weiweiweiopen/Solar-Oracle-Walkman-1.0/docs/gallery.md

# Solar Oracle Walkman — prototype and renders

## Physical prototype

Physical prototype in the studio

Photograph supplied by Shih Wei Chieh on November 10, 2026. A USB cable is connected. The photograph alone does not establish autonomous operation, calibration or which electrical revision is fitted.

## Two-capacitor charging concept — October 30, 2026

Charging concept front
Charging concept rear, two supercapacitors

From the Murata glass/RFID presentation assets. The source manufacturing revision is the November 3 charge-adg706 PCB paired with the November 5 R19_CHARGE_SUPERCAP enclosure. These illustrations predate that enclosure and are not assembly drawings.

## Earlier three-capacitor concept — September 30, 2026

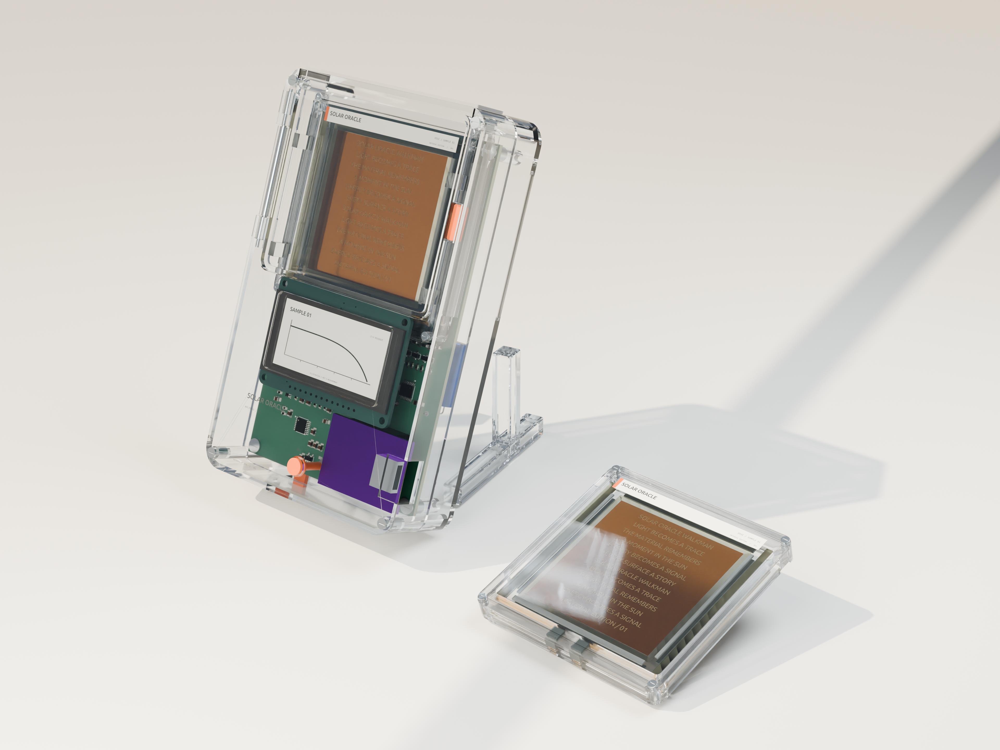
[picture p4: docs/images/render-front-3cap.png]
Earlier front render

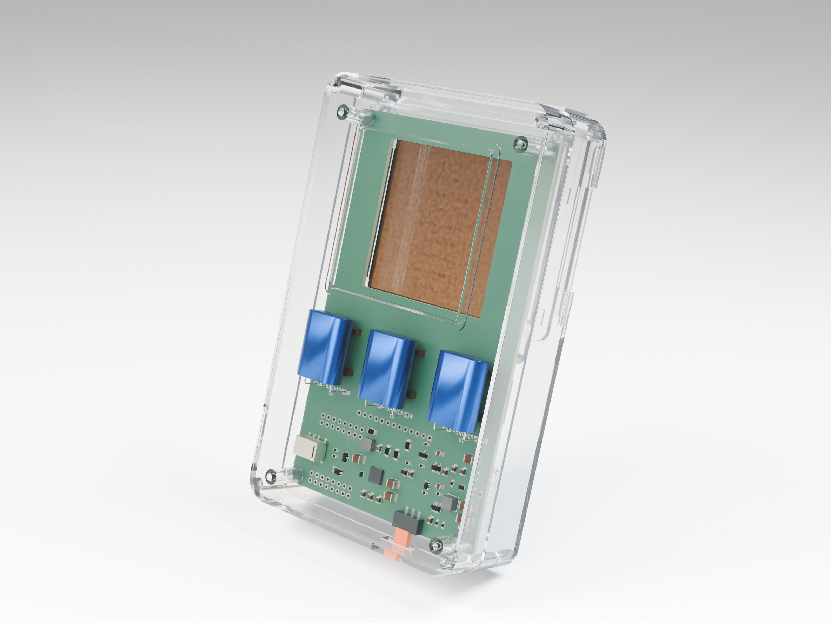
[picture p5: docs/images/render-rear-3cap.png]
Earlier rear render with three blue supercapacitors


From the Murata presentation assets. This is the earlier three-capacitor design, not the current two-capacitor charge-adg706 revision. Do not infer component placement or energy capacity for a current build from this image.

Original image filenames and SHA-256 checksums: [provenance](images/provenance.json).
