weiweiweiopen/Solar-Oracle-Walkman-1.0/enclosure/R19_RAW/STEP/R19_RAW_PRINTED_ASSEMBLY.step

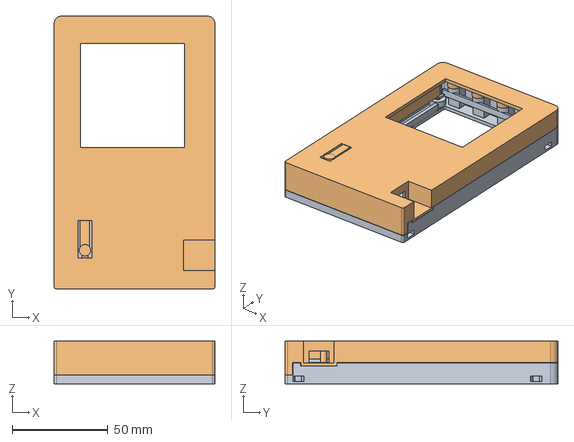
[picture p6: CAD file, 2026-11-10]
enclosure/R19_RAW/STEP/R19_RAW_PRINTED_ASSEMBLY.step
84.0 x 142.4 x 22.2 mm
