weiweiweiopen/Solar-Oracle-Walkman-1.0/enclosure/R19_CHARGE_SUPERCAP/STEP/R19_CHARGE_SUPERCAP_PRINTED_ASSEMBLY.step

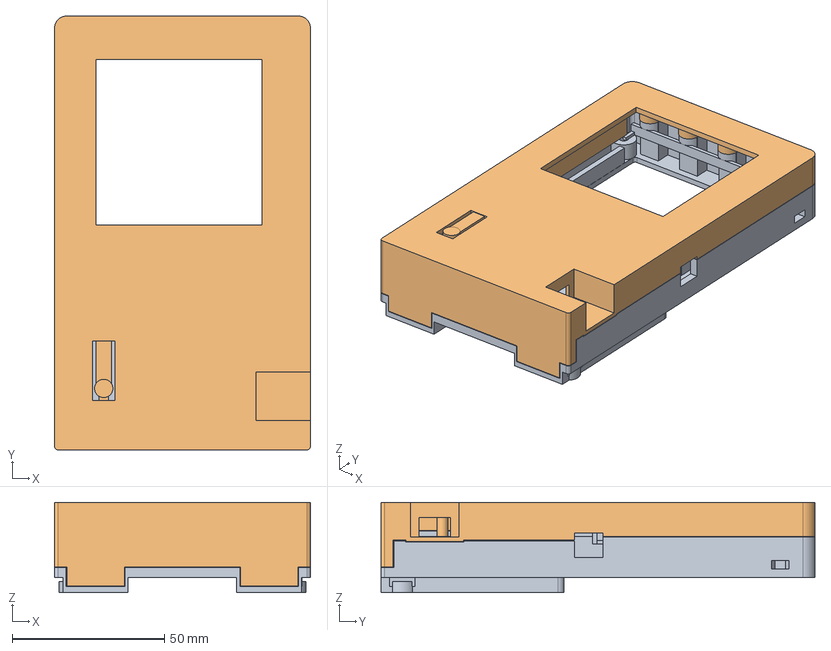
[picture p7: CAD file, 2026-11-10]
enclosure/R19_CHARGE_SUPERCAP/STEP/R19_CHARGE_SUPERCAP_PRINTED_ASSEMBLY.step
84.0 x 142.4 x 29.6 mm
