weiweiweiopen/Solar-Oracle-Walkman-1.0/enclosure/R19_CHARGE_SUPERCAP/R19_CHARGE_SUPERCAP.FCStd

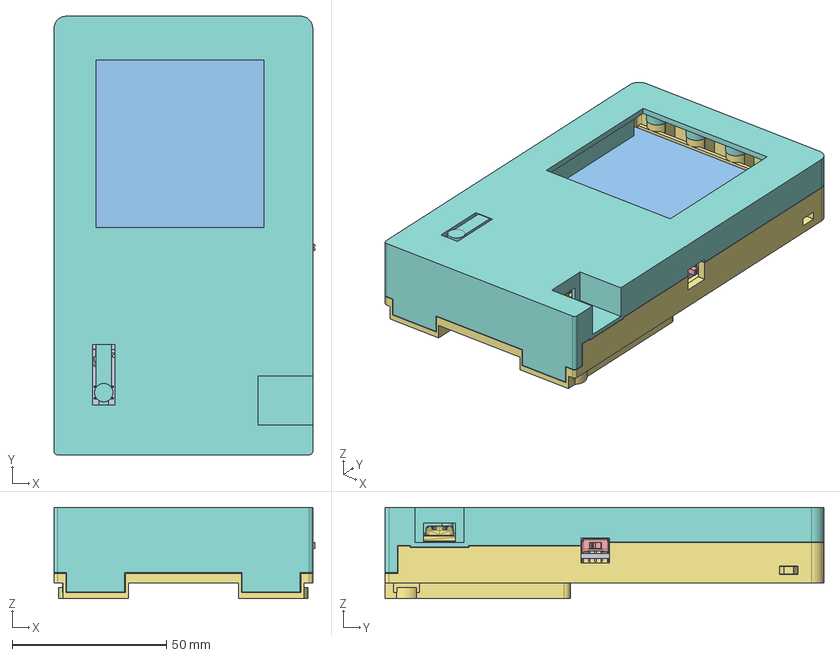
[picture p8: CAD file, 2026-11-10]
enclosure/R19_CHARGE_SUPERCAP/R19_CHARGE_SUPERCAP.FCStd
84.7 x 142.4 x 29.6 mm
Carrier_board
PCB_R9
PCB_R3
PCB_C4
PCB_R18
PCB_R4
PCB_R5
PCB_C5
DSSC_pad_1
DSSC_pad_2
PCB_R23
PCB_C317
PCB_U1
PCB_R19
PCB_R13
PCB_R12
PCB_R22
PCB_R21
PCB_U214
PCB_R24
PCB_R8
PCB_R15
PCB_R16
PCB_SW1
PCB_C2
PCB_C3
PCB_R10
PCB_R17
PCB_JP201
PCB_R1
PCB_R11
PCB_R14
Epaper_module
PCB_U2
PCB_R7
PCB_R2
PCB_R6
PCB_C1
ESP32_module
PCB_R20
PCB_R286
PCB_C336
PCB_Q217
PCB_U211
PCB_R290
Envelope_U207
PCB_C304
PCB_R284
PCB_C312
PCB_C307
PCB_C313
PCB_C308
PCB_C315
Supercap_67_45
PCB_R319
Envelope_L201
PCB_Q218
PCB_C305
PCB_R320
PCB_R323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
