weiweiweiopen/Solar-Oracle-Walkman-1.0/enclosure/R19_RAW/R19_RAW.FCStd

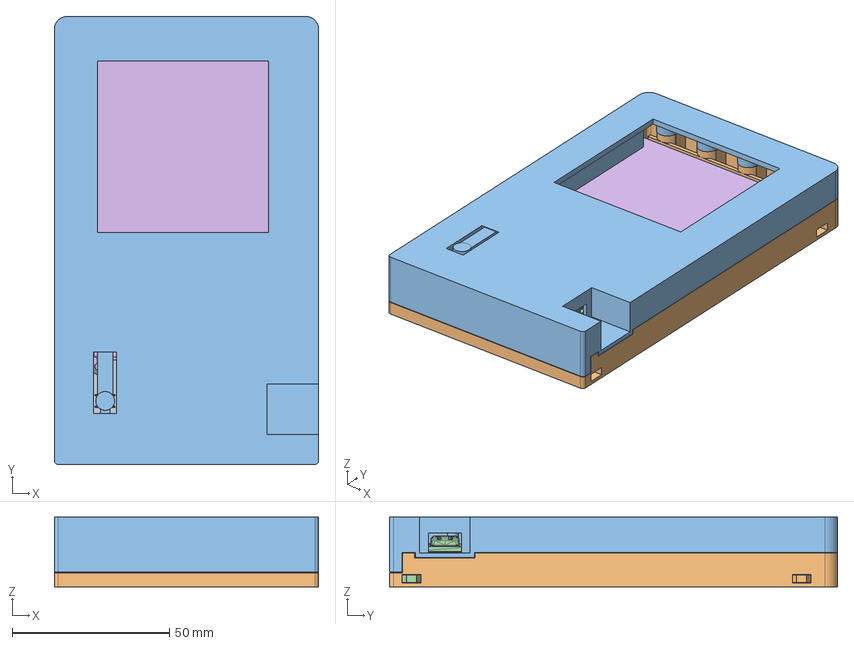
[picture p10: CAD file, 2026-11-10]
enclosure/R19_RAW/R19_RAW.FCStd
84.0 x 142.4 x 22.2 mm
Carrier_board
PCB_R9
PCB_R3
PCB_C4
PCB_R18
PCB_R4
PCB_R5
PCB_C5
DSSC_pad_1
DSSC_pad_2
PCB_R23
PCB_U1
PCB_R19
PCB_R13
PCB_R12
PCB_R22
PCB_R21
PCB_R24
PCB_R8
PCB_R15
PCB_R16
PCB_SW1
PCB_C2
PCB_C3
PCB_R10
PCB_R17
PCB_R1
PCB_R11
PCB_R14
Epaper_module
PCB_U2
PCB_R7
PCB_R2
PCB_R6
PCB_C1
ESP32_raw_module
PCB_R20
DSSC_upper_glass_66
DSSC_lower_glass
Zebra_0
Zebra_1
PCB_nut_H2
PCB_screw_H2
PCB_nut_H4
PCB_screw_H4
PCB_nut_H1
PCB_screw_H1
PCB_nut_H3
PCB_screw_H3
Magnet_lower_0
Magnet_lower_1
Magnet_lower_2
Magnet_lower_3
Magnet_lower_4
Magnet_lower_5
Magnet_lower_6
Magnet_lower_7
Magnet_upper_0
Magnet_upper_1
Magnet_upper_2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
