weiweiweiopen/Solar-Oracle-Walkman-1.0/hardware/charge-adg706/KiCad/models/Relay_DPDT_Omron_G6K-2F-Y.step

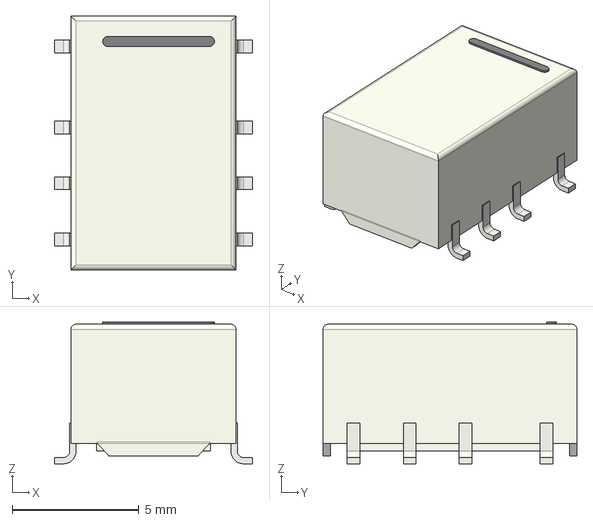
[picture p11: CAD file, 2026-09-20]
hardware/charge-adg706/KiCad/models/Relay_DPDT_Omron_G6K-2F-Y.step
7.80 x 10.0 x 5.58 mm
