weiweiweiopen/Solar-Oracle-Walkman-1.0/enclosure/R19_CHARGE_SUPERCAP/STEP/Upper_cover.step

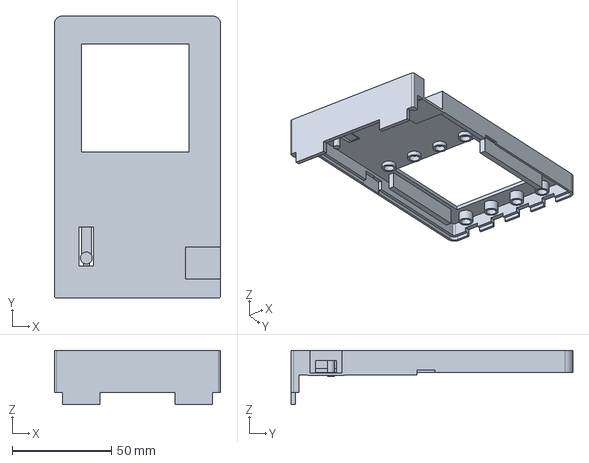
[picture p12: CAD file, 2026-11-10]
enclosure/R19_CHARGE_SUPERCAP/STEP/Upper_cover.step
84.0 x 142.4 x 27.4 mm
