weiweiweiopen/Solar-Oracle-Walkman-1.0/enclosure/R19_RAW/STEP/Upper_cover.step

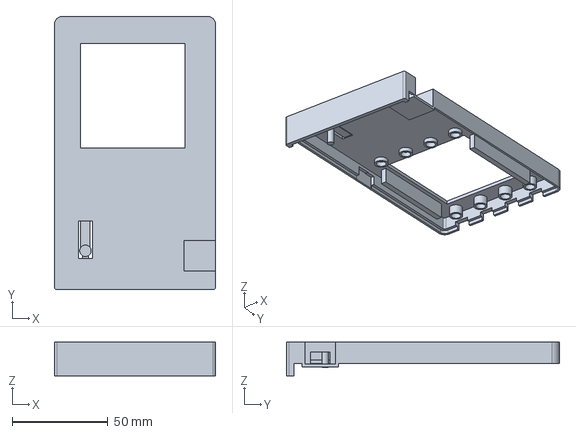
[picture p13: CAD file, 2026-11-10]
enclosure/R19_RAW/STEP/Upper_cover.step
84.0 x 142.4 x 17.5 mm
