weiweiweiopen/Solar-Oracle-Walkman-1.0/enclosure/R19_RAW/STEP/Lower_shell.step

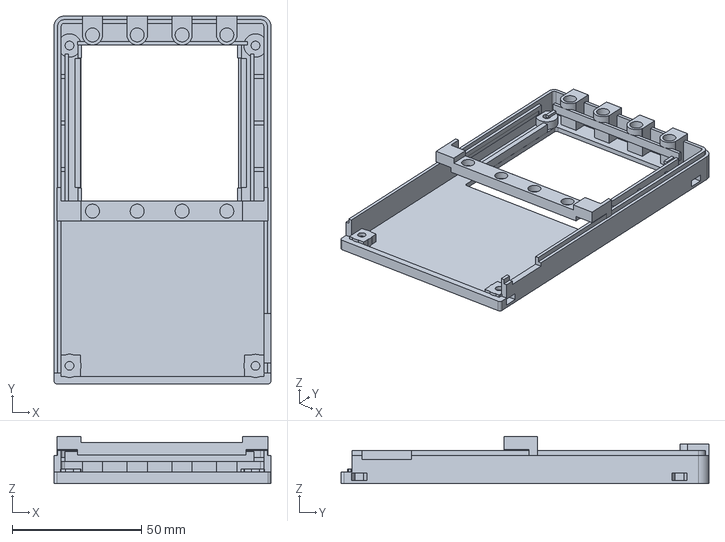
[picture p14: CAD file, 2026-11-10]
enclosure/R19_RAW/STEP/Lower_shell.step
84.0 x 142.4 x 18.2 mm
