weiweiweiopen/Solar-Oracle-Walkman-1.0/docs/schematic.pdf

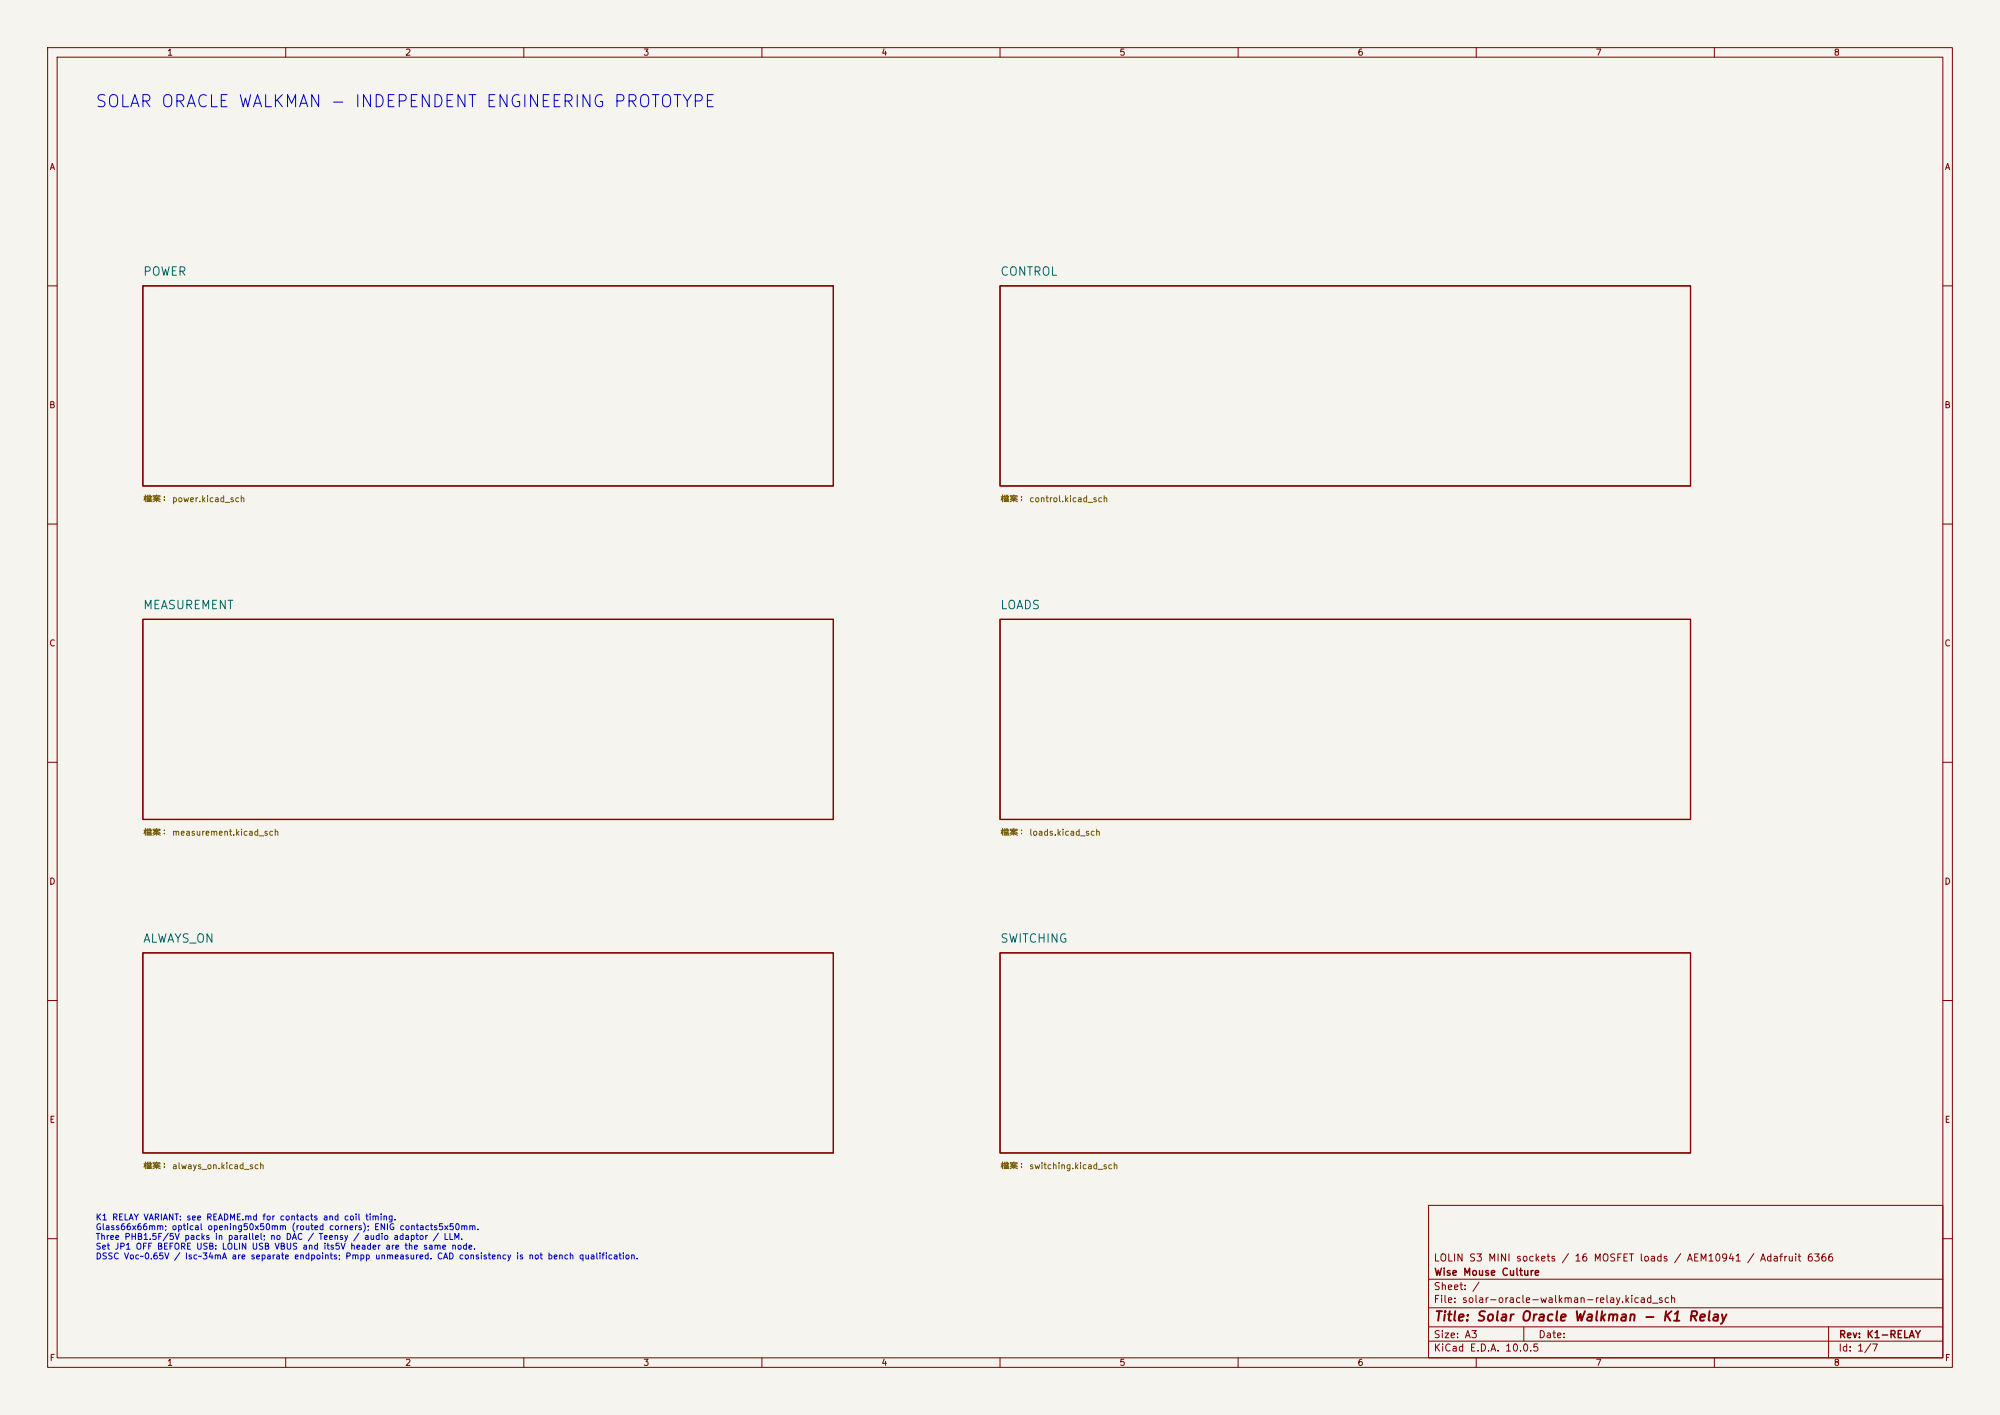
[picture p22: page 1]

檔案： measurement.kicad_sch SOLAR ORACLE WALKMAN - INDEPENDENT ENGINEERING PROTOTYPE

K1 RELAY VARIANT: see README.md for contacts and coil timing.
Glass66x66mm; optical opening50x50mm (routed corners); ENIG contacts5x50mm. Three PHB1.5F/5V packs in parallel; no DAC / Teensy / audio adaptor / LLM. Set JP1 OFF BEFORE USB: LOLIN USB VBUS and its5V header are the same node. DSSC Voc~0.65V / Isc~34mA are separate endpoints; Pmpp unmeasured. CAD consistency is not bench qualification.

LOLIN S3 MINI sockets / 16 MOSFET loads / AEM10941 / Adafruit 6366
Wise Mouse Culture
Sheet: /
File: solar-oracle-walkman-relay.kicad_sch
Title: Solar Oracle Walkman - K1 Relay

Size: A3 | Rev: K1-RELAY | F Date:
KiCad E.D.A. 10.0.5 | Id: 1/7

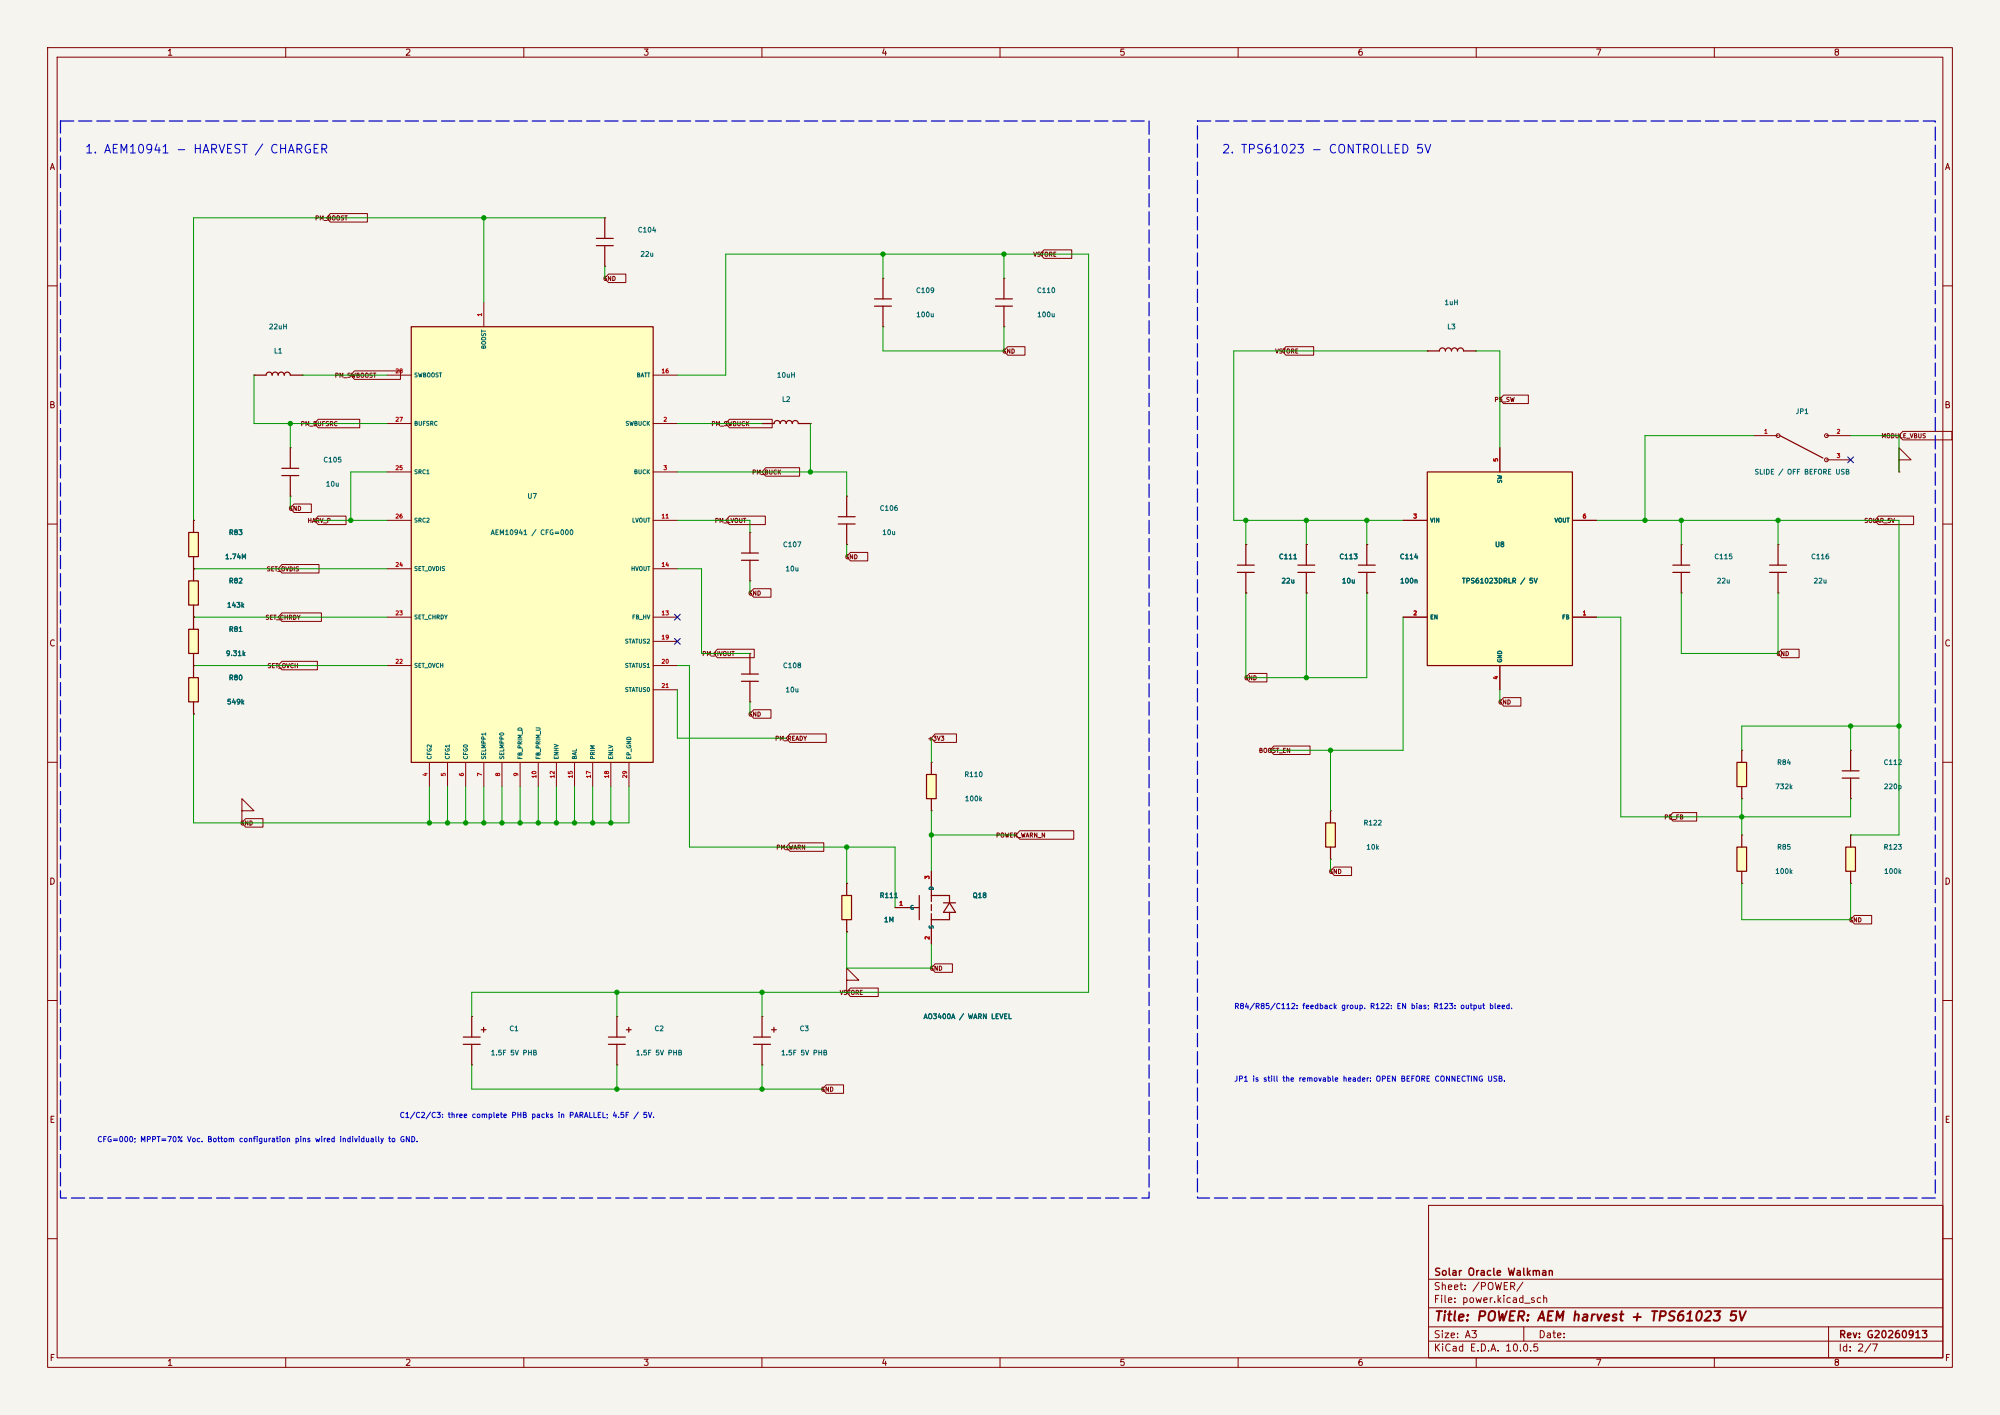
[picture p23: page 2]

SLIDE / OFF BEFORE USB BOOST 1

R84/R85/C112: feedback group. R122: EN bias; R123: output bleed. JP1 is still the removable header: OPEN BEFORE CONNECTING USB. CFG=000; MPPT=70% Voc. Bottom configuration pins wired individually to GND. C1/C2/C3: three complete PHB packs in PARALLEL; 4.5F / 5V.

Solar Oracle Walkman
Sheet: /POWER/
File: power.kicad_sch
Title: POWER: AEM harvest + TPS61023 5V

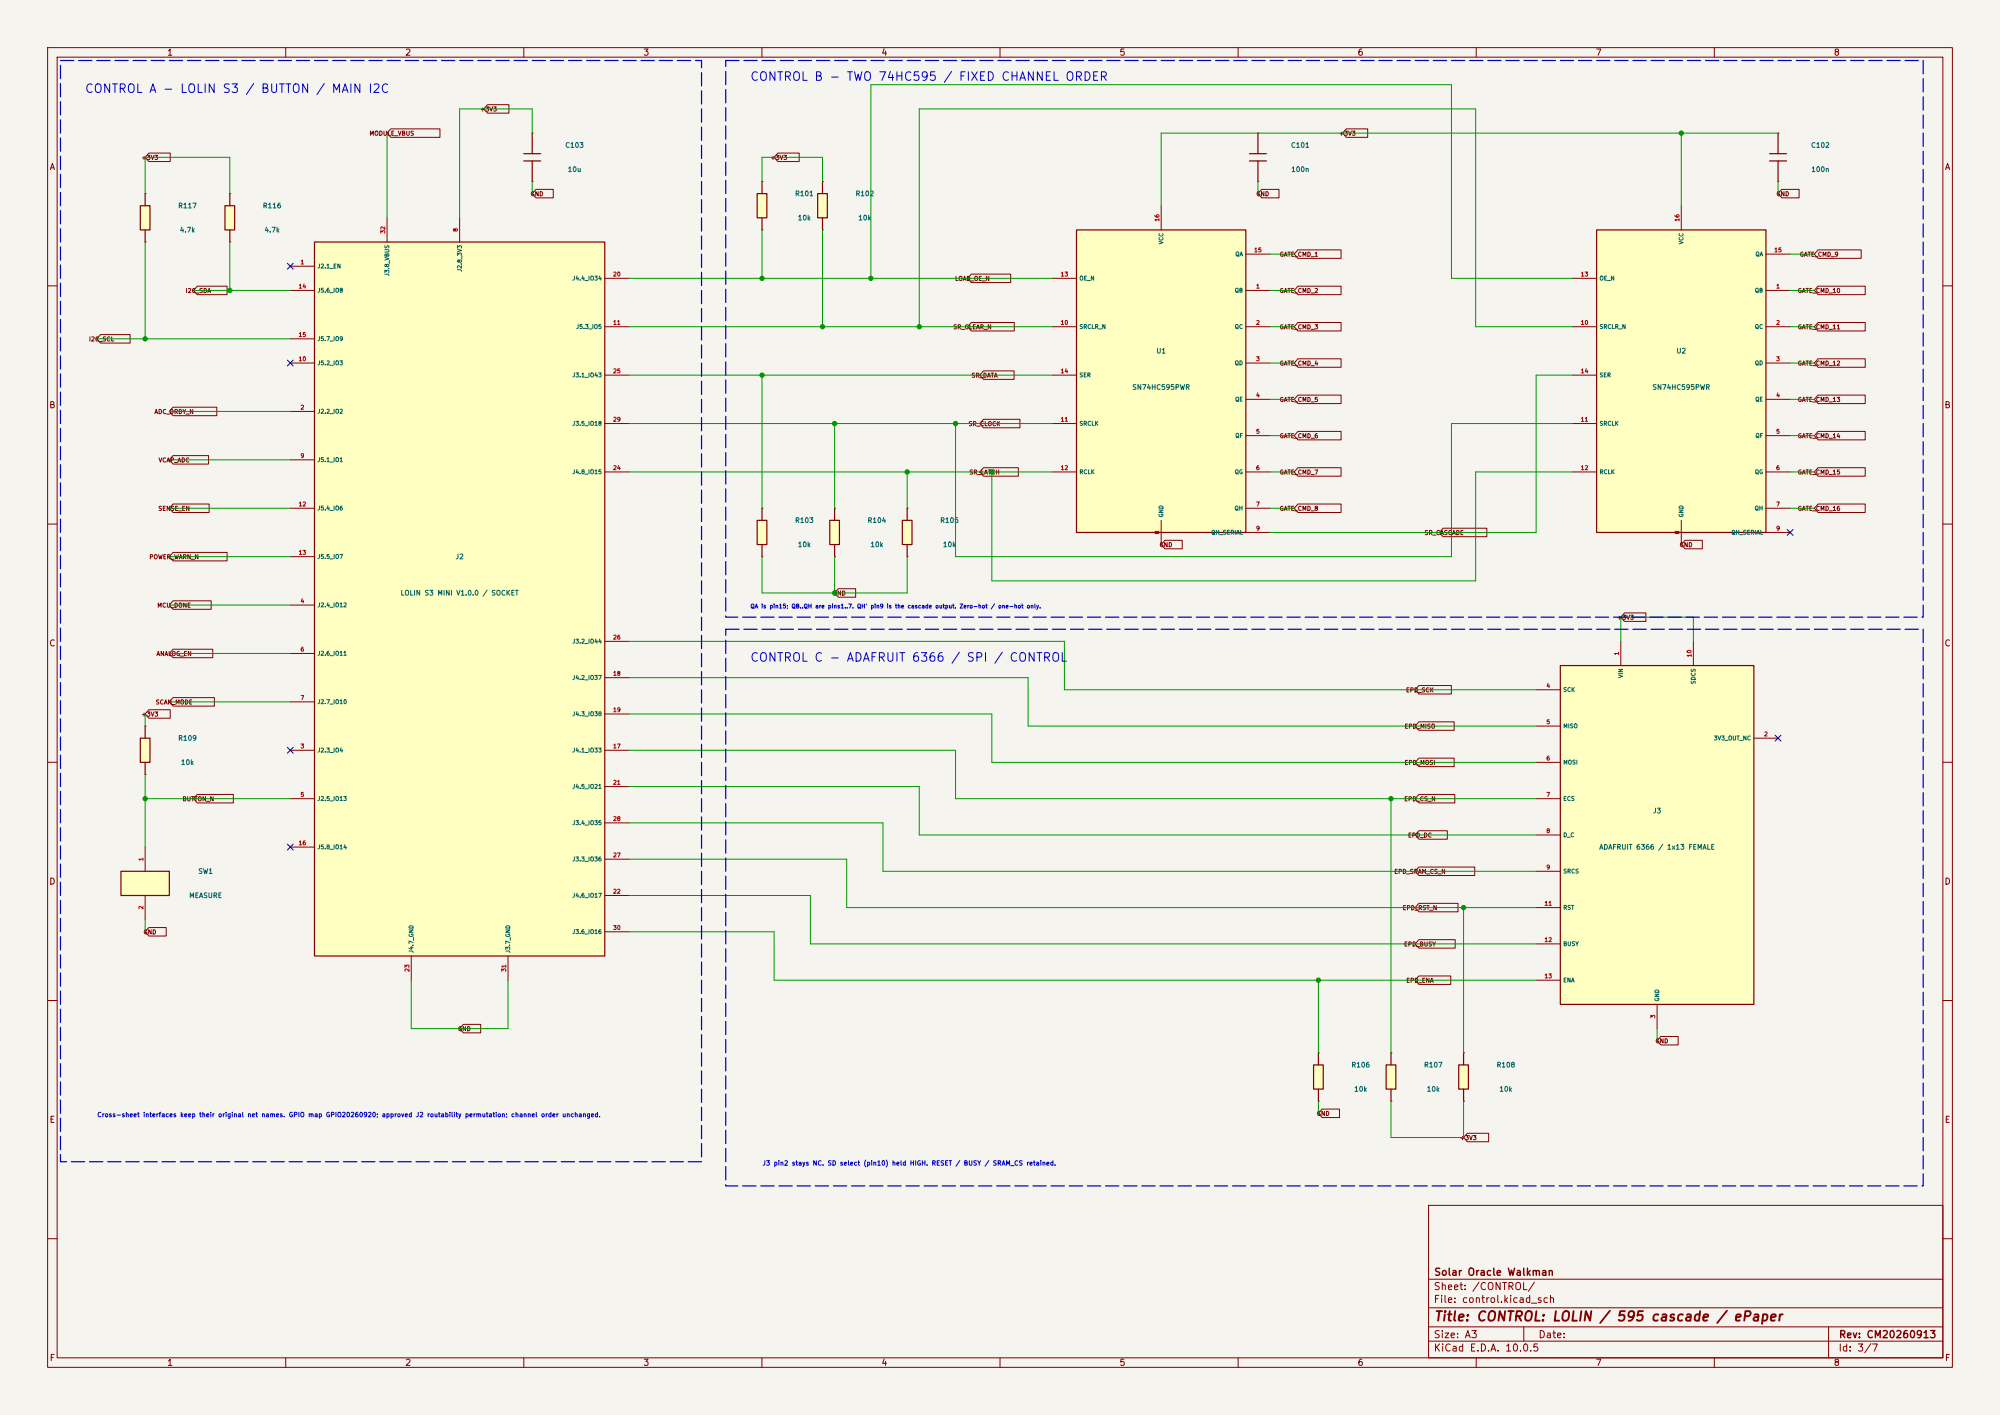
[picture p24: page 3]

CONTROL A - LOLIN S3 / BUTTON / MAIN I2C

CONTROL C - ADAFRUIT 6366 / SPI / CONTROL

J3 pin2 stays NC. SD select (pin10) held HIGH. RESET / BUSY / SRAM_CS retained. Cross-sheet interfaces keep their original net names. GPIO map GPIO20260920; approved J2 routability permutation; channel order unchanged.

Solar Oracle Walkman
Sheet: /CONTROL/
File: control.kicad_sch
Title: CONTROL: LOLIN / 595 cascade / ePaper

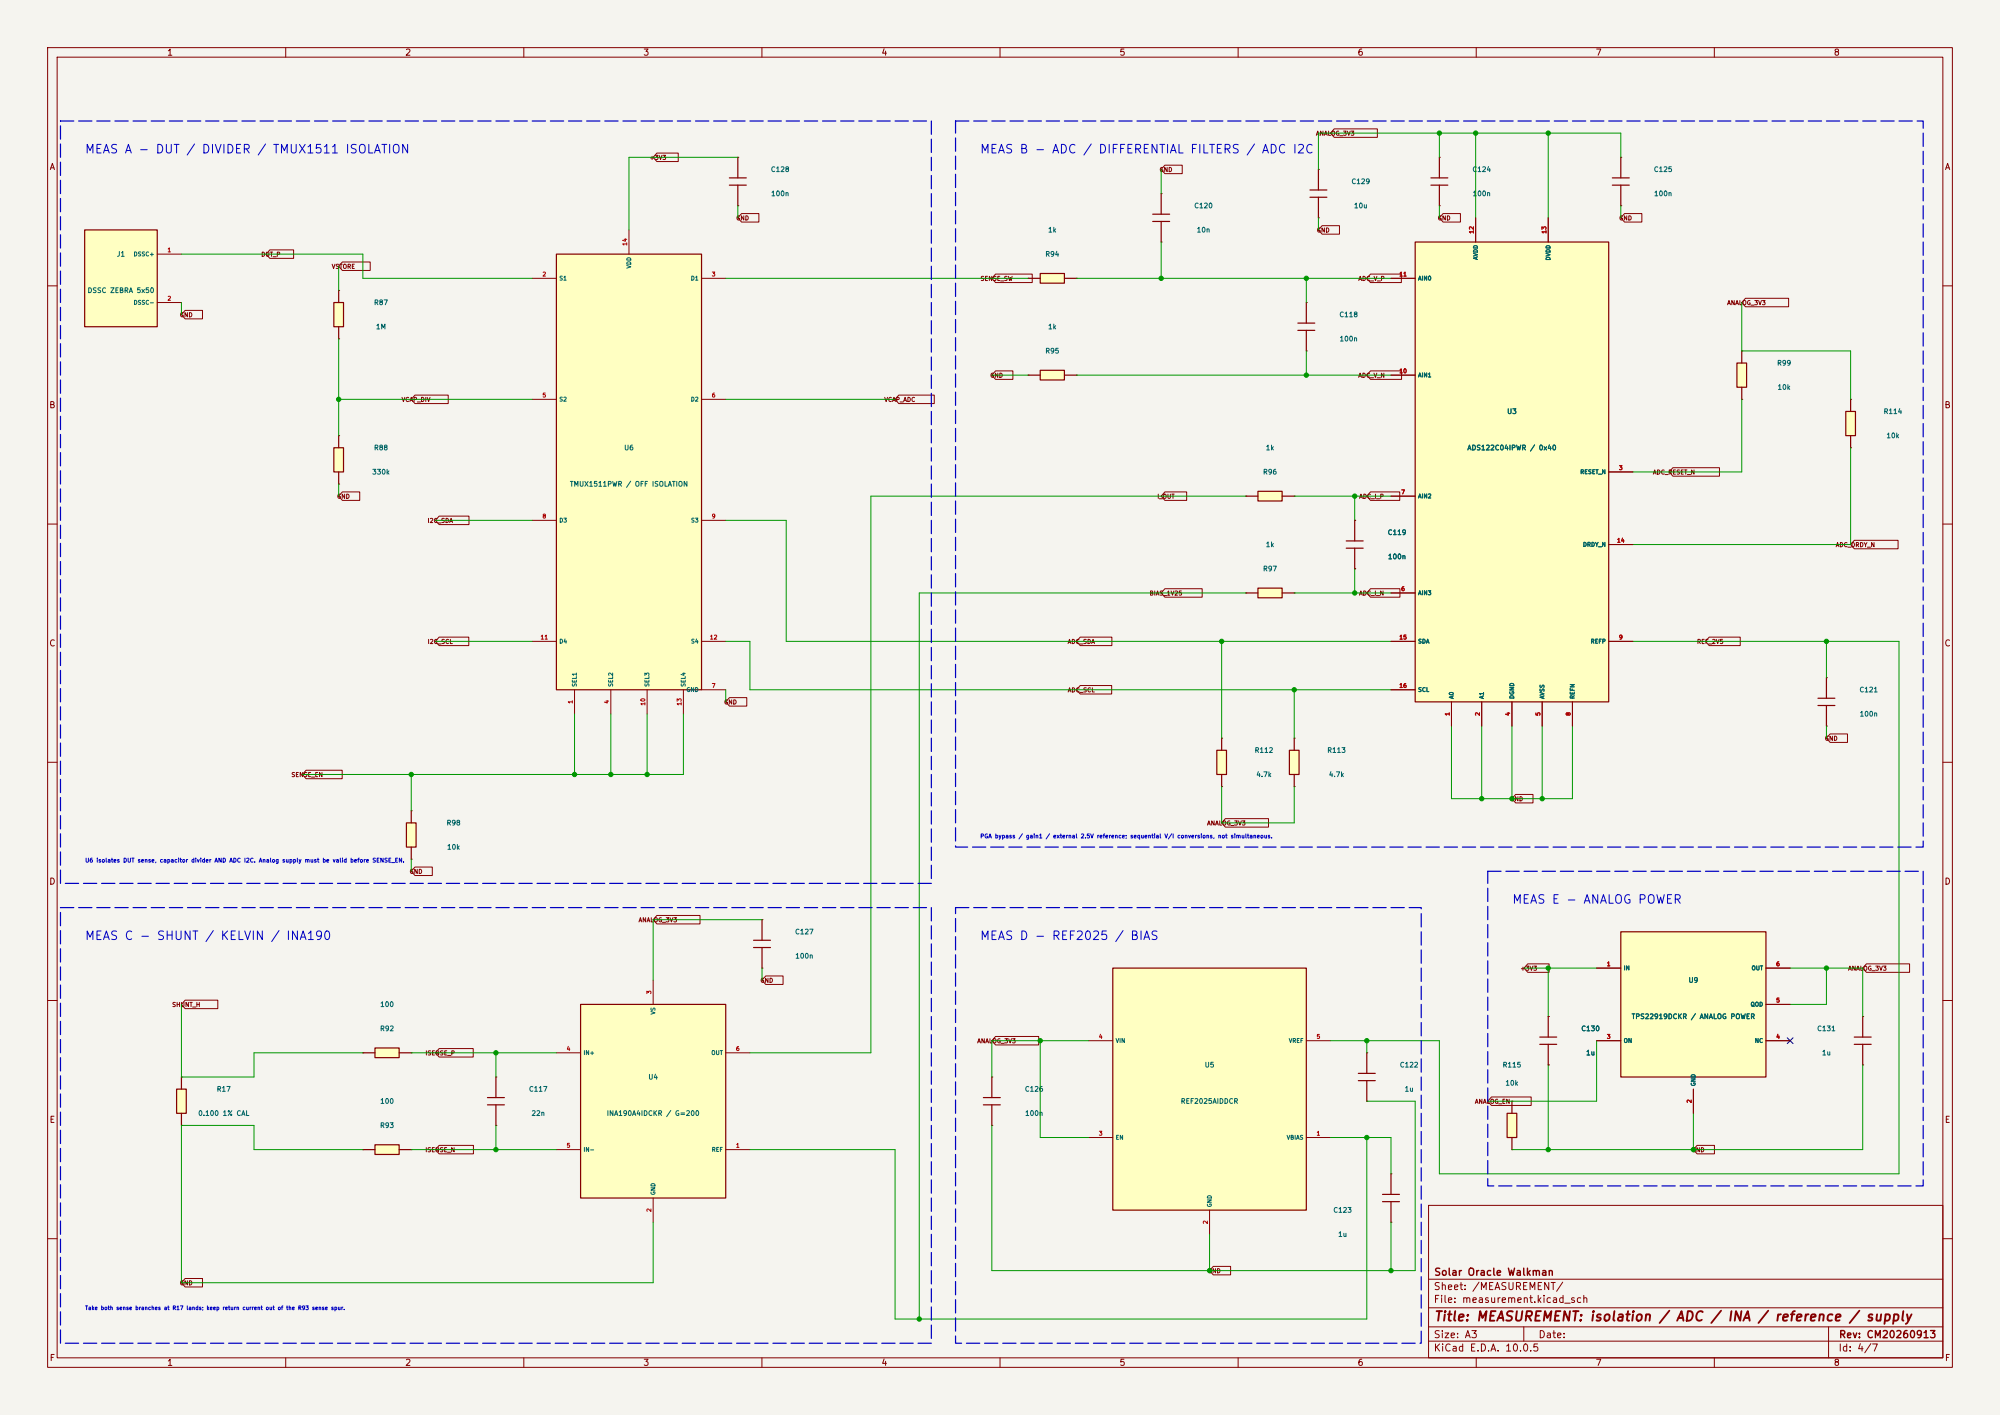
[picture p25: page 4]

GND MEAS A - DUT / DIVIDER / TMUX1511 ISOLATION

MEAS B - ADC / DIFFERENTIAL FILTERS / ADC I2C

PGA bypass / gain1 / external 2.5V reference; sequential V/I conversions, not simultaneous. MEAS C - SHUNT / KELVIN / INA190

Solar Oracle Walkman
Sheet: /MEASUREMENT/
File: measurement.kicad_sch
Title: MEASUREMENT: isolation / ADC / INA / reference / supply

Take both sense branches at R17 lands; keep return current out of the R93 sense spur.

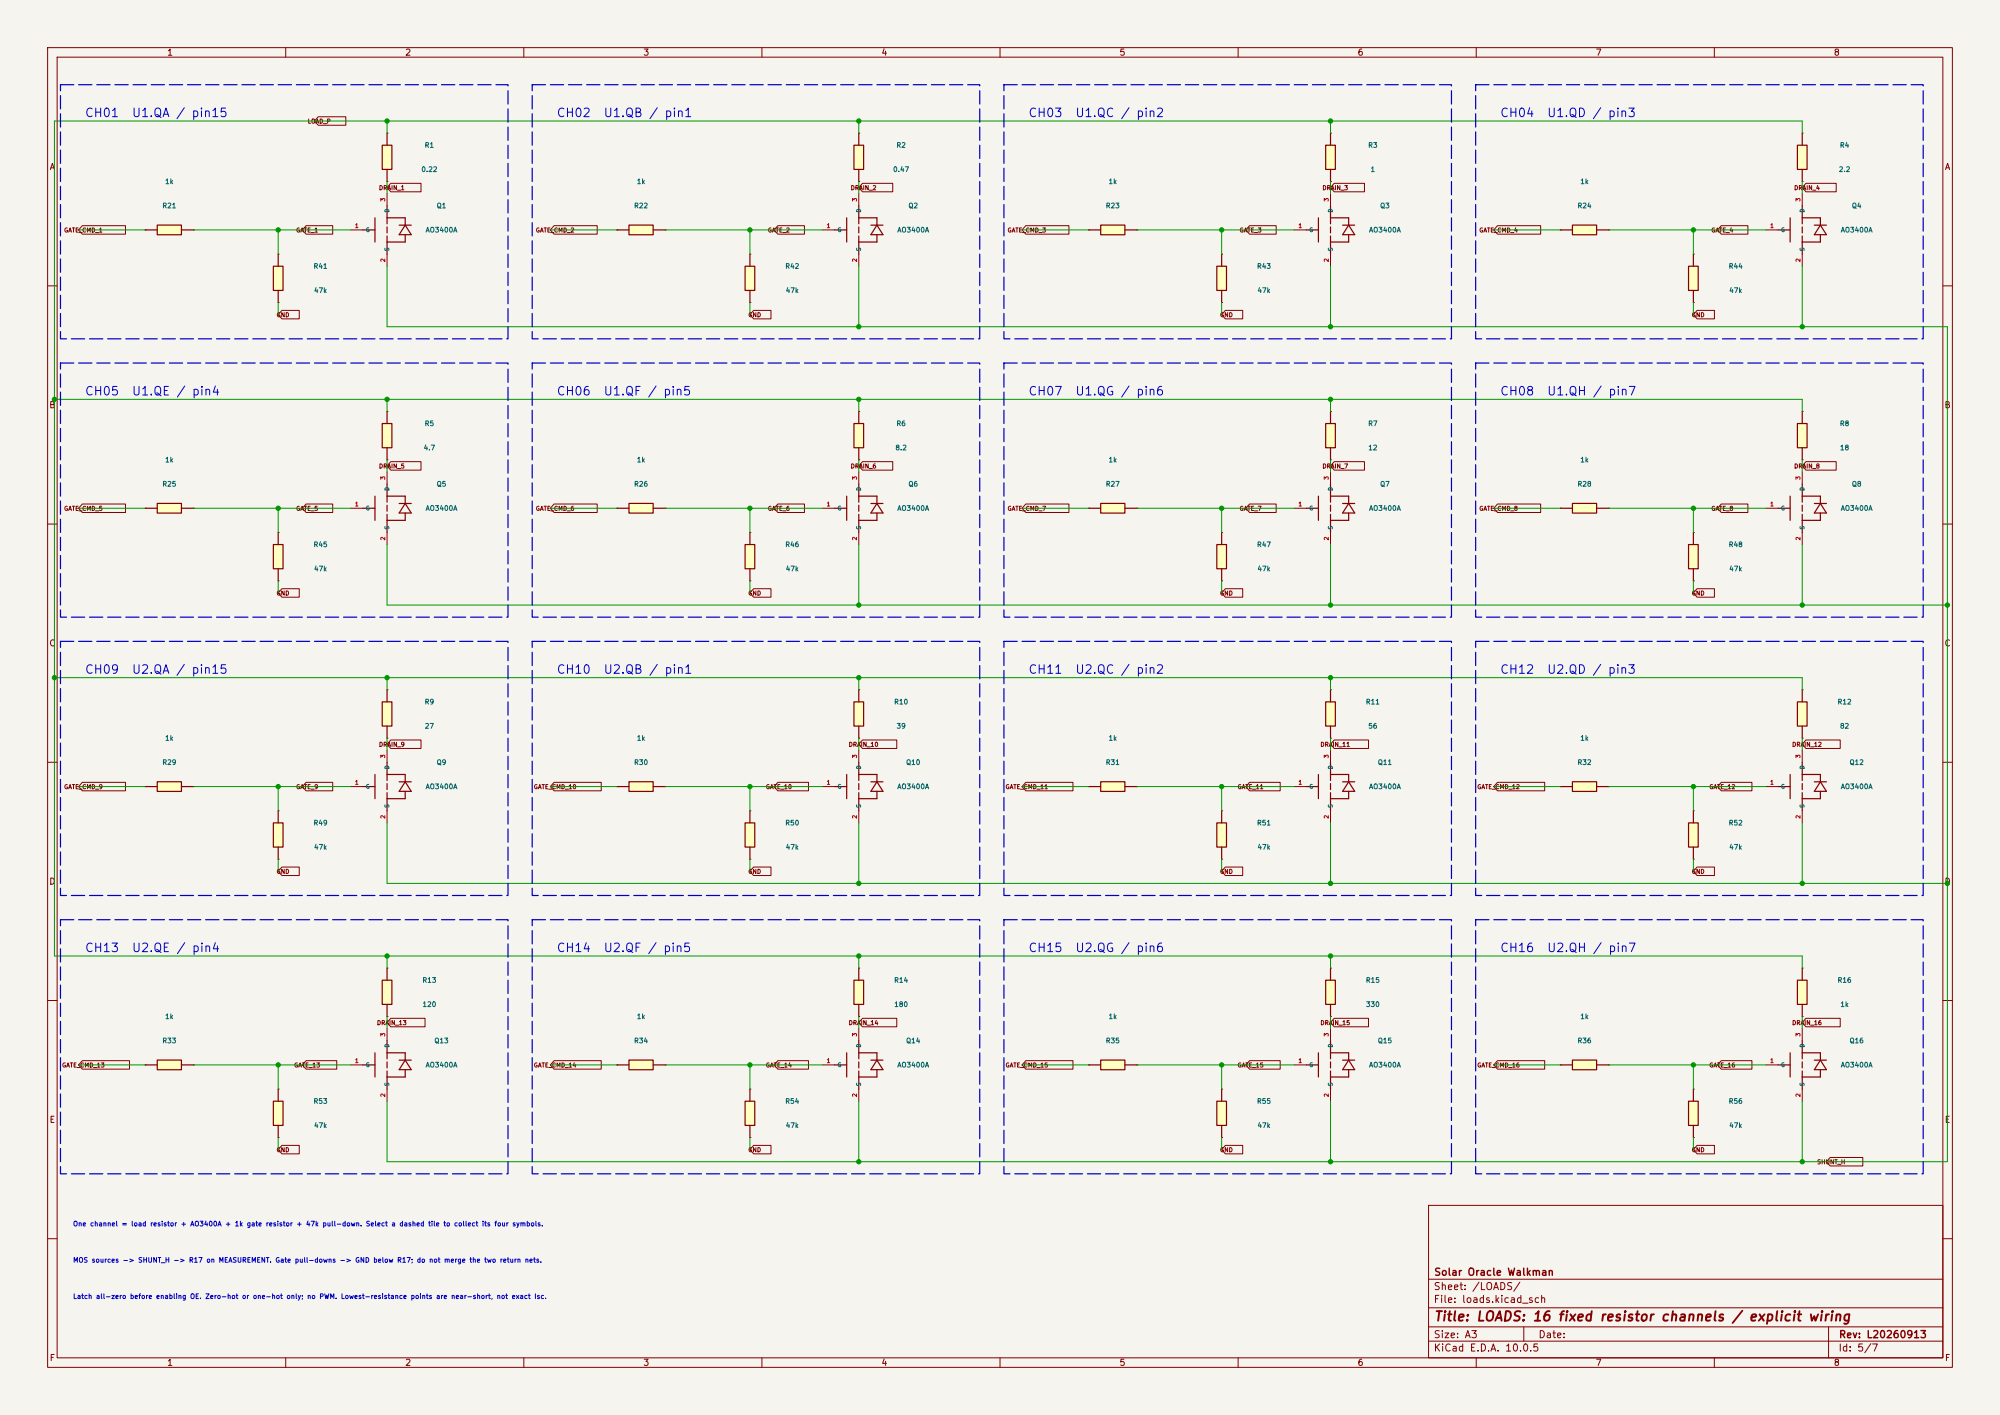
[picture p26: page 5]

One channel = load resistor + AO3400A + 1k gate resistor + 47k pull-down. Select a dashed tile to collect its four symbols. CH09 U2.QA / pin15

MOS sources -> SHUNT_H -> R17 on MEASUREMENT. Gate pull-downs -> GND below R17; do not merge the two return nets.

Solar Oracle Walkman
Sheet: /LOADS/
File: loads.kicad_sch
Title: LOADS: 16 fixed resistor channels / explicit wiring

Latch all-zero before enabling OE. Zero-hot or one-hot only; no PWM. Lowest-resistance points are near-short, not exact Isc.

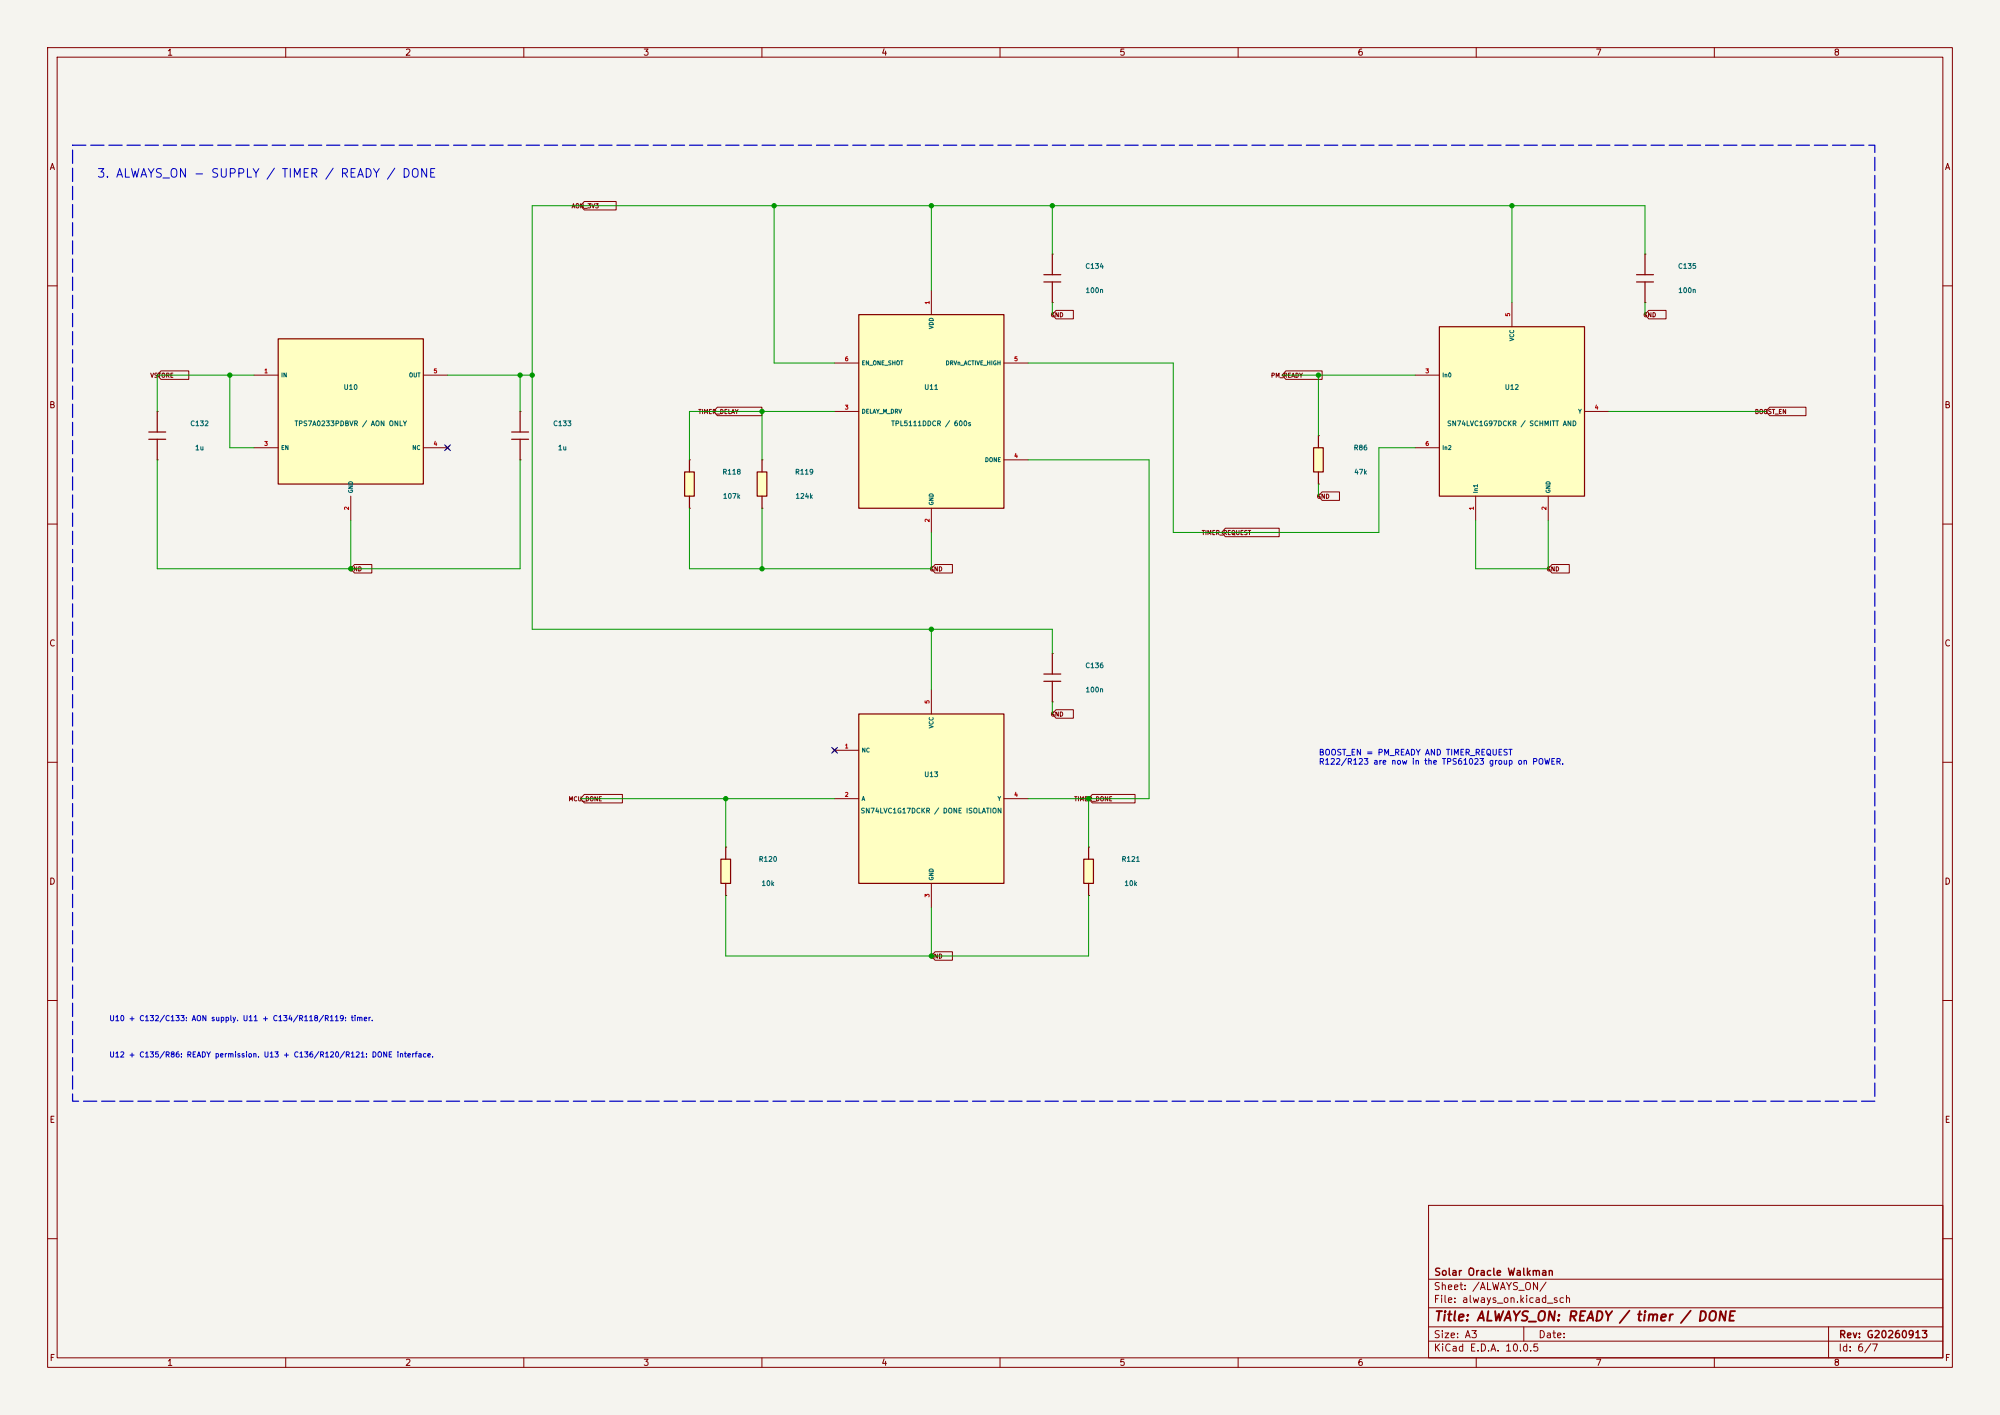
[picture p27: page 6]

3. ALWAYS_ON - SUPPLY / TIMER / READY / DONE

GND BOOST_EN = PM_READY AND TIMER_REQUEST R122/R123 are now in the TPS61023 group on POWER. U10 + C132/C133: AON supply. U11 + C134/R118/R119: timer. U12 + C135/R86: READY permission. U13 + C136/R120/R121: DONE interface.

Solar Oracle Walkman
Sheet: /ALWAYS_ON/
File: always_on.kicad_sch
Title: ALWAYS_ON: READY / timer / DONE

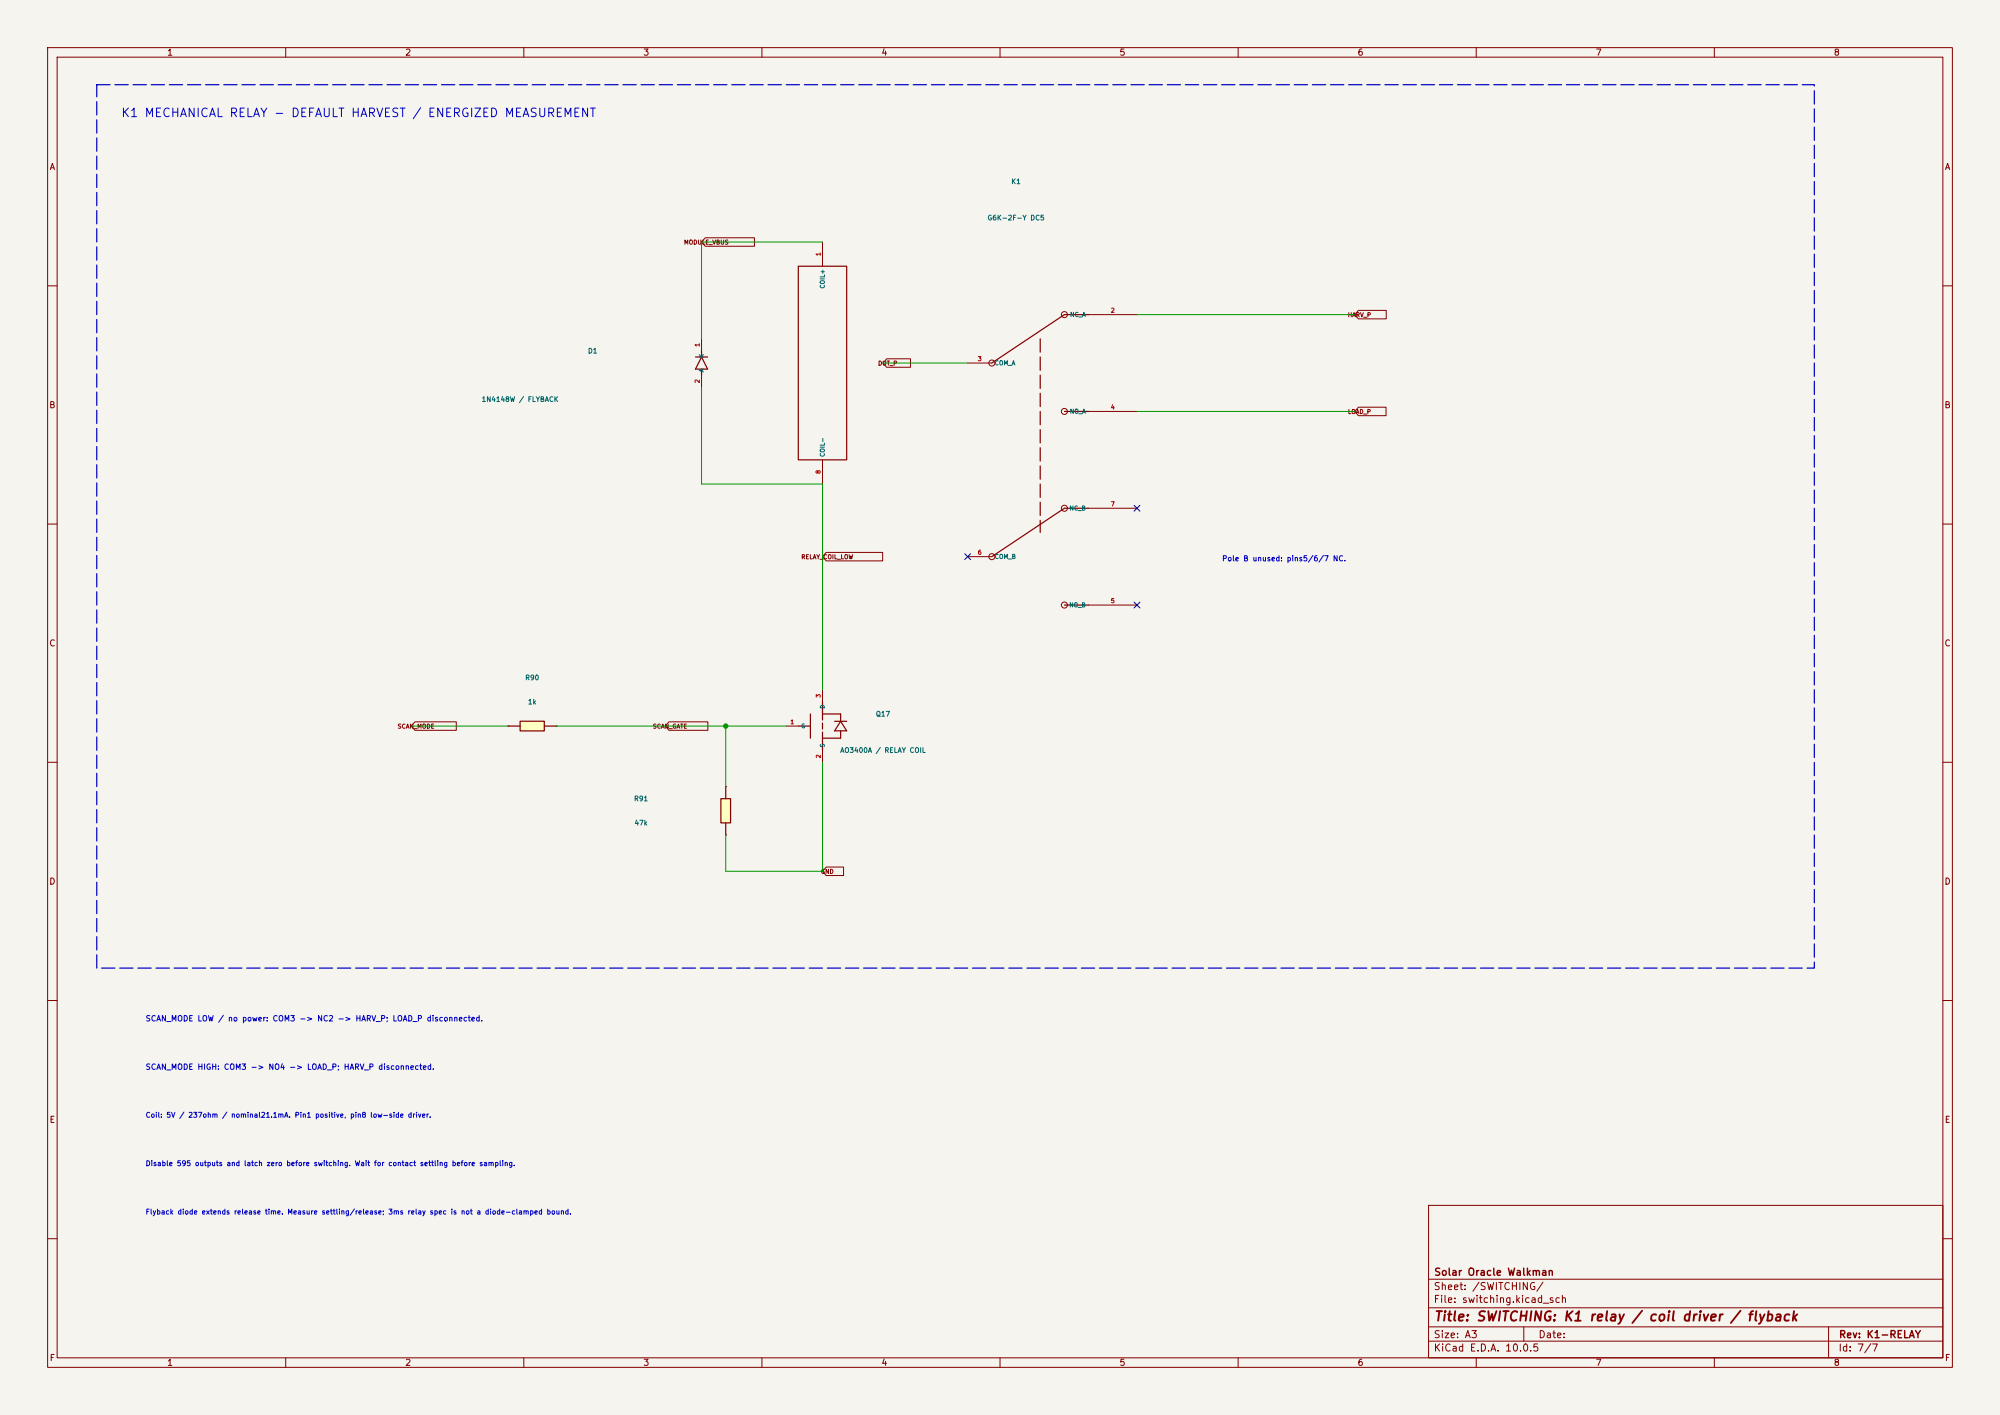
[picture p28: page 7]

K1 MECHANICAL RELAY - DEFAULT HARVEST / ENERGIZED MEASUREMENT

Disable 595 outputs and latch zero before switching. Wait for contact settling before sampling. SCAN_MODE LOW / no power: COM3 -> NC2 -> HARV_P; LOAD_P disconnected. Coil: 5V / 237ohm / nominal21.1mA. Pin1 positive, pin8 low-side driver. Flyback diode extends release time. Measure settling/release; 3ms relay spec is not a diode-clamped bound.

Solar Oracle Walkman
Sheet: /SWITCHING/
File: switching.kicad_sch
Title: SWITCHING: K1 relay / coil driver / flyback
