weiweiweiopen/Solar-Oracle-Walkman-1.0/hardware/charge-adg706/KiCad/Marc_USB.kicad_pcb

## KiCad design hardware/charge-adg706/KiCad/Marc_USB.kicad_pcb (2026-11-10)

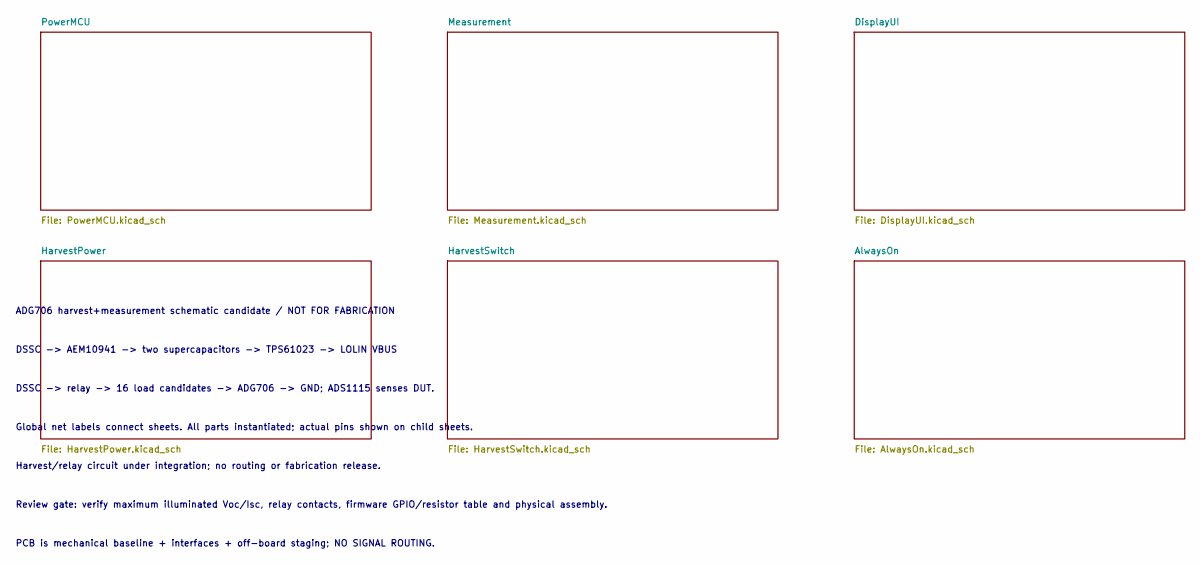
[picture p29: schematic Marc_USB.kicad_sch, Marc USB - Integrated draft]

Notes on the sheet:
PCB is mechanical baseline + interfaces + off-board staging; NO SIGNAL ROUTING.
Global net labels connect sheets. All parts instantiated; actual pins shown on child sheets.
ADG706 harvest+measurement schematic candidate / NOT FOR FABRICATION
Review gate: verify maximum illuminated Voc/Isc, relay contacts, firmware GPIO/resistor table and physical assembly.
DSSC -> AEM10941 -> two supercapacitors -> TPS61023 -> LOLIN VBUS
DSSC -> relay -> 16 load candidates -> ADG706 -> GND; ADS1115 senses DUT.
Harvest/relay circuit under integration; no routing or fabrication release.

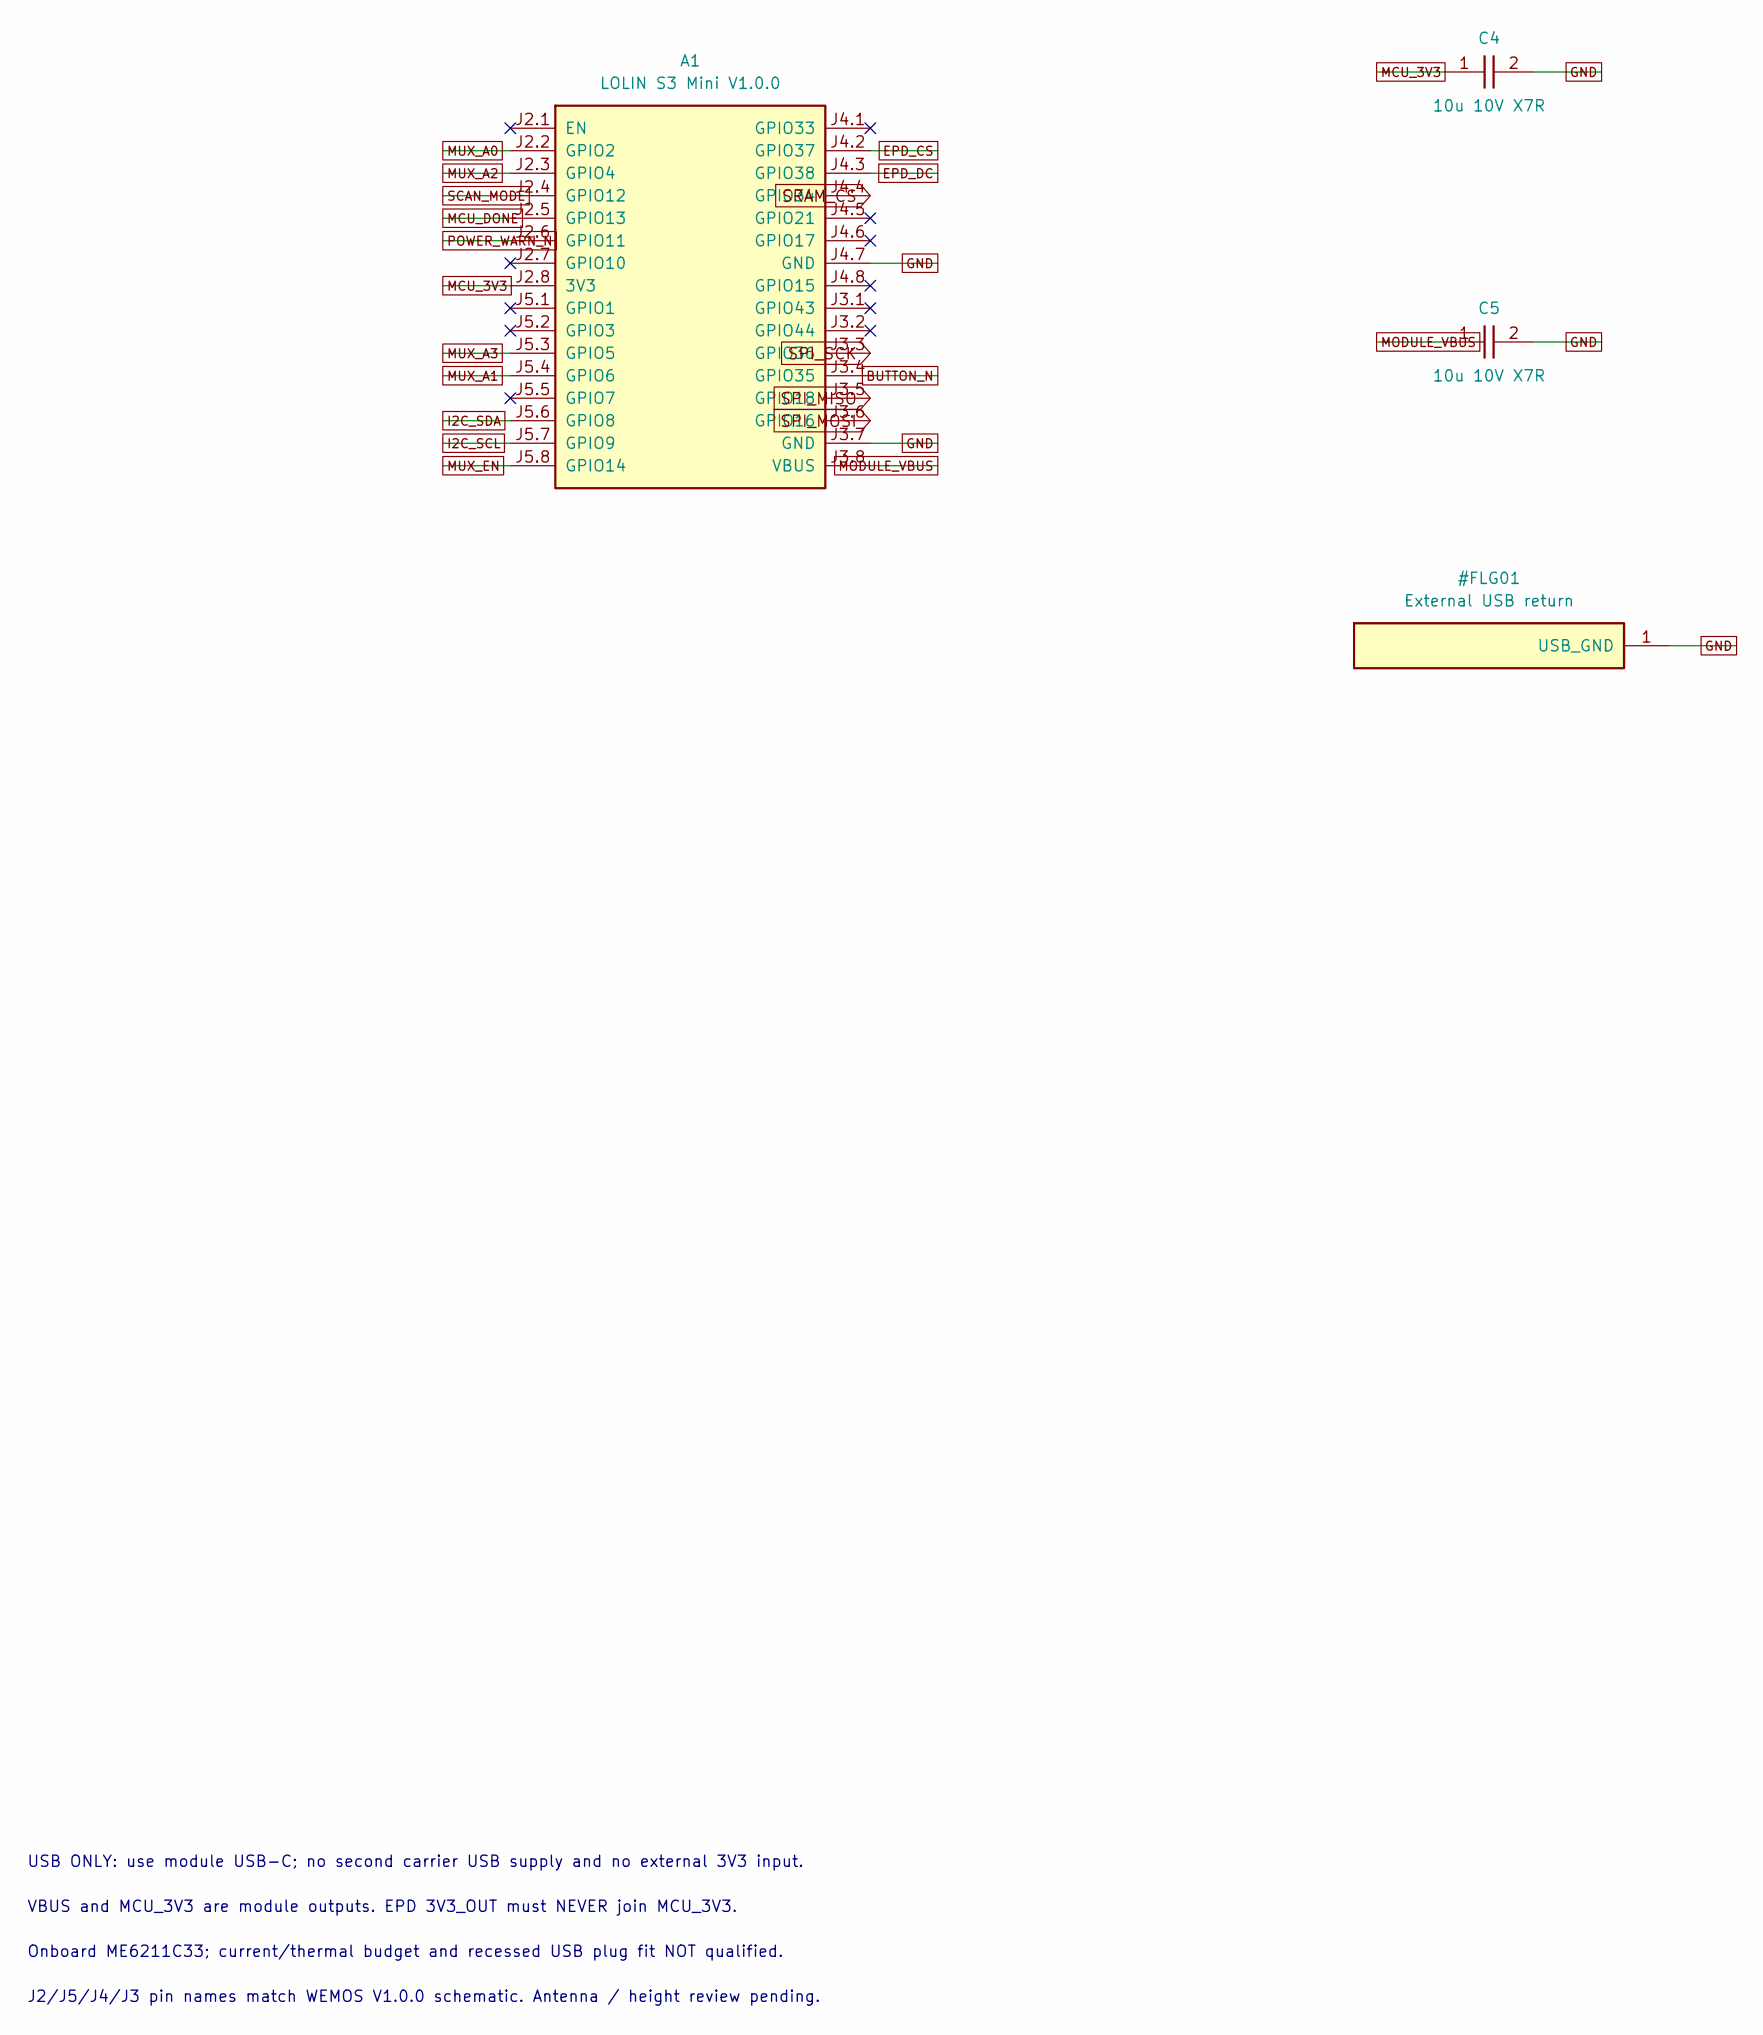
[picture p30: schematic PowerMCU.kicad_sch, Marc USB - PowerMCU - DRAFT NOT FOR FAB]

Parts:
A1: LOLIN S3 Mini V1.0.0; LOLIN_S3_MINI_V1; MPN LOLIN S3 MINI V1.0.0
C4, C5: 10u 10V X7R; C_0805_2012Metric

Connections:
BUTTON_N: A1.J3.4 (GPIO35); also elsewhere on the board
EPD_CS: A1.J4.2 (GPIO37); also elsewhere on the board
EPD_DC: A1.J4.3 (GPIO38); also elsewhere on the board
GND: A1.J3.7 (GND), A1.J4.7 (GND), C4.2, C5.2; also elsewhere on the board
I2C_SCL: A1.J5.7 (GPIO9); also elsewhere on the board
I2C_SDA: A1.J5.6 (GPIO8); also elsewhere on the board
MCU_3V3: A1.J2.8 (3V3), C4.1; also elsewhere on the board
MCU_DONE: A1.J2.5 (GPIO13); also elsewhere on the board
MODULE_VBUS: A1.J3.8 (VBUS), C5.1; also elsewhere on the board
MUX_A0: A1.J2.2 (GPIO2); also elsewhere on the board
MUX_A1: A1.J5.4 (GPIO6); also elsewhere on the board
MUX_A2: A1.J2.3 (GPIO4); also elsewhere on the board
MUX_A3: A1.J5.3 (GPIO5); also elsewhere on the board
MUX_EN: A1.J5.8 (GPIO14); also elsewhere on the board
POWER_WARN_N: A1.J2.6 (GPIO11); also elsewhere on the board
SCAN_MODE: A1.J2.4 (GPIO12); also elsewhere on the board
SPI_MISO: A1.J3.5 (GPIO18); also elsewhere on the board
SPI_MOSI: A1.J3.6 (GPIO16); also elsewhere on the board
SPI_SCK: A1.J3.3 (GPIO36); also elsewhere on the board
SRAM_CS: A1.J4.4 (GPIO34); also elsewhere on the board

Notes on the sheet:
USB ONLY: use module USB-C; no second carrier USB supply and no external 3V3 input.
Onboard ME6211C33; current/thermal budget and recessed USB plug fit NOT qualified.
J2/J5/J4/J3 pin names match WEMOS V1.0.0 schematic. Antenna / height review pending.
VBUS and MCU_3V3 are module outputs. EPD 3V3_OUT must NEVER join MCU_3V3.

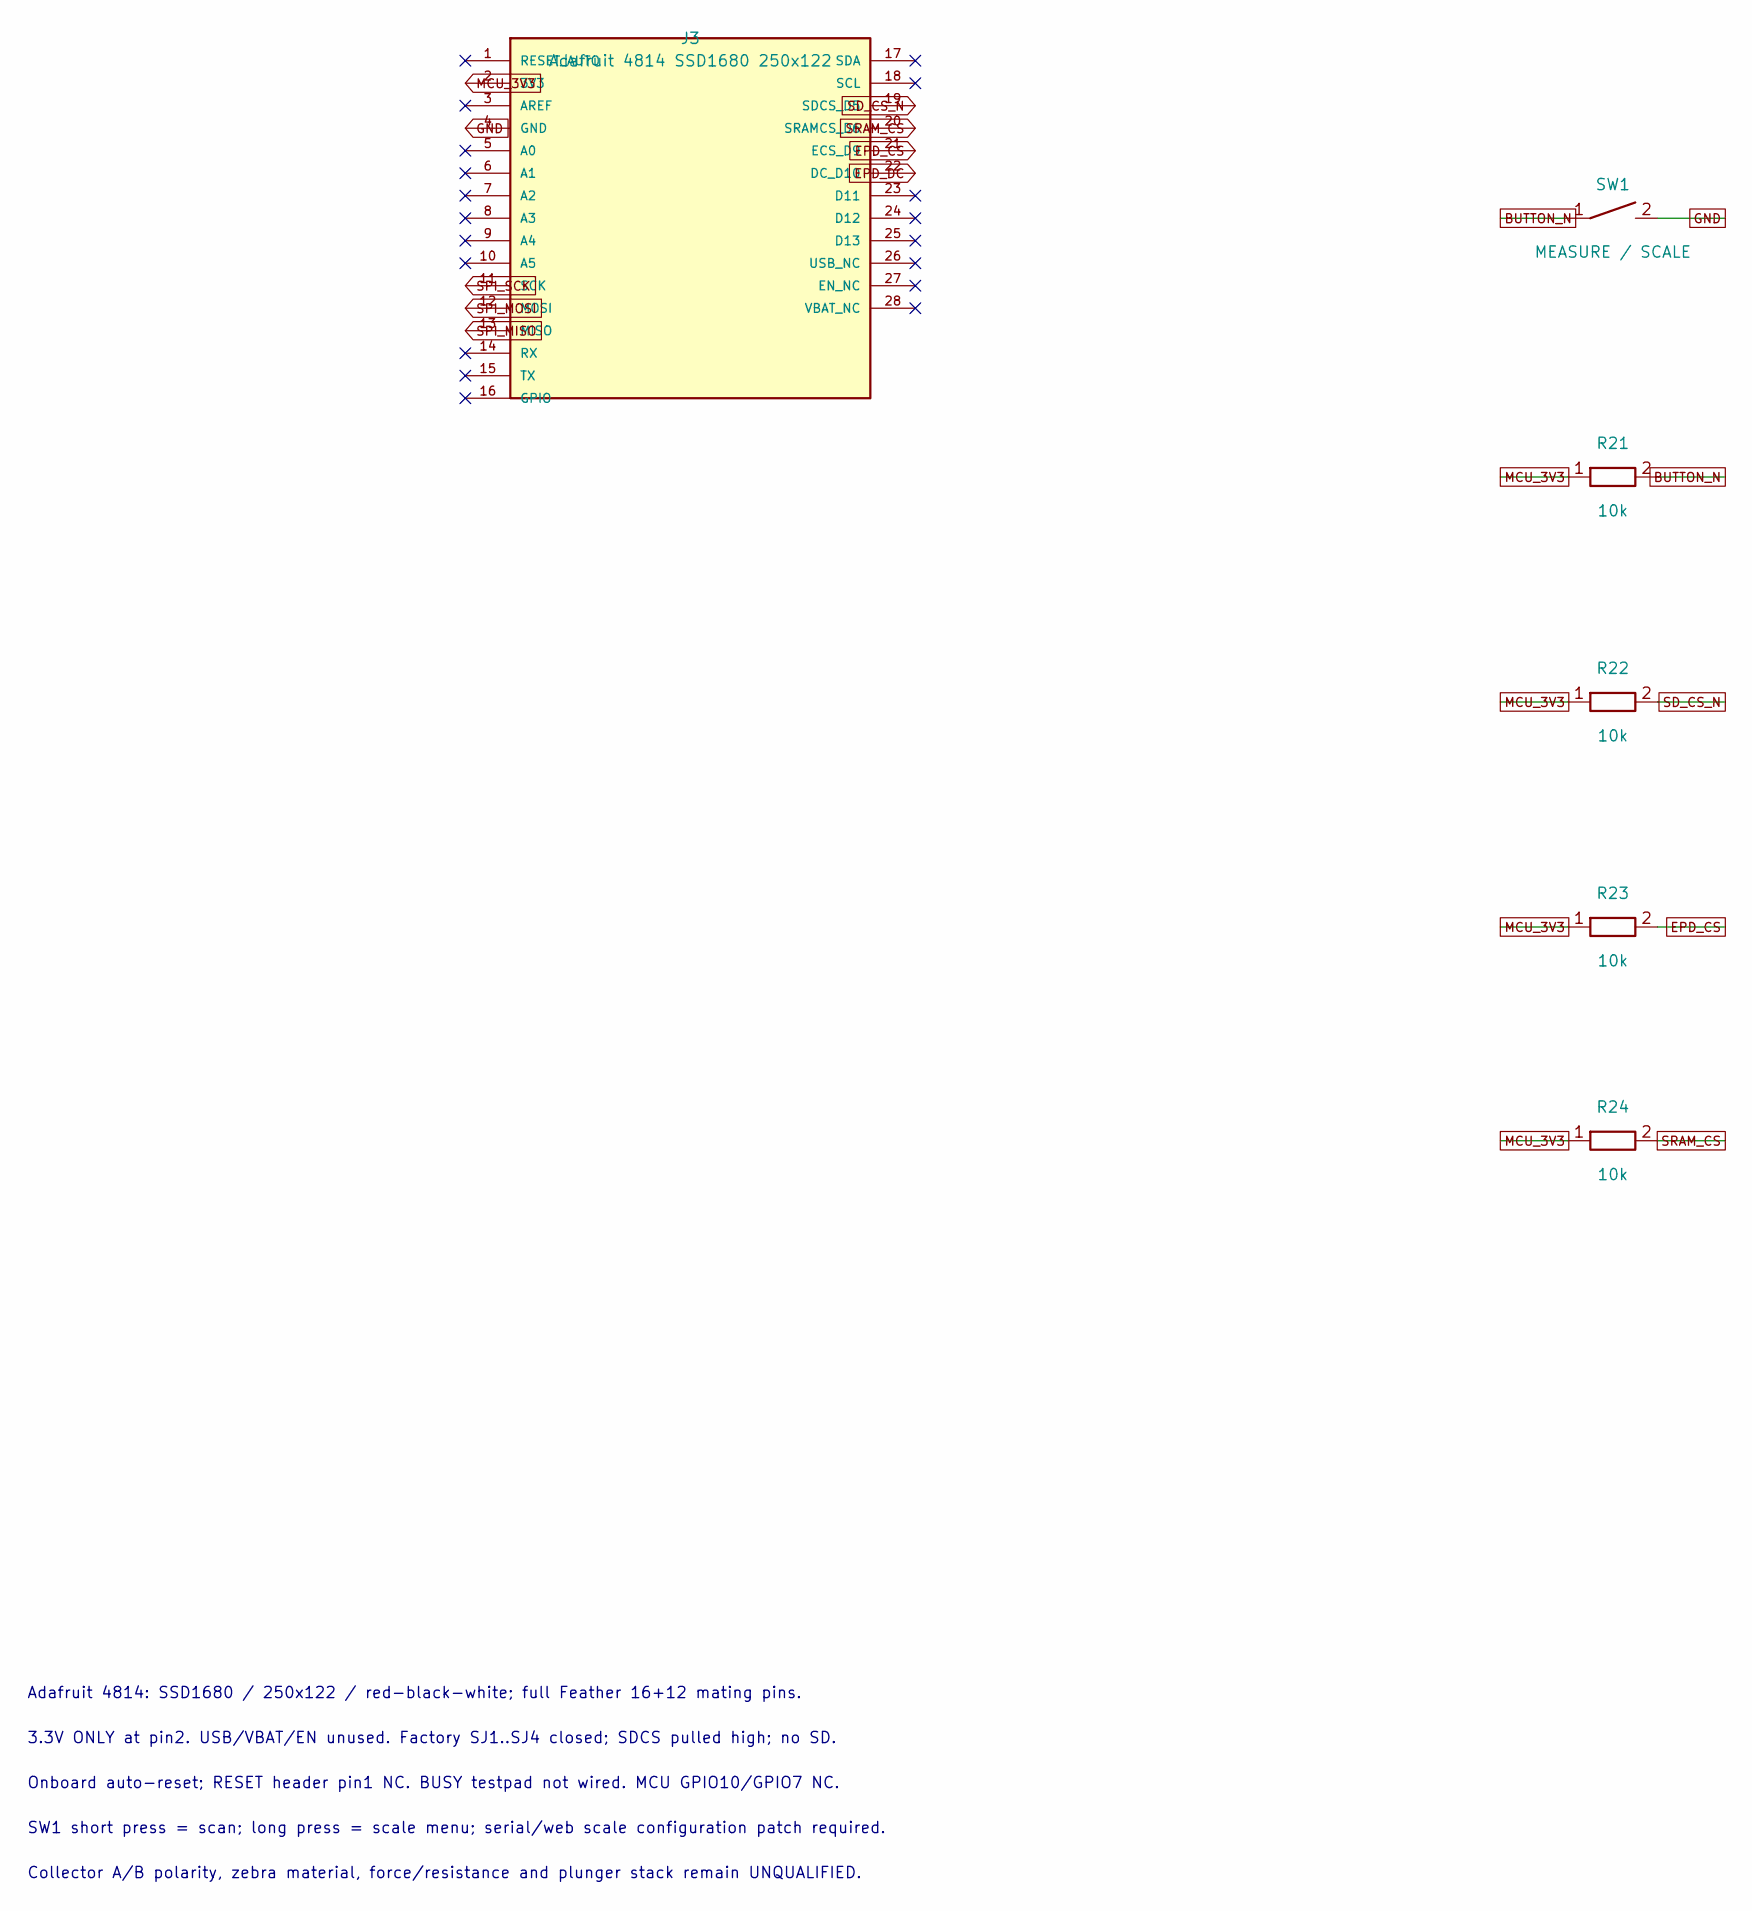
[picture p31: schematic DisplayUI.kicad_sch, Marc USB - DisplayUI - DRAFT NOT FOR FAB]

Parts:
J3: Adafruit 4814 SSD1680 250x122; Adafruit_4814_FeatherWing_Mating; MPN 4814
R21, R22, R23, R24: 10k; R_0603_1608Metric
SW1: MEASURE / SCALE; SW_SPST_TL3342; MPN TL3342候選

Connections:
BUTTON_N: R21.2, SW1.1; also elsewhere on the board
EPD_CS: J3.21 (ECS_D9), R23.2; also elsewhere on the board
EPD_DC: J3.22 (DC_D10); also elsewhere on the board
GND: J3.4 (GND), SW1.2; also elsewhere on the board
MCU_3V3: J3.2 (3V3), R21.1, R22.1, R23.1, R24.1; also elsewhere on the board
SD_CS_N: J3.19 (SDCS_D5), R22.2
SPI_MISO: J3.13 (MISO); also elsewhere on the board
SPI_MOSI: J3.12 (MOSI); also elsewhere on the board
SPI_SCK: J3.11 (SCK); also elsewhere on the board
SRAM_CS: J3.20 (SRAMCS_D6), R24.2; also elsewhere on the board

Notes on the sheet:
Adafruit 4814: SSD1680 / 250x122 / red-black-white; full Feather 16+12 mating pins.
3.3V ONLY at pin2. USB/VBAT/EN unused. Factory SJ1..SJ4 closed; SDCS pulled high; no SD.
Collector A/B polarity, zebra material, force/resistance and plunger stack remain UNQUALIFIED.
Onboard auto-reset; RESET header pin1 NC. BUSY testpad not wired. MCU GPIO10/GPIO7 NC.
SW1 short press = scan; long press = scale menu; serial/web scale configuration patch required.

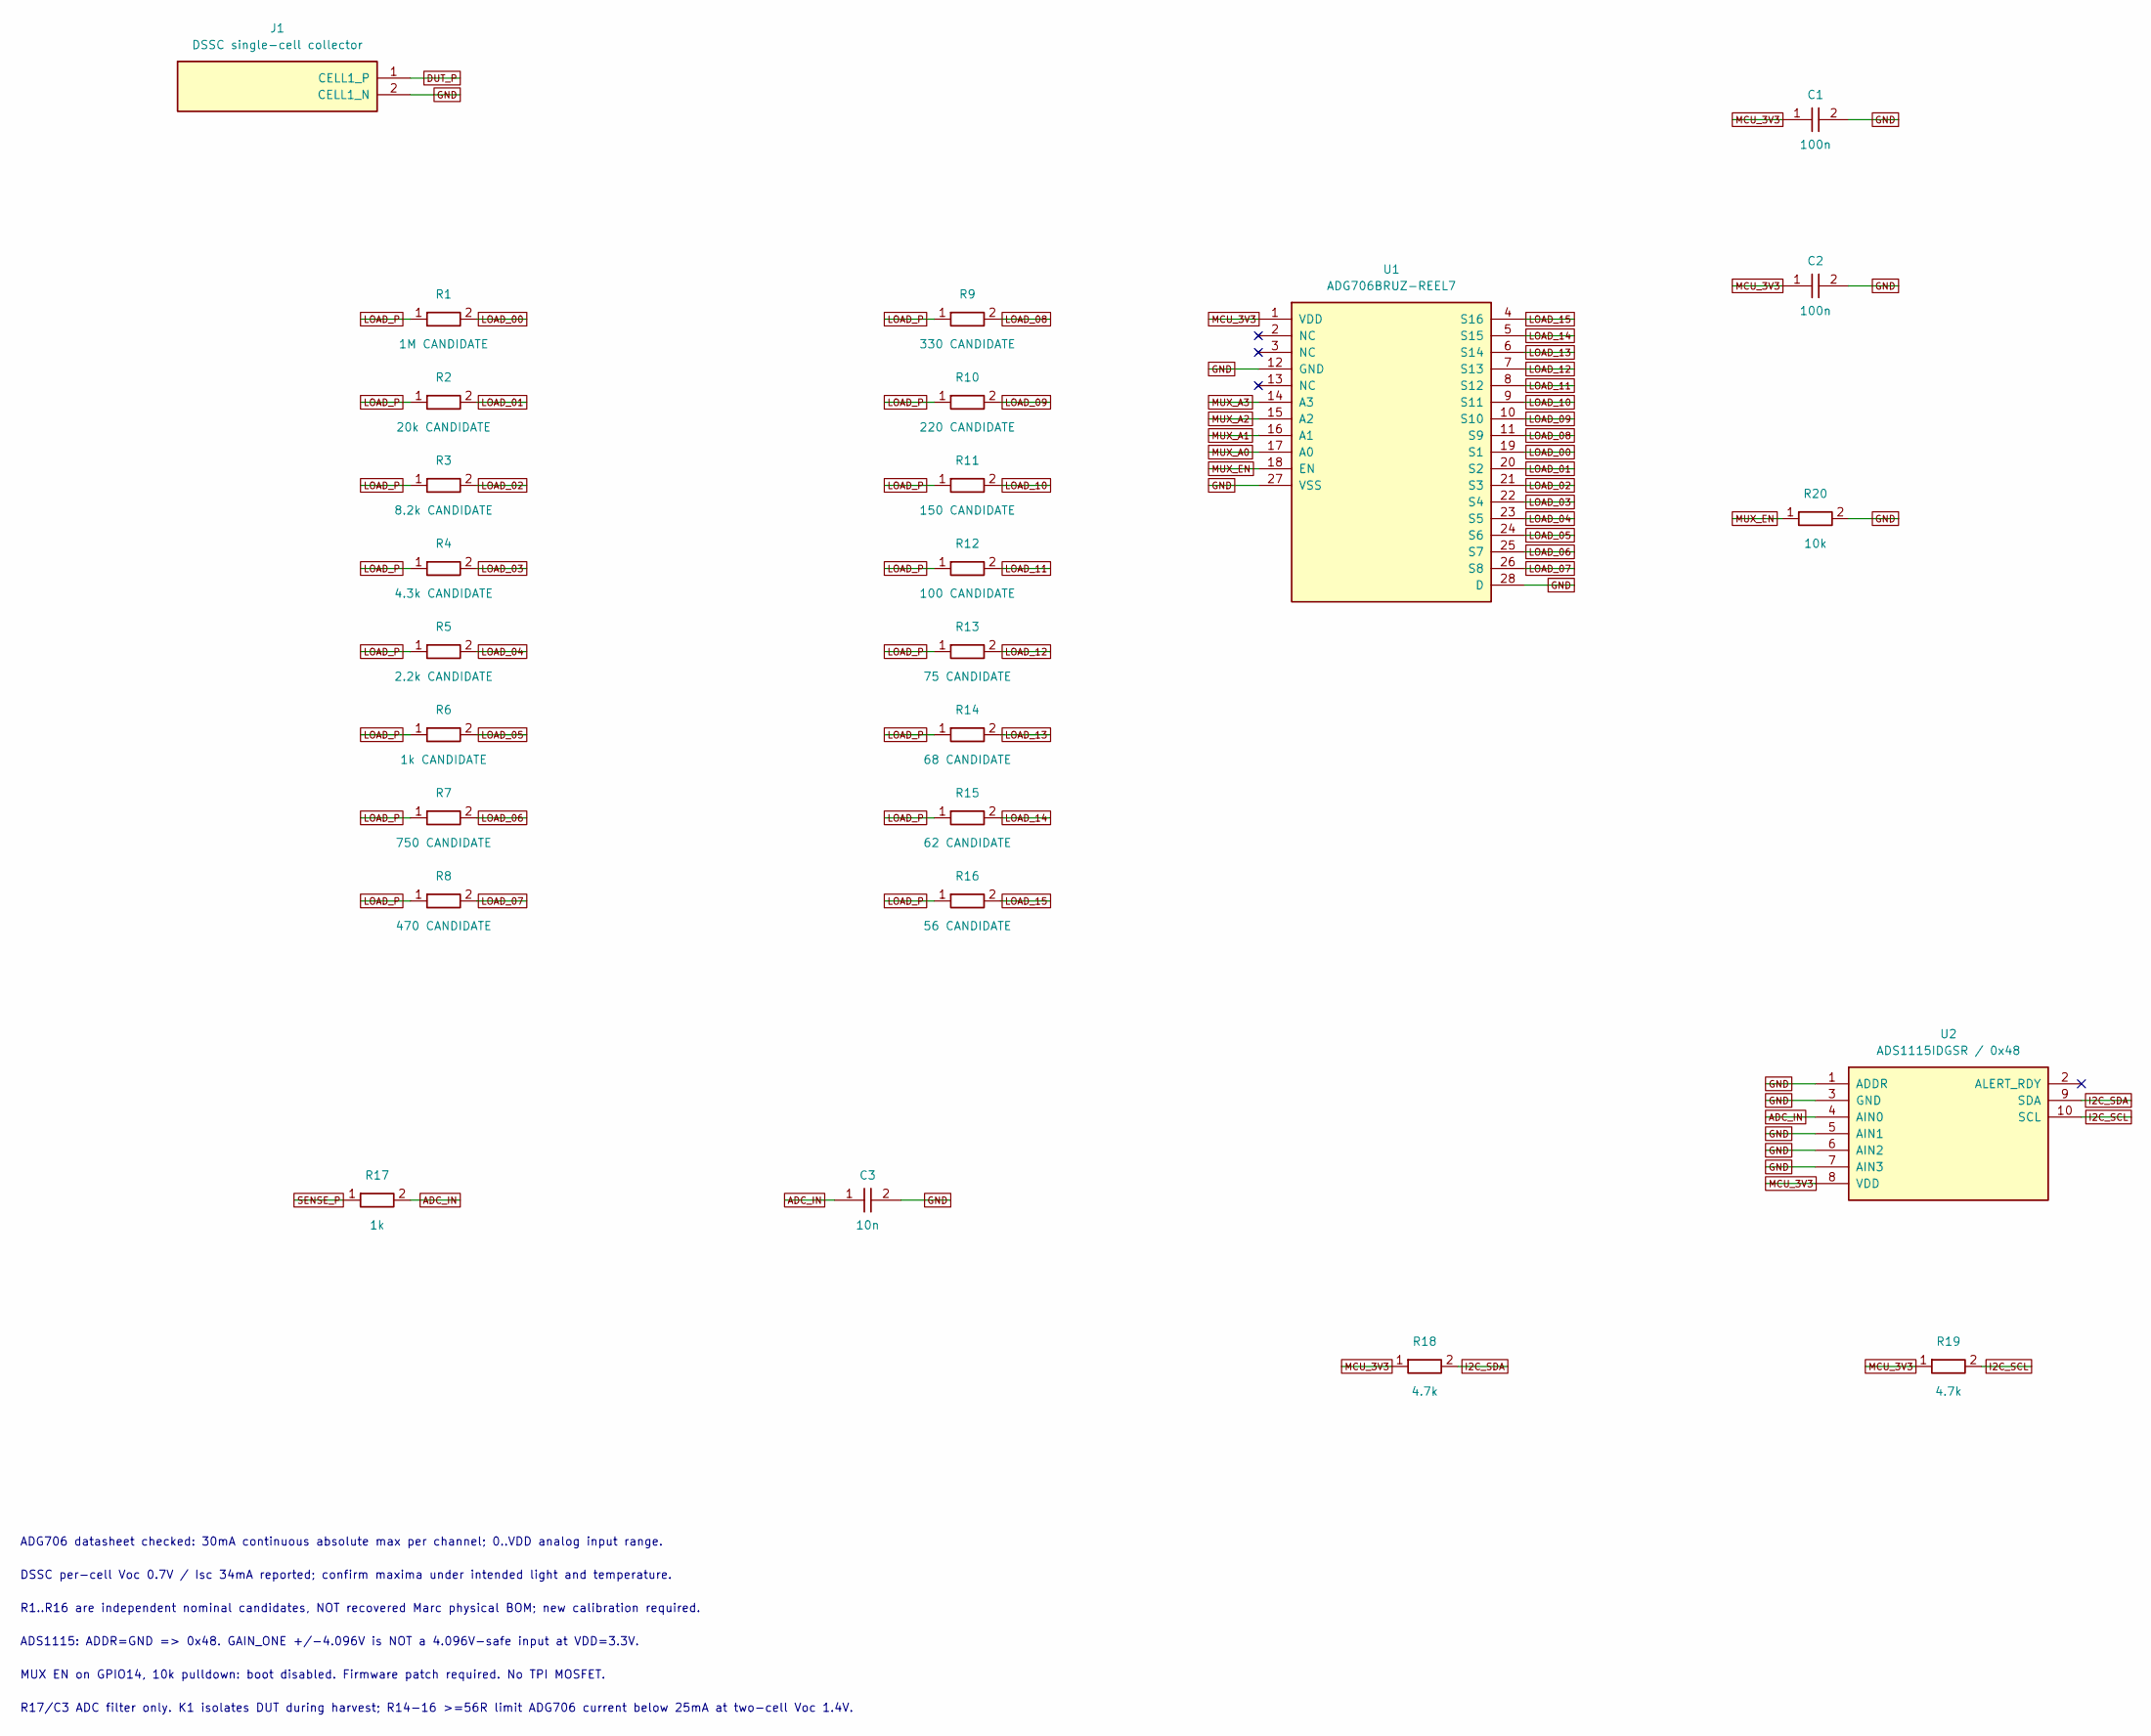
[picture p32: schematic Measurement.kicad_sch, Marc USB - Measurement - DRAFT NOT FOR FAB]

Parts:
C1, C2: 100n; C_0603_1608Metric
C3: 10n; C_0603_1608Metric
J1: DSSC single-cell collector; DSSC_Collector_58mm
R1: 1M CANDIDATE; R_1206_3216Metric; MPN RC1206FR-071ML
R2: 20k CANDIDATE; R_1206_3216Metric; MPN RC1206FR-0720KL
R3: 8.2k CANDIDATE; R_1206_3216Metric; MPN RC1206FR-078K2L
R4: 4.3k CANDIDATE; R_1206_3216Metric; MPN RC1206FR-074K3L
R5: 2.2k CANDIDATE; R_1206_3216Metric; MPN RC1206FR-072K2L
R6: 1k CANDIDATE; R_1206_3216Metric; MPN RC1206FR-071KL
R7: 750 CANDIDATE; R_1206_3216Metric; MPN RC1206FR-07750RL
R8: 470 CANDIDATE; R_1206_3216Metric; MPN RC1206FR-07470RL
R9: 330 CANDIDATE; R_1206_3216Metric; MPN RC1206FR-07330RL
R10: 220 CANDIDATE; R_1206_3216Metric; MPN RC1206FR-07220RL
R11: 150 CANDIDATE; R_1206_3216Metric; MPN RC1206FR-07150RL
R12: 100 CANDIDATE; R_1206_3216Metric; MPN RC1206FR-07100RL
R13: 75 CANDIDATE; R_1206_3216Metric; MPN RC1206FR-0775RL
R14: 68 CANDIDATE; R_1206_3216Metric; MPN RC1206FR-0768RL
R15: 62 CANDIDATE; R_1206_3216Metric; MPN RC1206FR-0762RL
R16: 56 CANDIDATE; R_1206_3216Metric; MPN RC1206FR-0756RL
R17: 1k; R_0603_1608Metric
R18, R19: 4.7k; R_0603_1608Metric
R20: 10k; R_0603_1608Metric
U1: ADG706BRUZ-REEL7; TSSOP-28_4.4x9.7mm_P0.65mm; MPN ADG706BRUZ-REEL7
U2: ADS1115IDGSR / 0x48; TSSOP-10_3x3mm_P0.5mm; MPN ADS1115IDGSR

Connections:
ADC_IN: C3.1, R17.2, U2.4 (AIN0)
DUT_P: J1.1 (CELL1_P); also elsewhere on the board
GND: C1.2, C2.2, C3.2, J1.2 (CELL1_N), R20.2, U1.12 (GND), U1.27 (VSS), U1.28 (D), U2.1 (ADDR), U2.3 (GND), U2.5 (AIN1), U2.6 (AIN2), U2.7 (AIN3); also elsewhere on the board
I2C_SCL: R19.2, U2.10 (SCL); also elsewhere on the board
I2C_SDA: R18.2, U2.9 (SDA); also elsewhere on the board
LOAD_00: R1.2, U1.19 (S1)
LOAD_01: R2.2, U1.20 (S2)
LOAD_02: R3.2, U1.21 (S3)
LOAD_03: R4.2, U1.22 (S4)
LOAD_04: R5.2, U1.23 (S5)
LOAD_05: R6.2, U1.24 (S6)
LOAD_06: R7.2, U1.25 (S7)
LOAD_07: R8.2, U1.26 (S8)
LOAD_08: R9.2, U1.11 (S9)
LOAD_09: R10.2, U1.10 (S10)
LOAD_10: R11.2, U1.9 (S11)
LOAD_11: R12.2, U1.8 (S12)
LOAD_12: R13.2, U1.7 (S13)
LOAD_13: R14.2, U1.6 (S14)
LOAD_14: R15.2, U1.5 (S15)
LOAD_15: R16.2, U1.4 (S16)
LOAD_P: R1.1, R2.1, R3.1, R4.1, R5.1, R6.1, R7.1, R8.1, R9.1, R10.1, R11.1, R12.1, R13.1, R14.1, R15.1, R16.1; also elsewhere on the board
MCU_3V3: C1.1, C2.1, R18.1, R19.1, U1.1 (VDD), U2.8 (VDD); also elsewhere on the board
MUX_A0: U1.17 (A0); also elsewhere on the board
MUX_A1: U1.16 (A1); also elsewhere on the board
MUX_A2: U1.15 (A2); also elsewhere on the board
MUX_A3: U1.14 (A3); also elsewhere on the board
MUX_EN: R20.1, U1.18 (EN); also elsewhere on the board
SENSE_P: R17.1; also elsewhere on the board

Notes on the sheet:
ADG706 datasheet checked: 30mA continuous absolute max per channel; 0..VDD analog input range.
DSSC per-cell Voc 0.7V / Isc 34mA reported; confirm maxima under intended light and temperature.
R17/C3 ADC filter only. K1 isolates DUT during harvest; R14-16 >=56R limit ADG706 current below 25mA at two-cell Voc 1.4V.
ADS1115: ADDR=GND => 0x48. GAIN_ONE +/-4.096V is NOT a 4.096V-safe input at VDD=3.3V.
MUX EN on GPIO14, 10k pulldown: boot disabled. Firmware patch required. No TPI MOSFET.
R1..R16 are independent nominal candidates, NOT recovered Marc physical BOM; new calibration required.
