weiweiweiopen/Solar-Oracle-Walkman-1.0/hardware/charge-adg706/KiCad/Marc_USB.kicad_pcb

## KiCad design hardware/charge-adg706/KiCad/Marc_USB.kicad_pcb (continued)

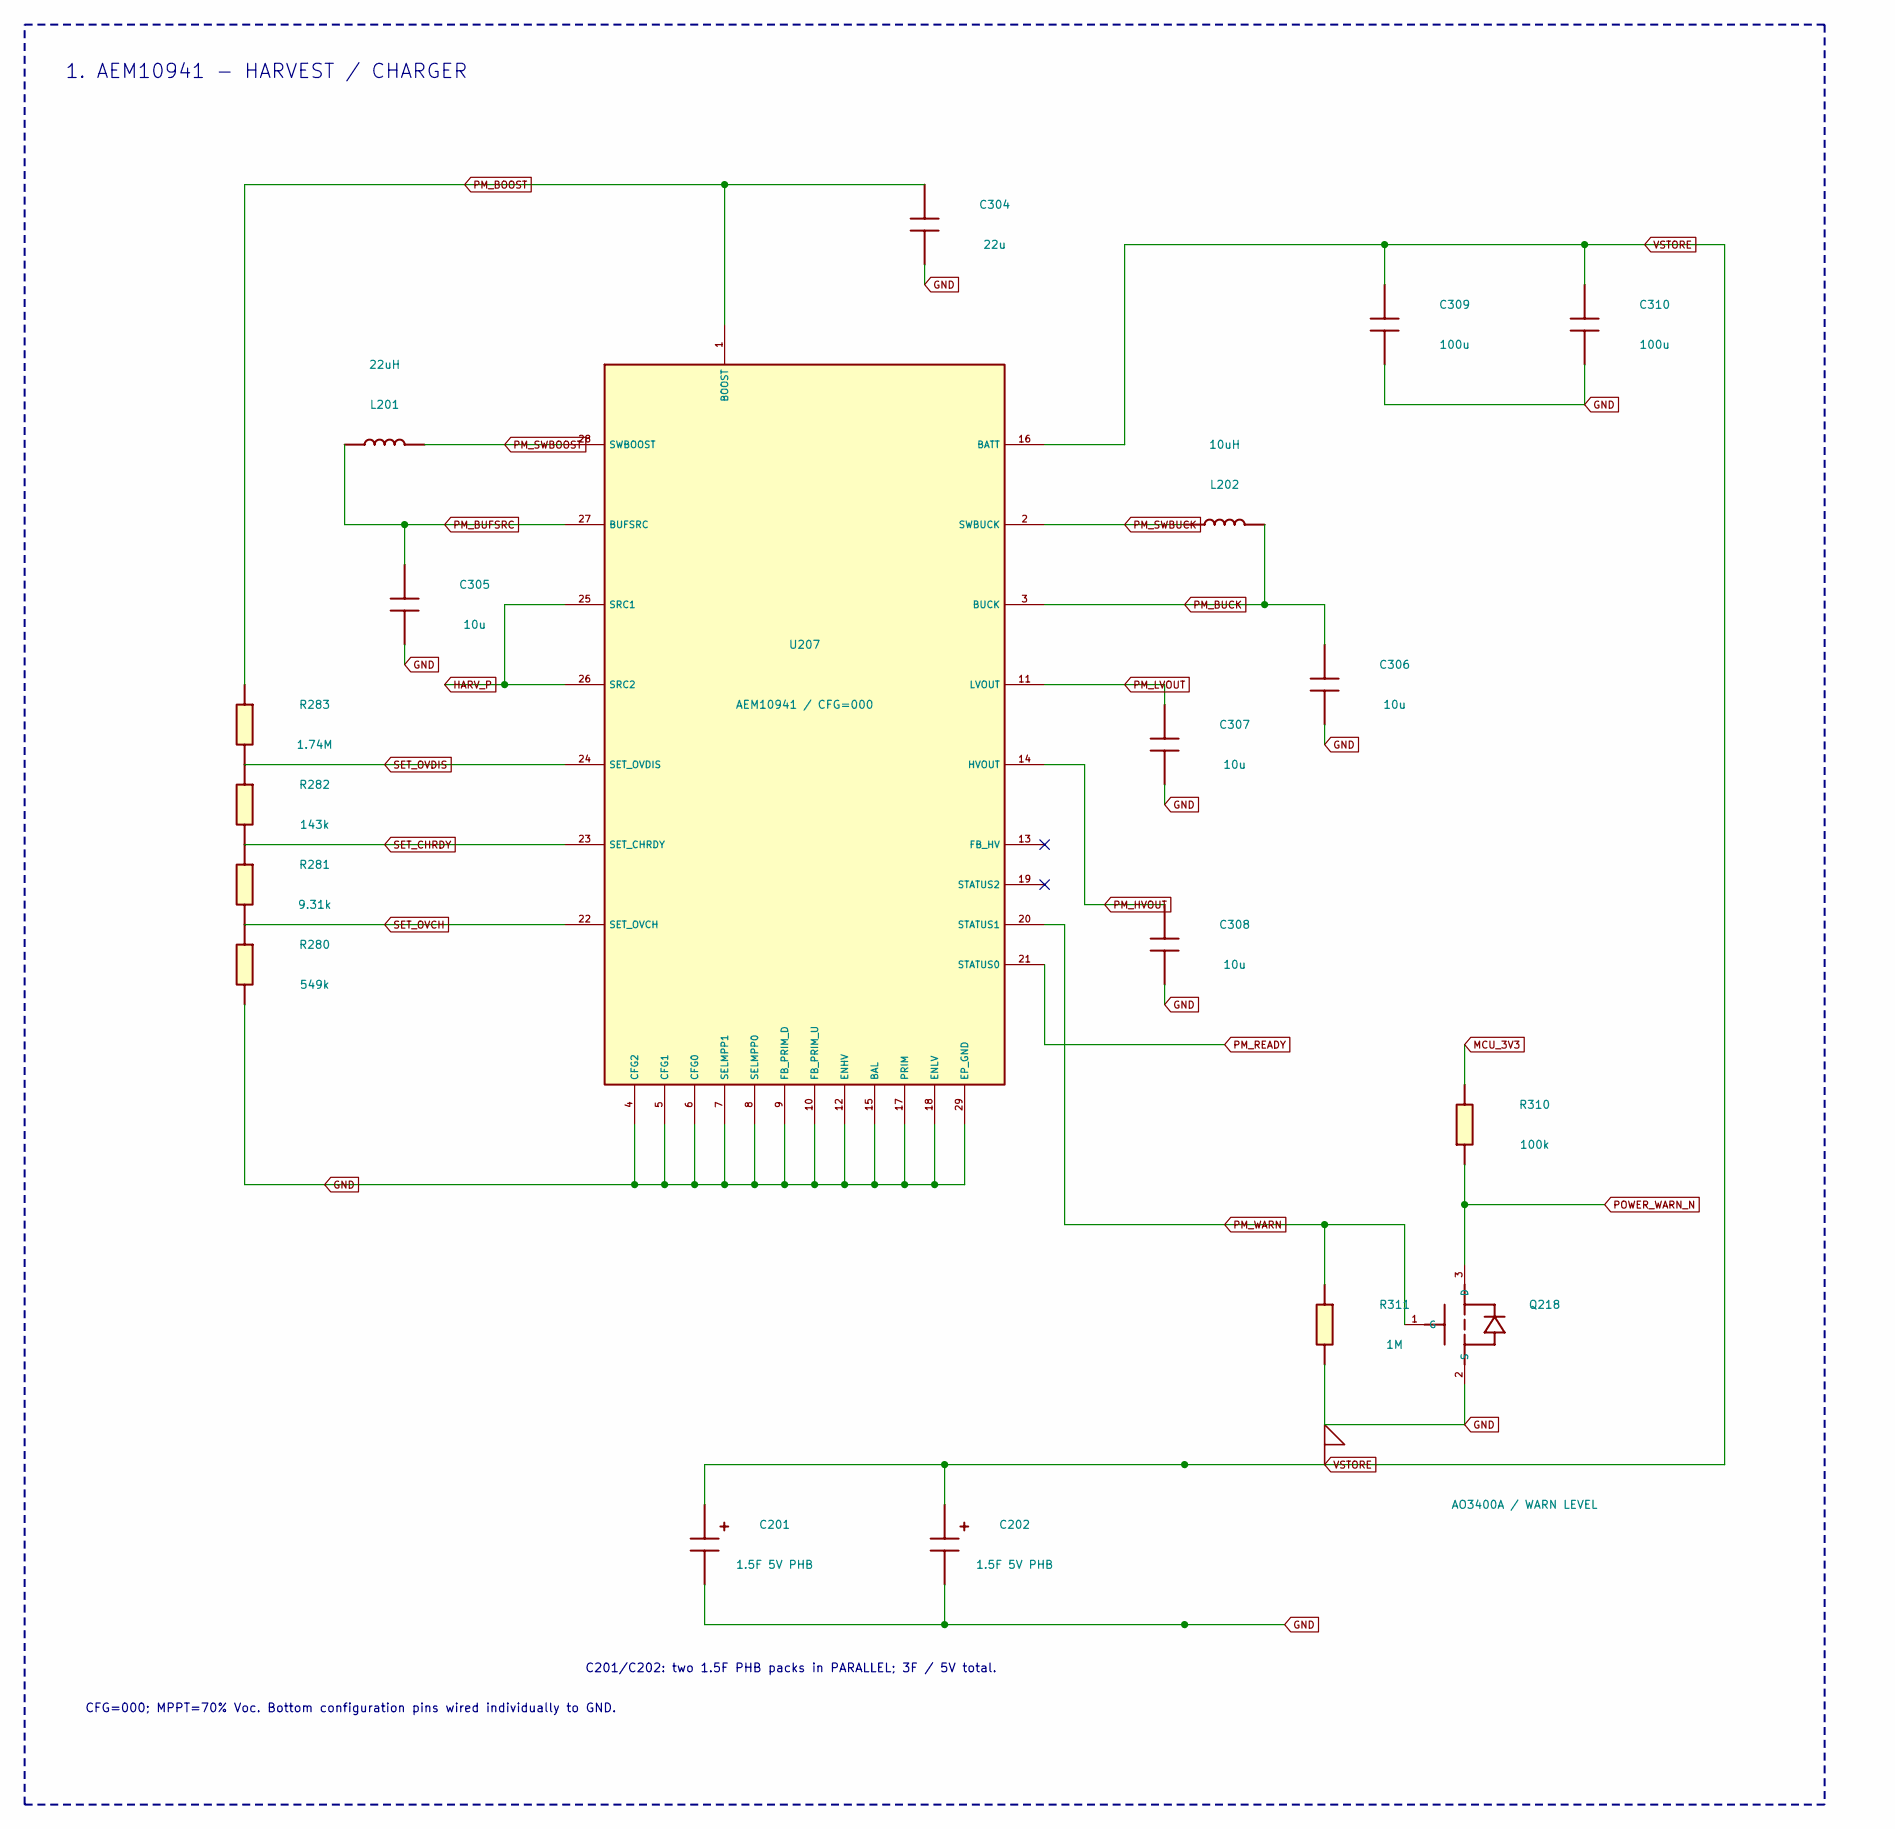
[picture p33: schematic HarvestPower.kicad_sch, POWER: AEM harvest + TPS61023 5V, part in row 1, column 1]

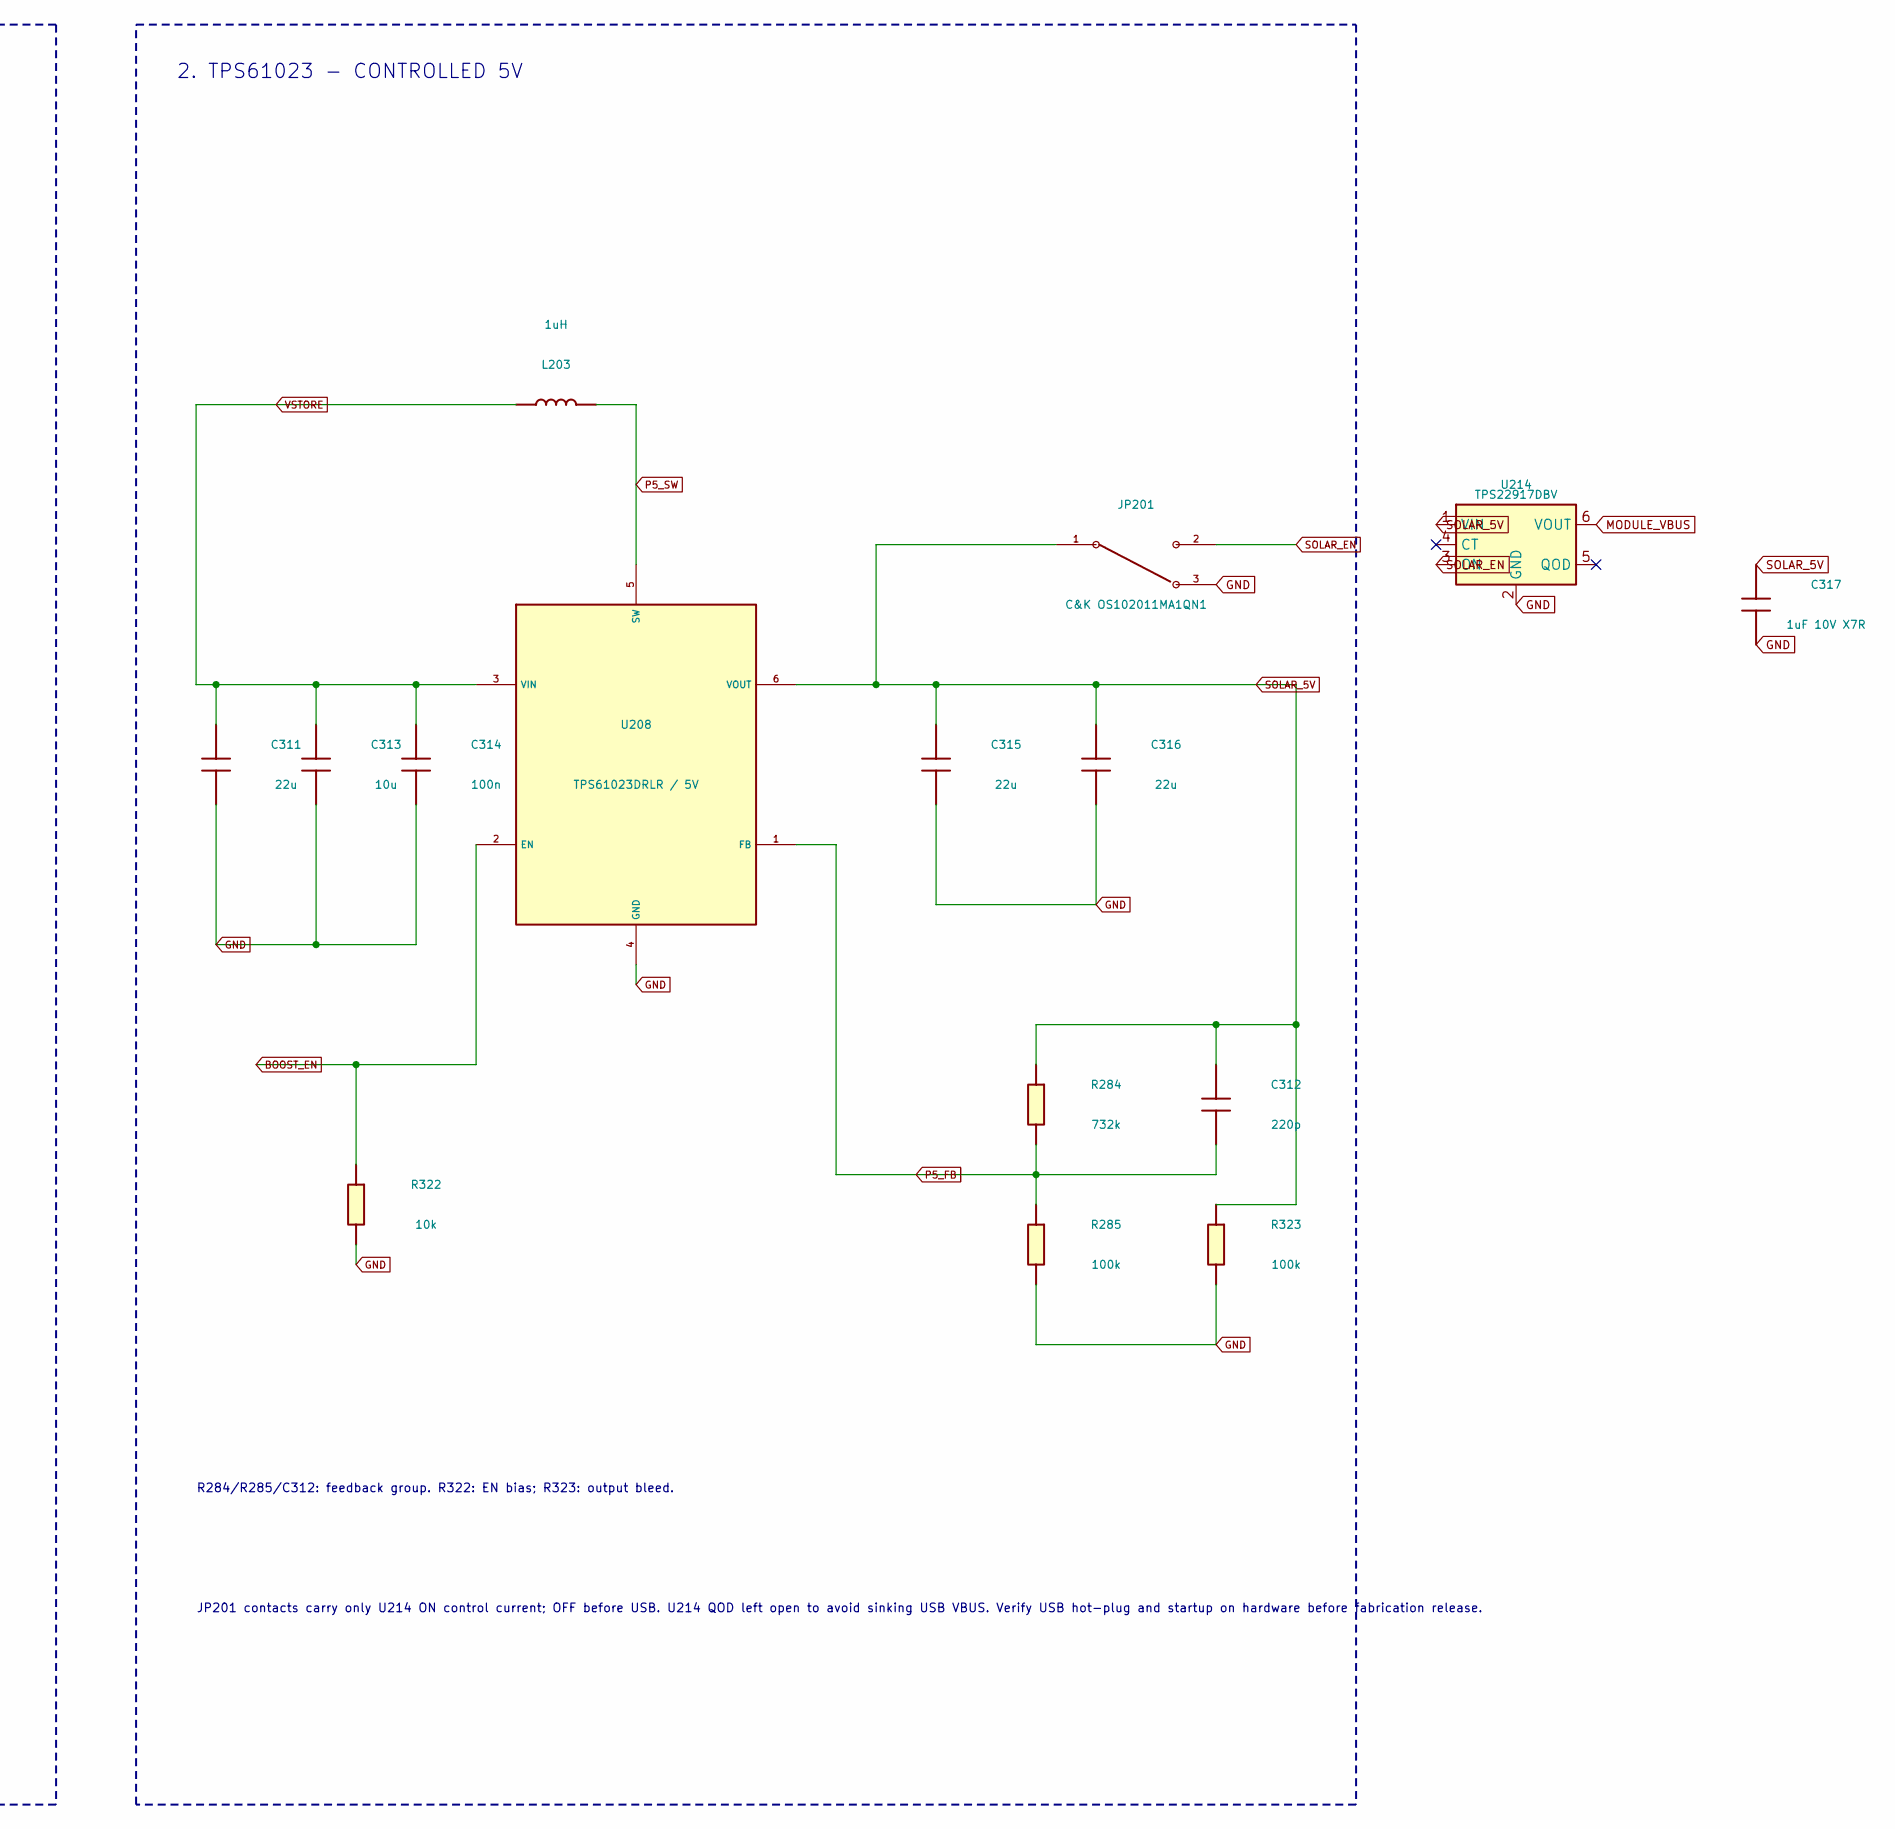
[picture p34: schematic HarvestPower.kicad_sch, POWER: AEM harvest + TPS61023 5V, part in row 1, column 2]

Parts:
C201, C202: 1.5F 5V PHB; PHB_5R0V155_R_LaidDown_Provisional; MPN PHB-5R0V155-R
C304, C311, C315, C316: 22u; C_1210_3225Metric; MPN GRM32ER61A226KE20L
C305, C306, C307, C308, C313: 10u; C_0805_2012Metric; MPN GRM21BR61C106KE15L
C309, C310: 100u; C_1210_3225Metric; MPN GRM32ER60J107ME20L
C312: 220p; C_0603_1608Metric; MPN GRM1885C1H221JA01D
C314: 100n; C_0805_2012Metric; MPN GRM21BR71H104KA01L
C317: 1uF 10V X7R; C_0603_1608Metric; MPN TBD_1uF_10V_X7R_0603
JP201: C&K OS102011MA1QN1; SW_Slide_SPDT_Angled_CK_OS102011MA1Q; MPN OS102011MA1QN1
L201: 22uH; L_Coilcraft_LPS4018; MPN LPS4018-223MRC
L202: 10uH; L_TDK_MLZ1608; MPN MLZ1608N100LT000
L203: 1uH; Coilcraft_XEL4030; MPN XEL4030-102MEC
Q218: AO3400A / WARN LEVEL; SOT-23; MPN AO3400A
R280: 549k; R_1206_3216Metric; MPN TNPW1206549KBEEA
R281: 9.31k; R_1206_3216Metric; MPN TNPW12069K31BEEA
R282: 143k; R_1206_3216Metric; MPN TNPW1206143KBEEA
R283: 1.74M; R_1206_3216Metric; MPN TNPW12061M74BEEA
R284: 732k; R_0603_1608Metric; MPN RC0603FR-07732KL
R285, R310, R323: 100k; R_0603_1608Metric; MPN RC0603FR-07100KL
R311: 1M; R_0603_1608Metric; MPN RC0603FR-071ML
R322: 10k; R_0603_1608Metric; MPN RC0603FR-0710KL
U207: AEM10941 / CFG=000; AEM10941_QFN28_EP3.5; MPN 10AEM10941C0001
U208: TPS61023DRLR / 5V; SOT-563; MPN TPS61023DRLR
U214: TPS22917DBV; SOT-23-6; MPN TPS22917DBVR

Connections:
BOOST_EN: R322.1, U208.2 (EN); also elsewhere on the board
GND: C201.2 (-), C202.2 (-), C304.2, C305.2, C306.2, C307.2, C308.2, C309.2, C310.2, C311.2, C313.2, C314.2, C315.2, C316.2, C317.2, JP201.3 (OFF_GND), Q218.2 (S), R280.2, R285.2, R311.2, R322.2, R323.2, U207.4 (CFG2), U207.5 (CFG1), U207.6 (CFG0), U207.7 (SELMPP1), U207.8 (SELMPP0), U207.9 (FB_PRIM_D), U207.10 (FB_PRIM_U), U207.12 (ENHV), U207.15 (BAL), U207.17 (PRIM), U207.18 (ENLV), U207.29 (EP_GND), U208.4 (GND), U214.2 (GND); also elsewhere on the board
HARV_P: U207.25 (SRC1), U207.26 (SRC2); also elsewhere on the board
MCU_3V3: R310.2; also elsewhere on the board
MODULE_VBUS: U214.6 (VOUT); also elsewhere on the board
P5_FB: C312.2, R284.2, R285.1, U208.1 (FB)
P5_SW: L203.2, U208.5 (SW)
PM_BOOST: C304.1, R283.1, U207.1 (BOOST)
PM_BUCK: C306.1, L202.2, U207.3 (BUCK)
PM_BUFSRC: C305.1, L201.1, U207.27 (BUFSRC)
PM_HVOUT: C308.1, U207.14 (HVOUT)
PM_LVOUT: C307.1, U207.11 (LVOUT)
PM_READY: U207.21 (STATUS0); also elsewhere on the board
PM_SWBOOST: L201.2, U207.28 (SWBOOST)
PM_SWBUCK: L202.1, U207.2 (SWBUCK)
PM_WARN: Q218.1 (G), R311.1, U207.20 (STATUS1)
POWER_WARN_N: Q218.3 (D), R310.1; also elsewhere on the board
SET_CHRDY: R281.1, R282.2, U207.23 (SET_CHRDY)
SET_OVCH: R280.1, R281.2, U207.22 (SET_OVCH)
SET_OVDIS: R282.1, R283.2, U207.24 (SET_OVDIS)
SOLAR_5V: C312.1, C315.1, C316.1, C317.1, JP201.1 (ON_SOLAR_5V), R284.1, R323.1, U208.6 (VOUT), U214.1 (VIN)
SOLAR_EN: JP201.2 (COM_SOLAR_EN), U214.3 (ON)
VSTORE: C201.1 (+), C202.1 (+), C309.1, C310.1, C311.1, C313.1, C314.1, L203.1, U207.16 (BATT), U208.3 (VIN); also elsewhere on the board

Notes on the sheet:
JP201 contacts carry only U214 ON control current; OFF before USB. U214 QOD left open to avoid sinking USB VBUS. Verify USB hot-plug and startup on hardware before fabrication release.
2. TPS61023 - CONTROLLED 5V
1. AEM10941 - HARVEST / CHARGER
CFG=000; MPPT=70% Voc. Bottom configuration pins wired individually to GND.
R284/R285/C312: feedback group. R322: EN bias; R323: output bleed.
C201/C202: two 1.5F PHB packs in PARALLEL; 3F / 5V total.

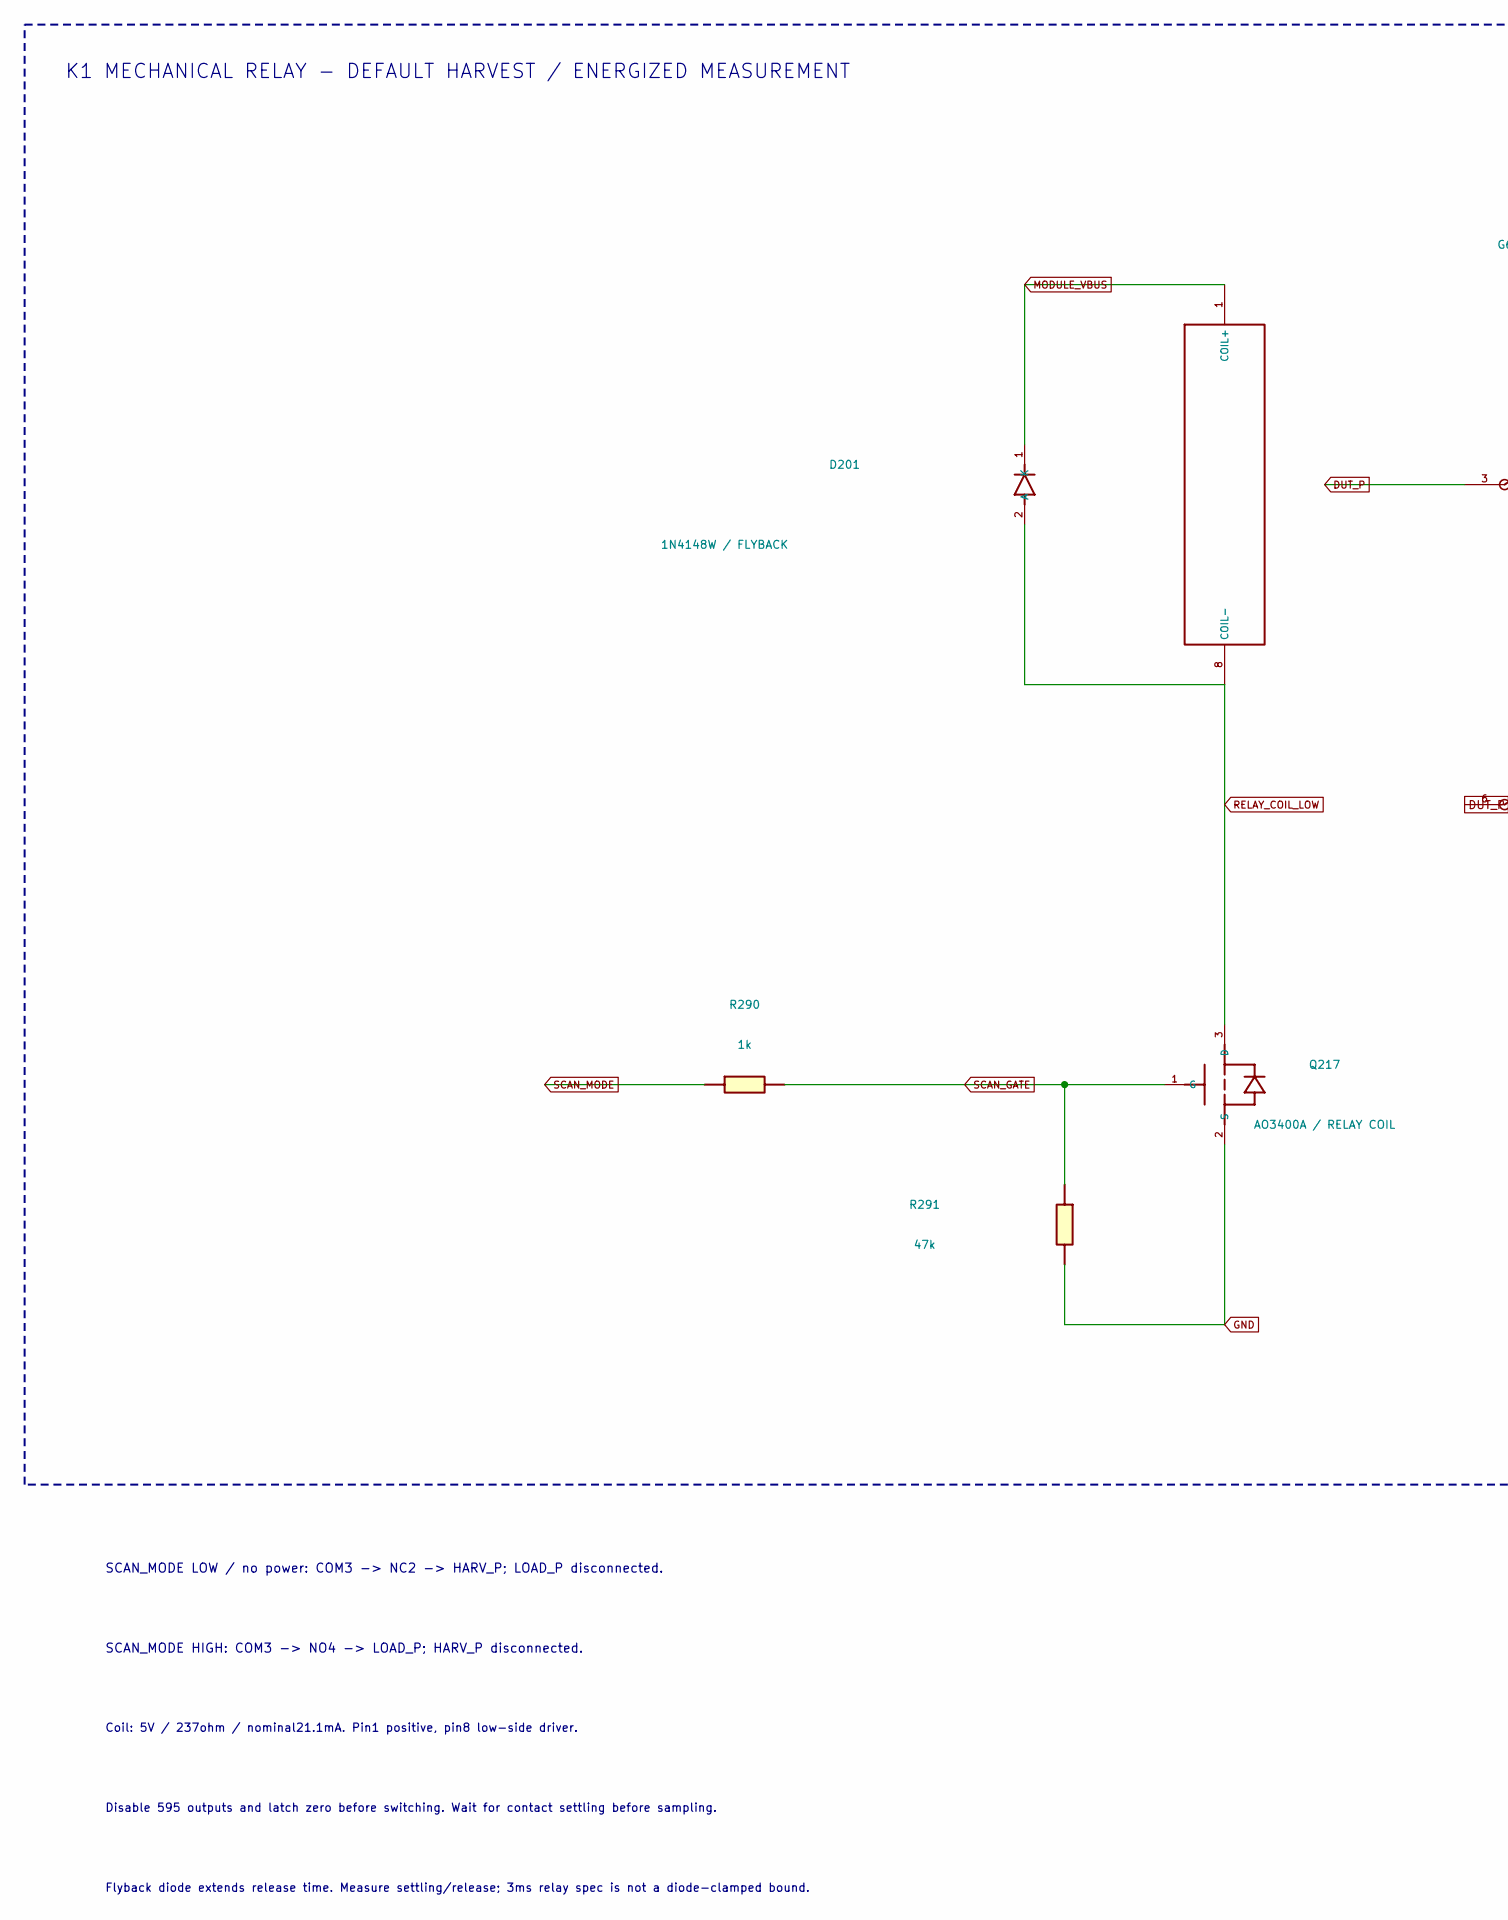
[picture p35: schematic HarvestSwitch.kicad_sch, SWITCHING: K1 relay / coil driver / flyback, part in row 1, column 1]

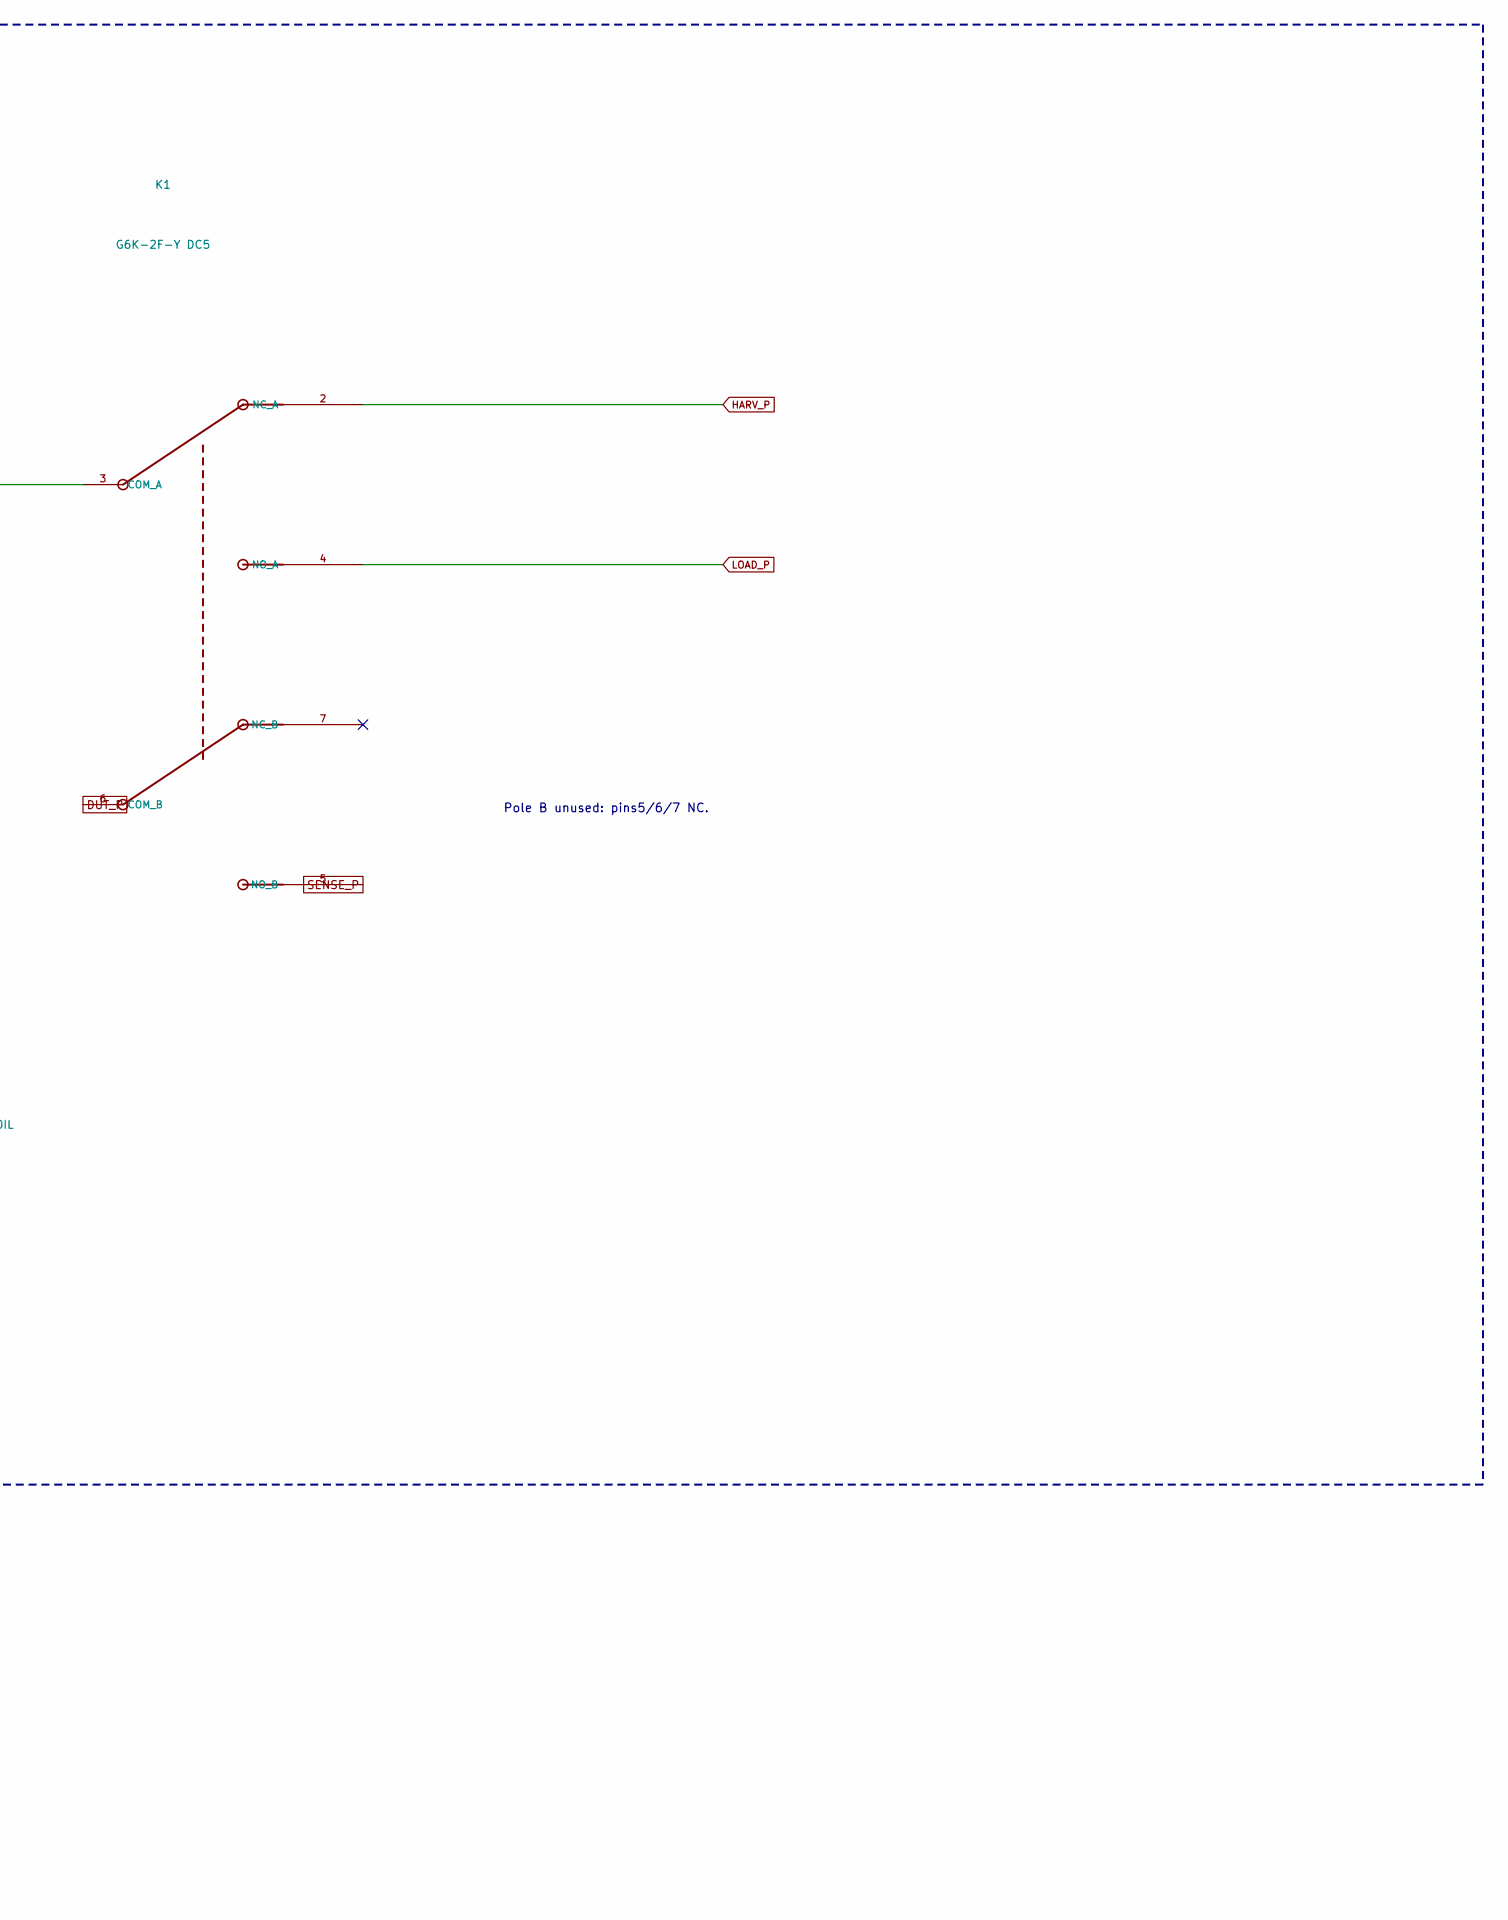
[picture p36: schematic HarvestSwitch.kicad_sch, SWITCHING: K1 relay / coil driver / flyback, part in row 1, column 2]

Parts:
D201: 1N4148W / FLYBACK; D_SOD-123; MPN 1N4148W-7-F
K1: G6K-2F-Y DC5; G6K_2F_Y; MPN G6K-2F-Y-TR DC5
Q217: AO3400A / RELAY COIL; SOT-23; MPN AO3400A
R290: 1k; R_0603_1608Metric; MPN RC0603FR-071KL
R291: 47k; R_0603_1608Metric; MPN RC0603FR-0747KL

Connections:
DUT_P: K1.3 (COM_A), K1.6 (COM_B); also elsewhere on the board
GND: Q217.2 (S), R291.2; also elsewhere on the board
HARV_P: K1.2 (NC_A); also elsewhere on the board
LOAD_P: K1.4 (NO_A); also elsewhere on the board
MODULE_VBUS: D201.1 (K), K1.1 (COIL+); also elsewhere on the board
RELAY_COIL_LOW: D201.2 (A), K1.8 (COIL-), Q217.3 (D)
SCAN_GATE: Q217.1 (G), R290.2, R291.1
SCAN_MODE: R290.1; also elsewhere on the board
SENSE_P: K1.5 (NO_B); also elsewhere on the board

Notes on the sheet:
SCAN_MODE HIGH: COM3 -> NO4 -> LOAD_P; HARV_P disconnected.
Flyback diode extends release time. Measure settling/release; 3ms relay spec is not a diode-clamped bound.
Coil: 5V / 237ohm / nominal21.1mA. Pin1 positive, pin8 low-side driver.
SCAN_MODE LOW / no power: COM3 -> NC2 -> HARV_P; LOAD_P disconnected.
K1 MECHANICAL RELAY - DEFAULT HARVEST / ENERGIZED MEASUREMENT
Disable 595 outputs and latch zero before switching. Wait for contact settling before sampling.
Pole B unused: pins5/6/7 NC.

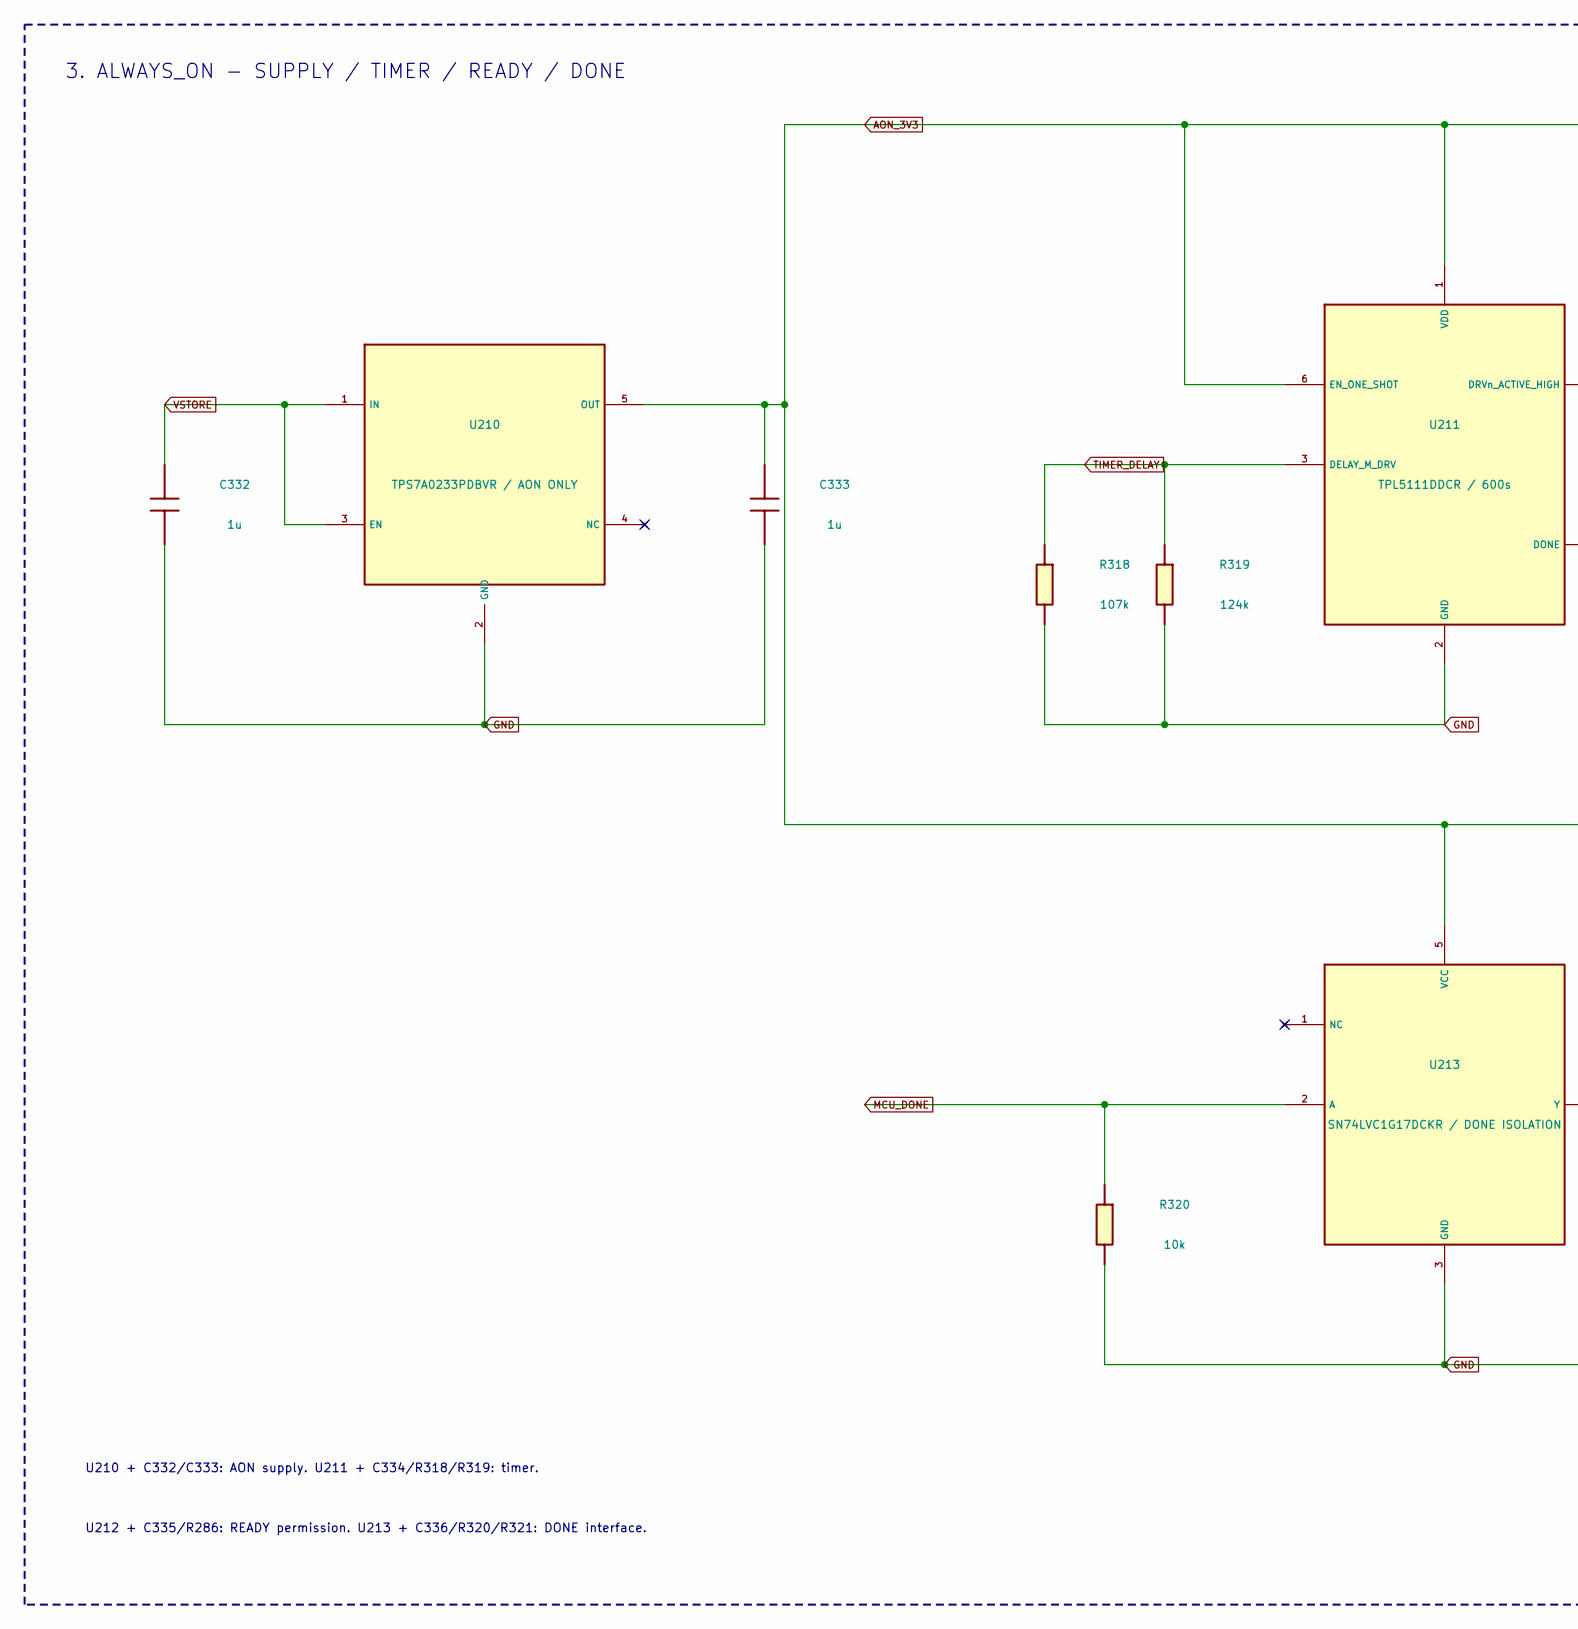
[picture p37: schematic AlwaysOn.kicad_sch, ALWAYS_ON: READY / timer / DONE, part in row 1, column 1]

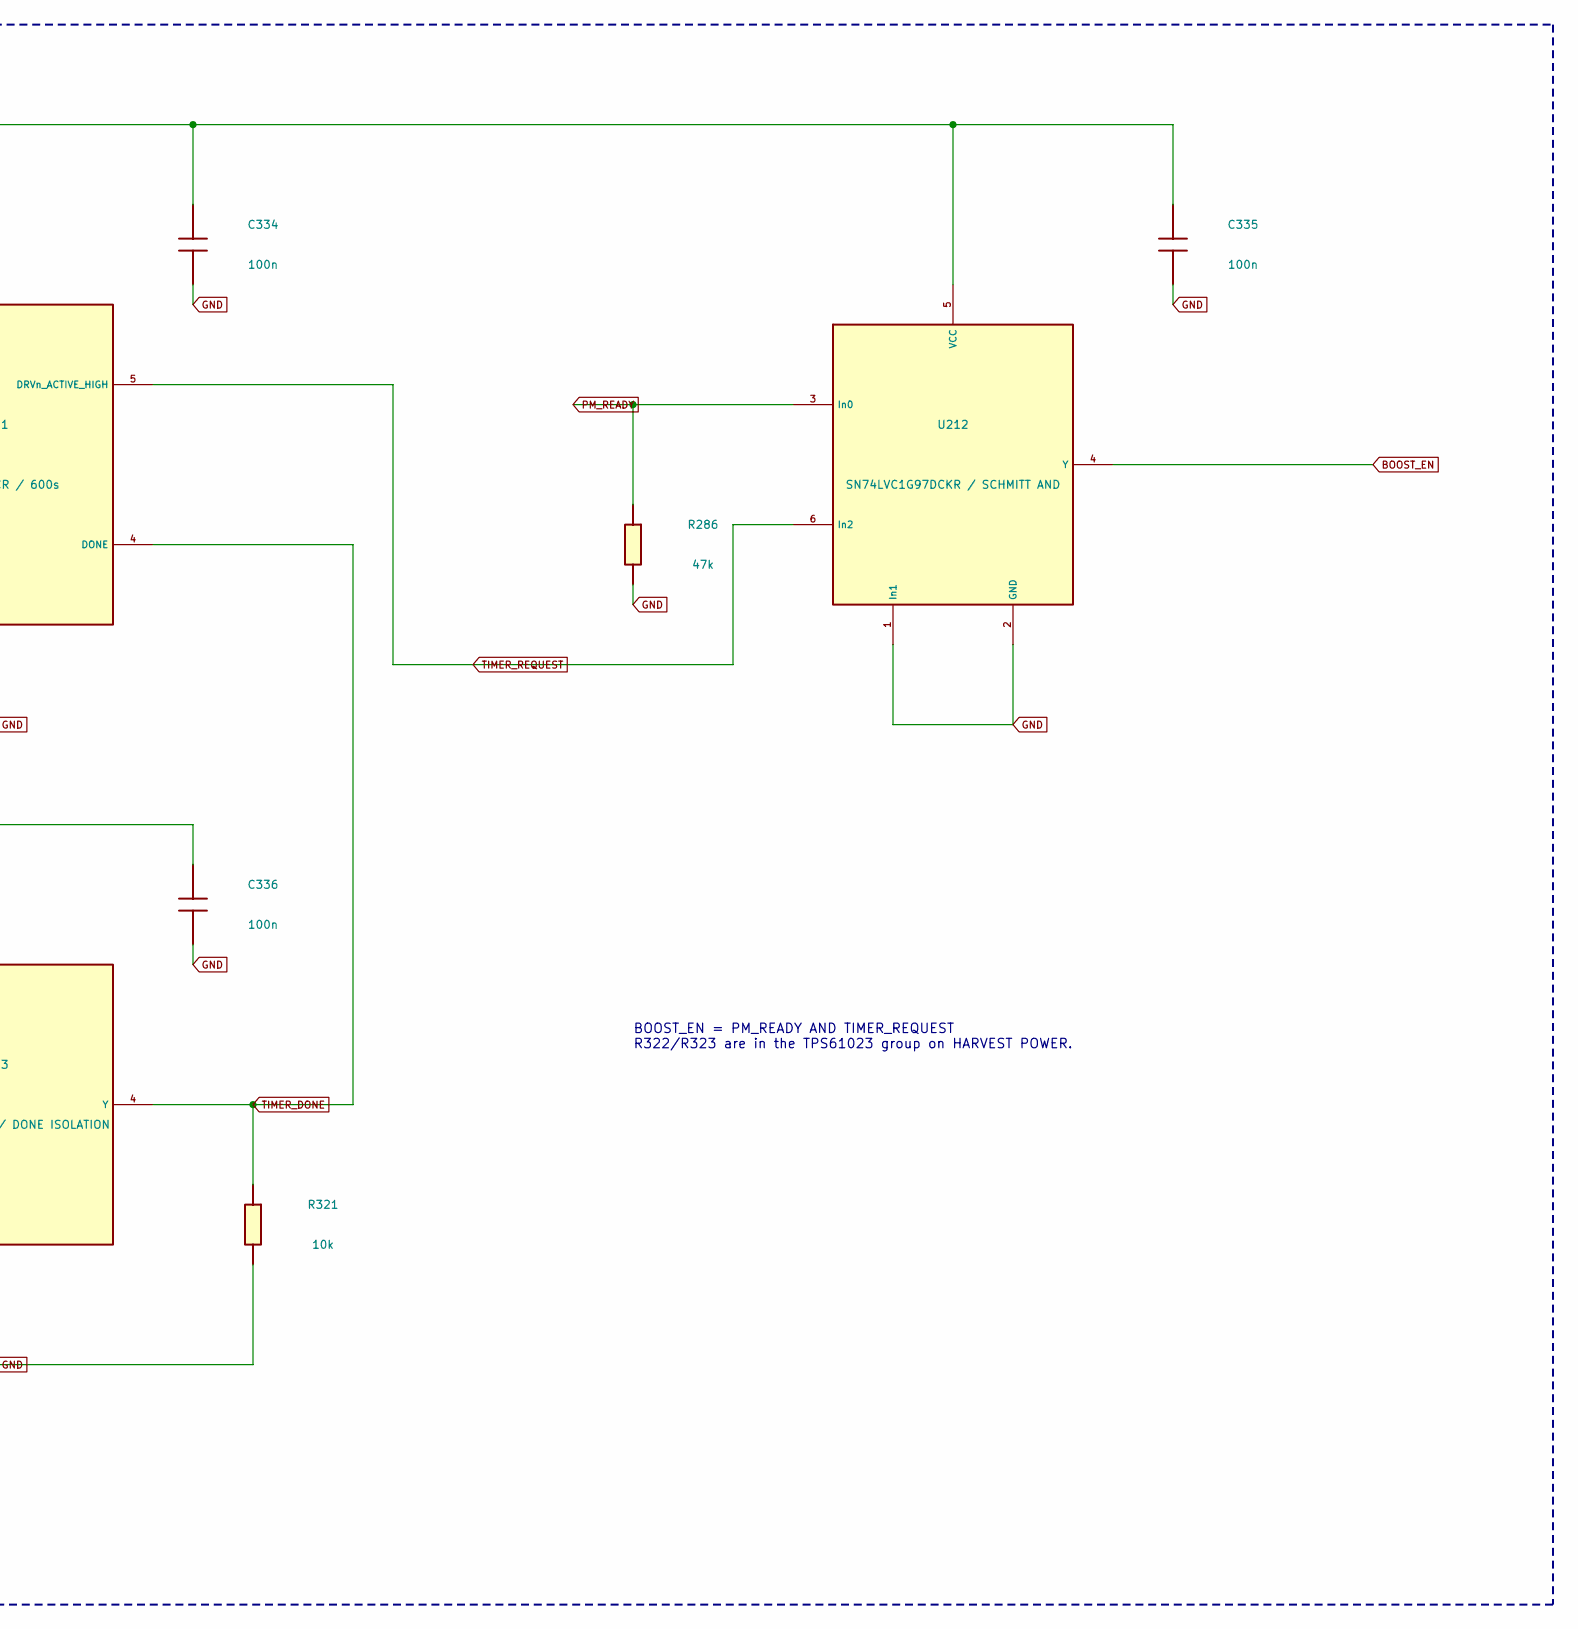
[picture p38: schematic AlwaysOn.kicad_sch, ALWAYS_ON: READY / timer / DONE, part in row 1, column 2]

Parts:
C332, C333: 1u; C_0805_2012Metric; MPN GRM21BR71C105KA01L
C334, C335, C336: 100n; C_0805_2012Metric; MPN GRM21BR71H104KA01L
R286: 47k; R_0603_1608Metric; MPN RC0603FR-0747KL
R318: 107k; R_0603_1608Metric; MPN RC0603FR-07107KL
R319: 124k; R_0603_1608Metric; MPN RC0603FR-07124KL
R320, R321: 10k; R_0603_1608Metric; MPN RC0603FR-0710KL
U210: TPS7A0233PDBVR / AON ONLY; SOT-23-5; MPN TPS7A0233PDBVR
U211: TPL5111DDCR / 600s; SOT-23-6; MPN TPL5111DDCR
U212: SN74LVC1G97DCKR / SCHMITT AND; SOT-363_SC-70-6; MPN SN74LVC1G97DCKR
U213: SN74LVC1G17DCKR / DONE ISOLATION; SOT-353_SC-70-5; MPN SN74LVC1G17DCKR

Connections:
AON_3V3: C333.1, C334.1, C335.1, C336.1, U210.5 (OUT), U211.1 (VDD), U211.6 (EN_ONE_SHOT), U212.5 (VCC), U213.5 (VCC)
BOOST_EN: U212.4 (Y); also elsewhere on the board
GND: C332.2, C333.2, C334.2, C335.2, C336.2, R286.2, R318.2, R319.2, R320.2, R321.2, U210.2 (GND), U211.2 (GND), U212.1 (In1), U212.2 (GND), U213.3 (GND); also elsewhere on the board
MCU_DONE: R320.1, U213.2 (A); also elsewhere on the board
PM_READY: R286.1, U212.3 (In0); also elsewhere on the board
TIMER_DELAY: R318.1, R319.1, U211.3 (DELAY_M_DRV)
TIMER_DONE: R321.1, U211.4 (DONE), U213.4 (Y)
TIMER_REQUEST: U211.5 (DRVn_ACTIVE_HIGH), U212.6 (In2)
VSTORE: C332.1, U210.1 (IN), U210.3 (EN); also elsewhere on the board

Notes on the sheet:
U212 + C335/R286: READY permission. U213 + C336/R320/R321: DONE interface.
U210 + C332/C333: AON supply. U211 + C334/R318/R319: timer.
3. ALWAYS_ON - SUPPLY / TIMER / READY / DONE
BOOST_EN = PM_READY AND TIMER_REQUEST R322/R323 are in the TPS61023 group on HARVEST POWER.
