weiweiweiopen/Solar-Oracle-Walkman-1.0/hardware/charge-adg706/KiCad/Marc_USB.kicad_pcb

## KiCad design hardware/charge-adg706/KiCad/Marc_USB.kicad_pcb (continued)

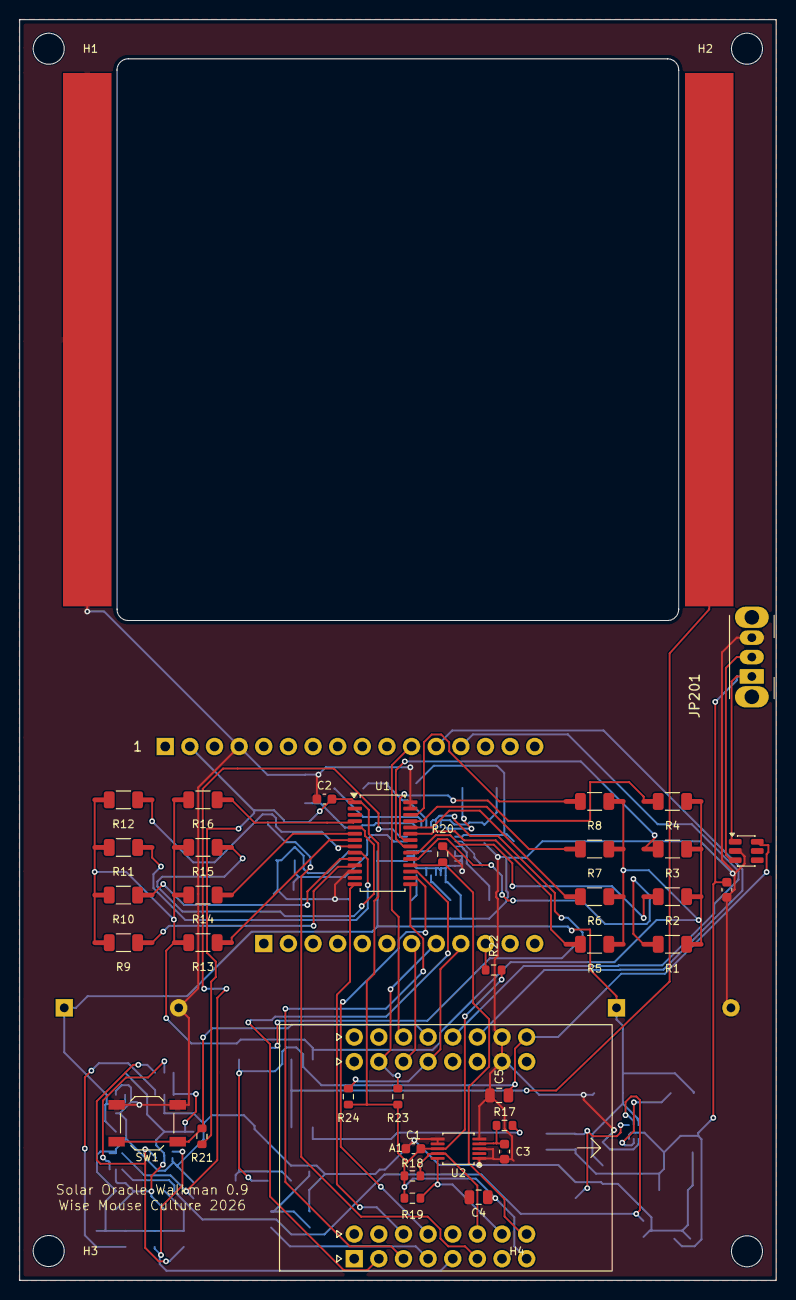
[picture p39: board Marc_USB.kicad_pcb from above]

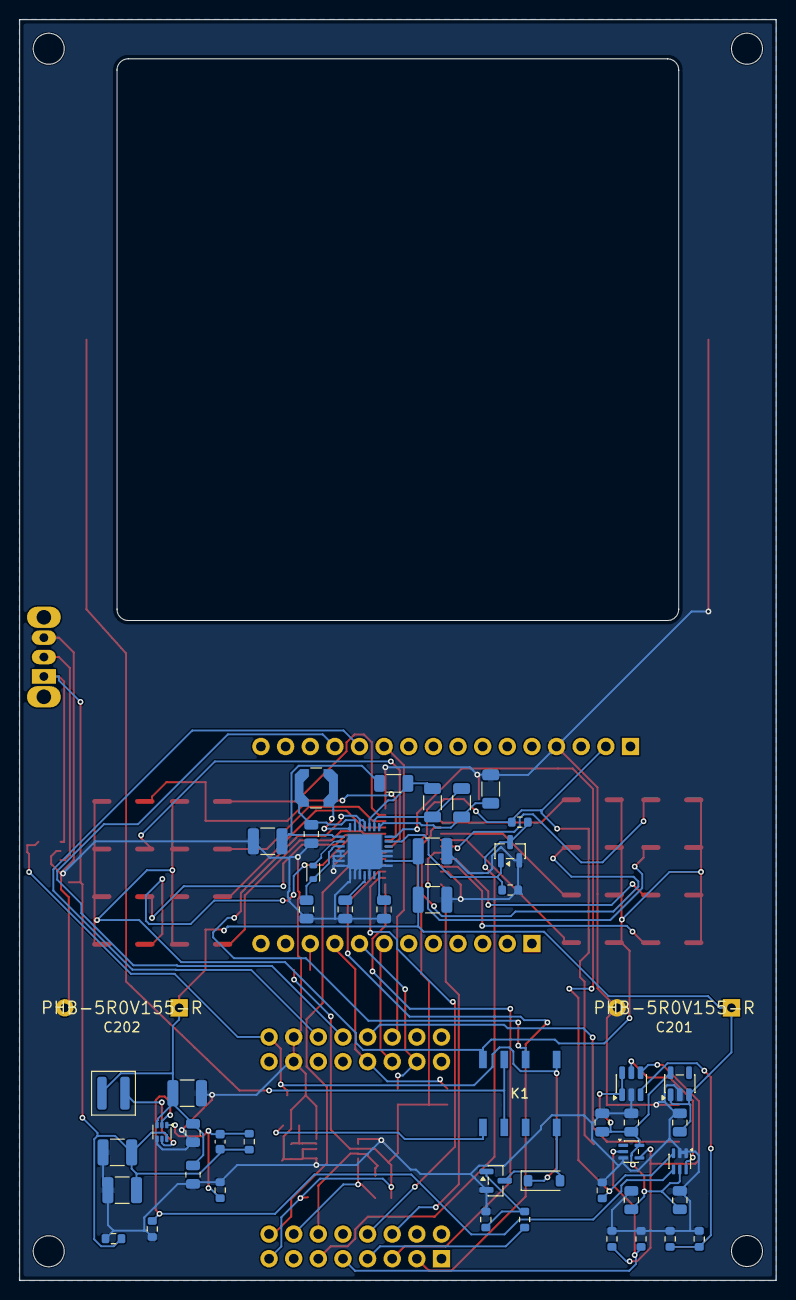
[picture p40: board Marc_USB.kicad_pcb from below]

Board: 2 copper layers, 78.0 x 130.0 mm, 92 parts (50 on the bottom side), 66 nets.

Other parts of the board:
H1, H2, H3, H4: NPTH 3.2mm; MountingHole_3.2mm_M3
