weiweiweiopen/Solar-Oracle-Walkman-1.0/hardware/solar-oracle-walkman-relay.kicad_pcb

## KiCad design hardware/solar-oracle-walkman-relay.kicad_pcb (2026-09-20)

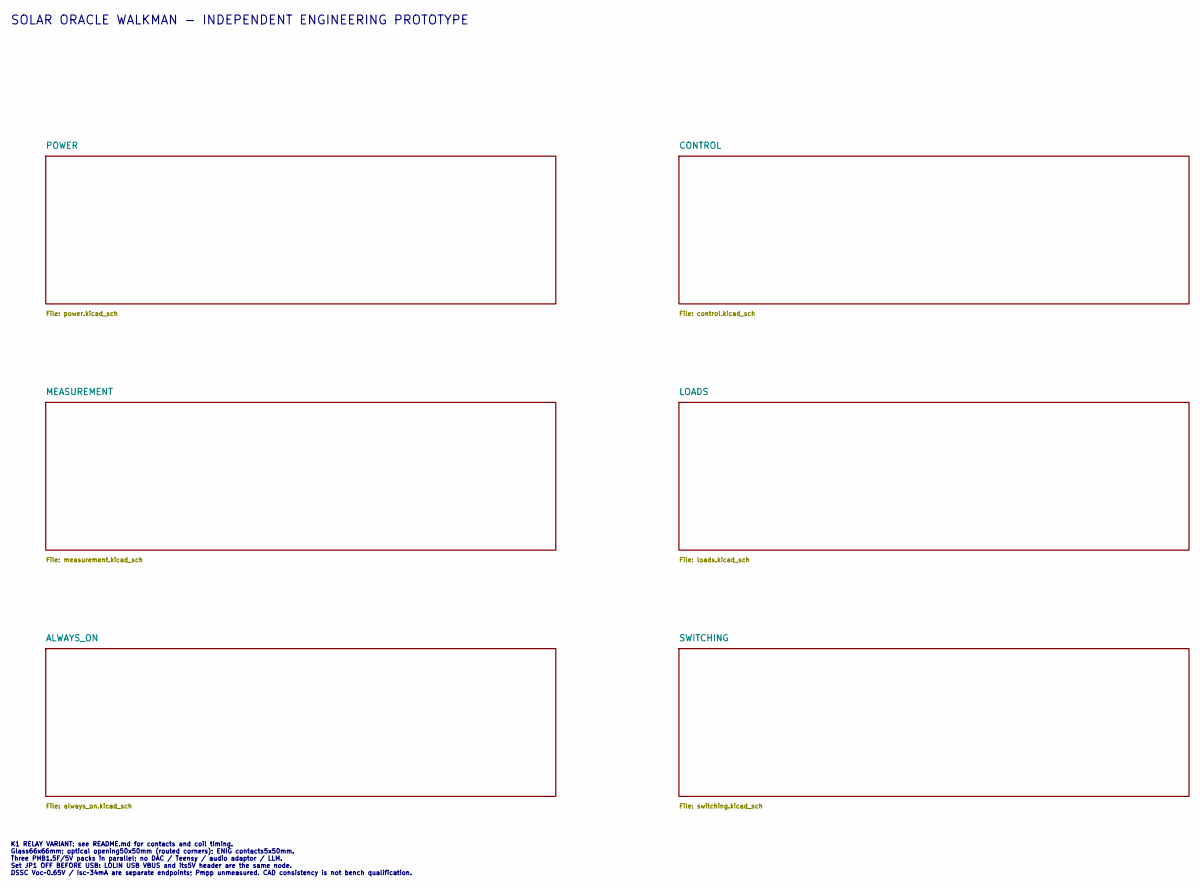
[picture p41: schematic solar-oracle-walkman-relay.kicad_sch, Solar Oracle Walkman - K1 Relay]

Notes on the sheet:
SOLAR ORACLE WALKMAN - INDEPENDENT ENGINEERING PROTOTYPE
K1 RELAY VARIANT: see README.md for contacts and coil timing. Glass66x66mm; optical opening50x50mm (routed corners); ENIG contacts5x50mm. Three PHB1.5F/5V packs in parallel; no DAC / Teensy / audio adaptor / LLM. Set JP1 OFF BEFORE USB: LOLIN USB VBUS and its5V header are the same node. DSSC Voc~0.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

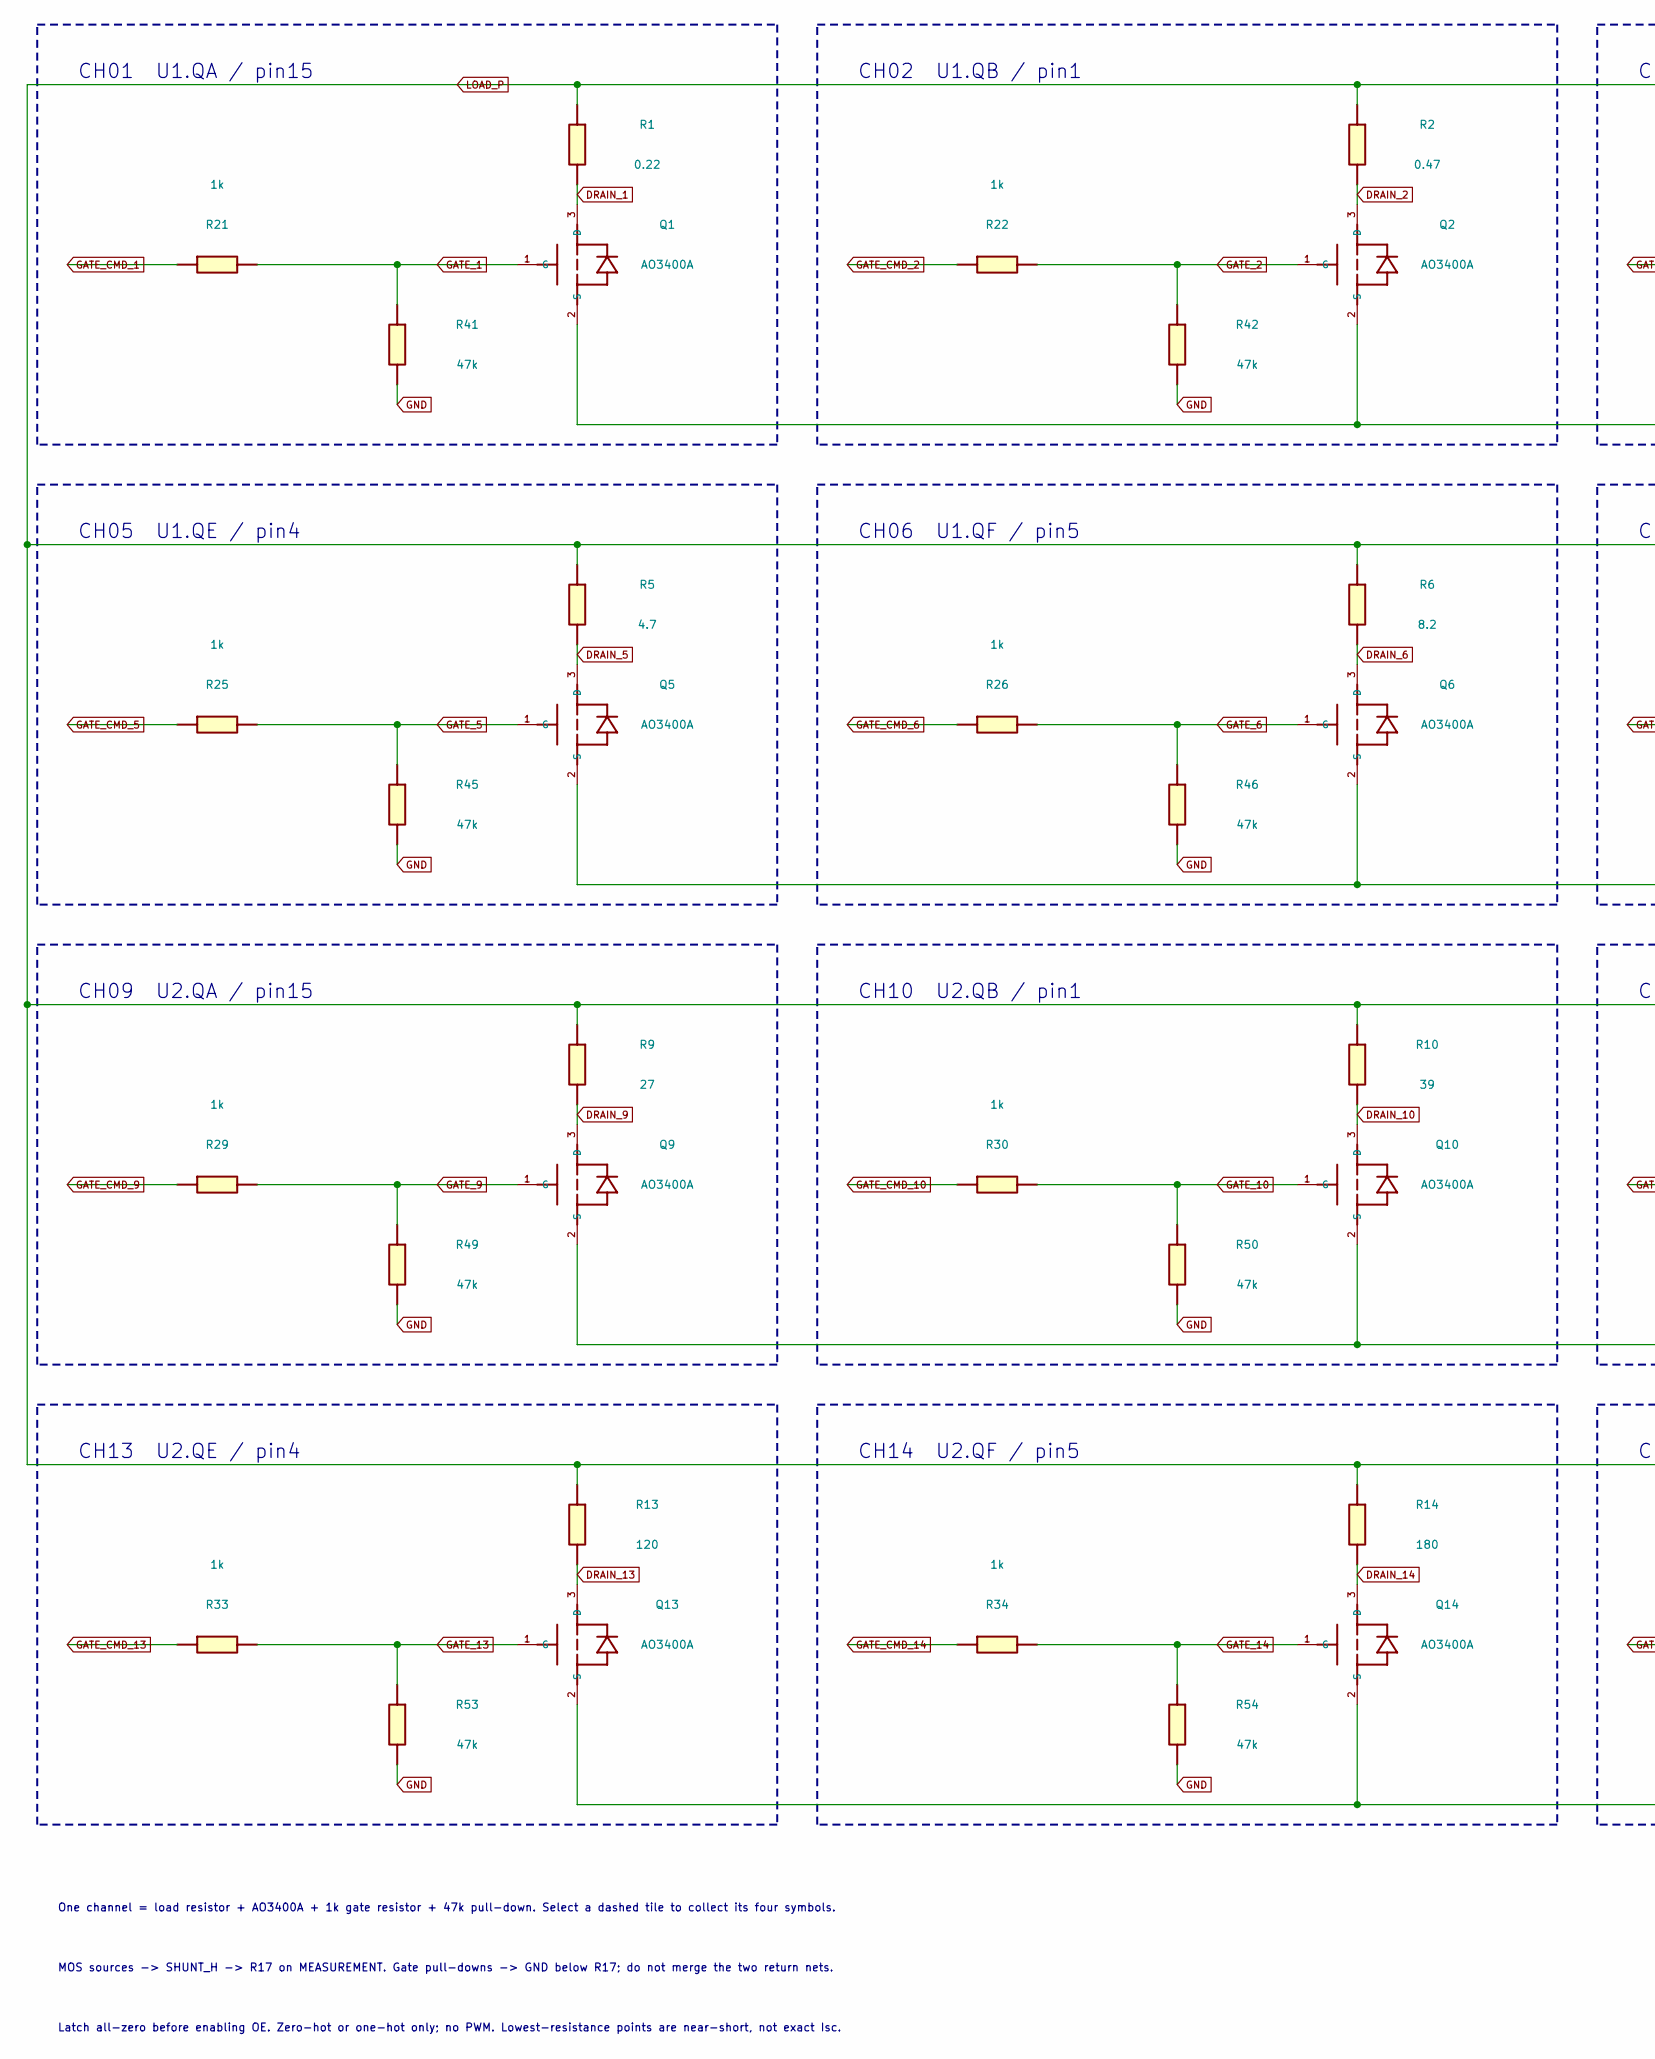
[picture p42: schematic loads.kicad_sch, LOADS: 16 fixed resistor channels / explicit wiring, part in row 1, column 1]

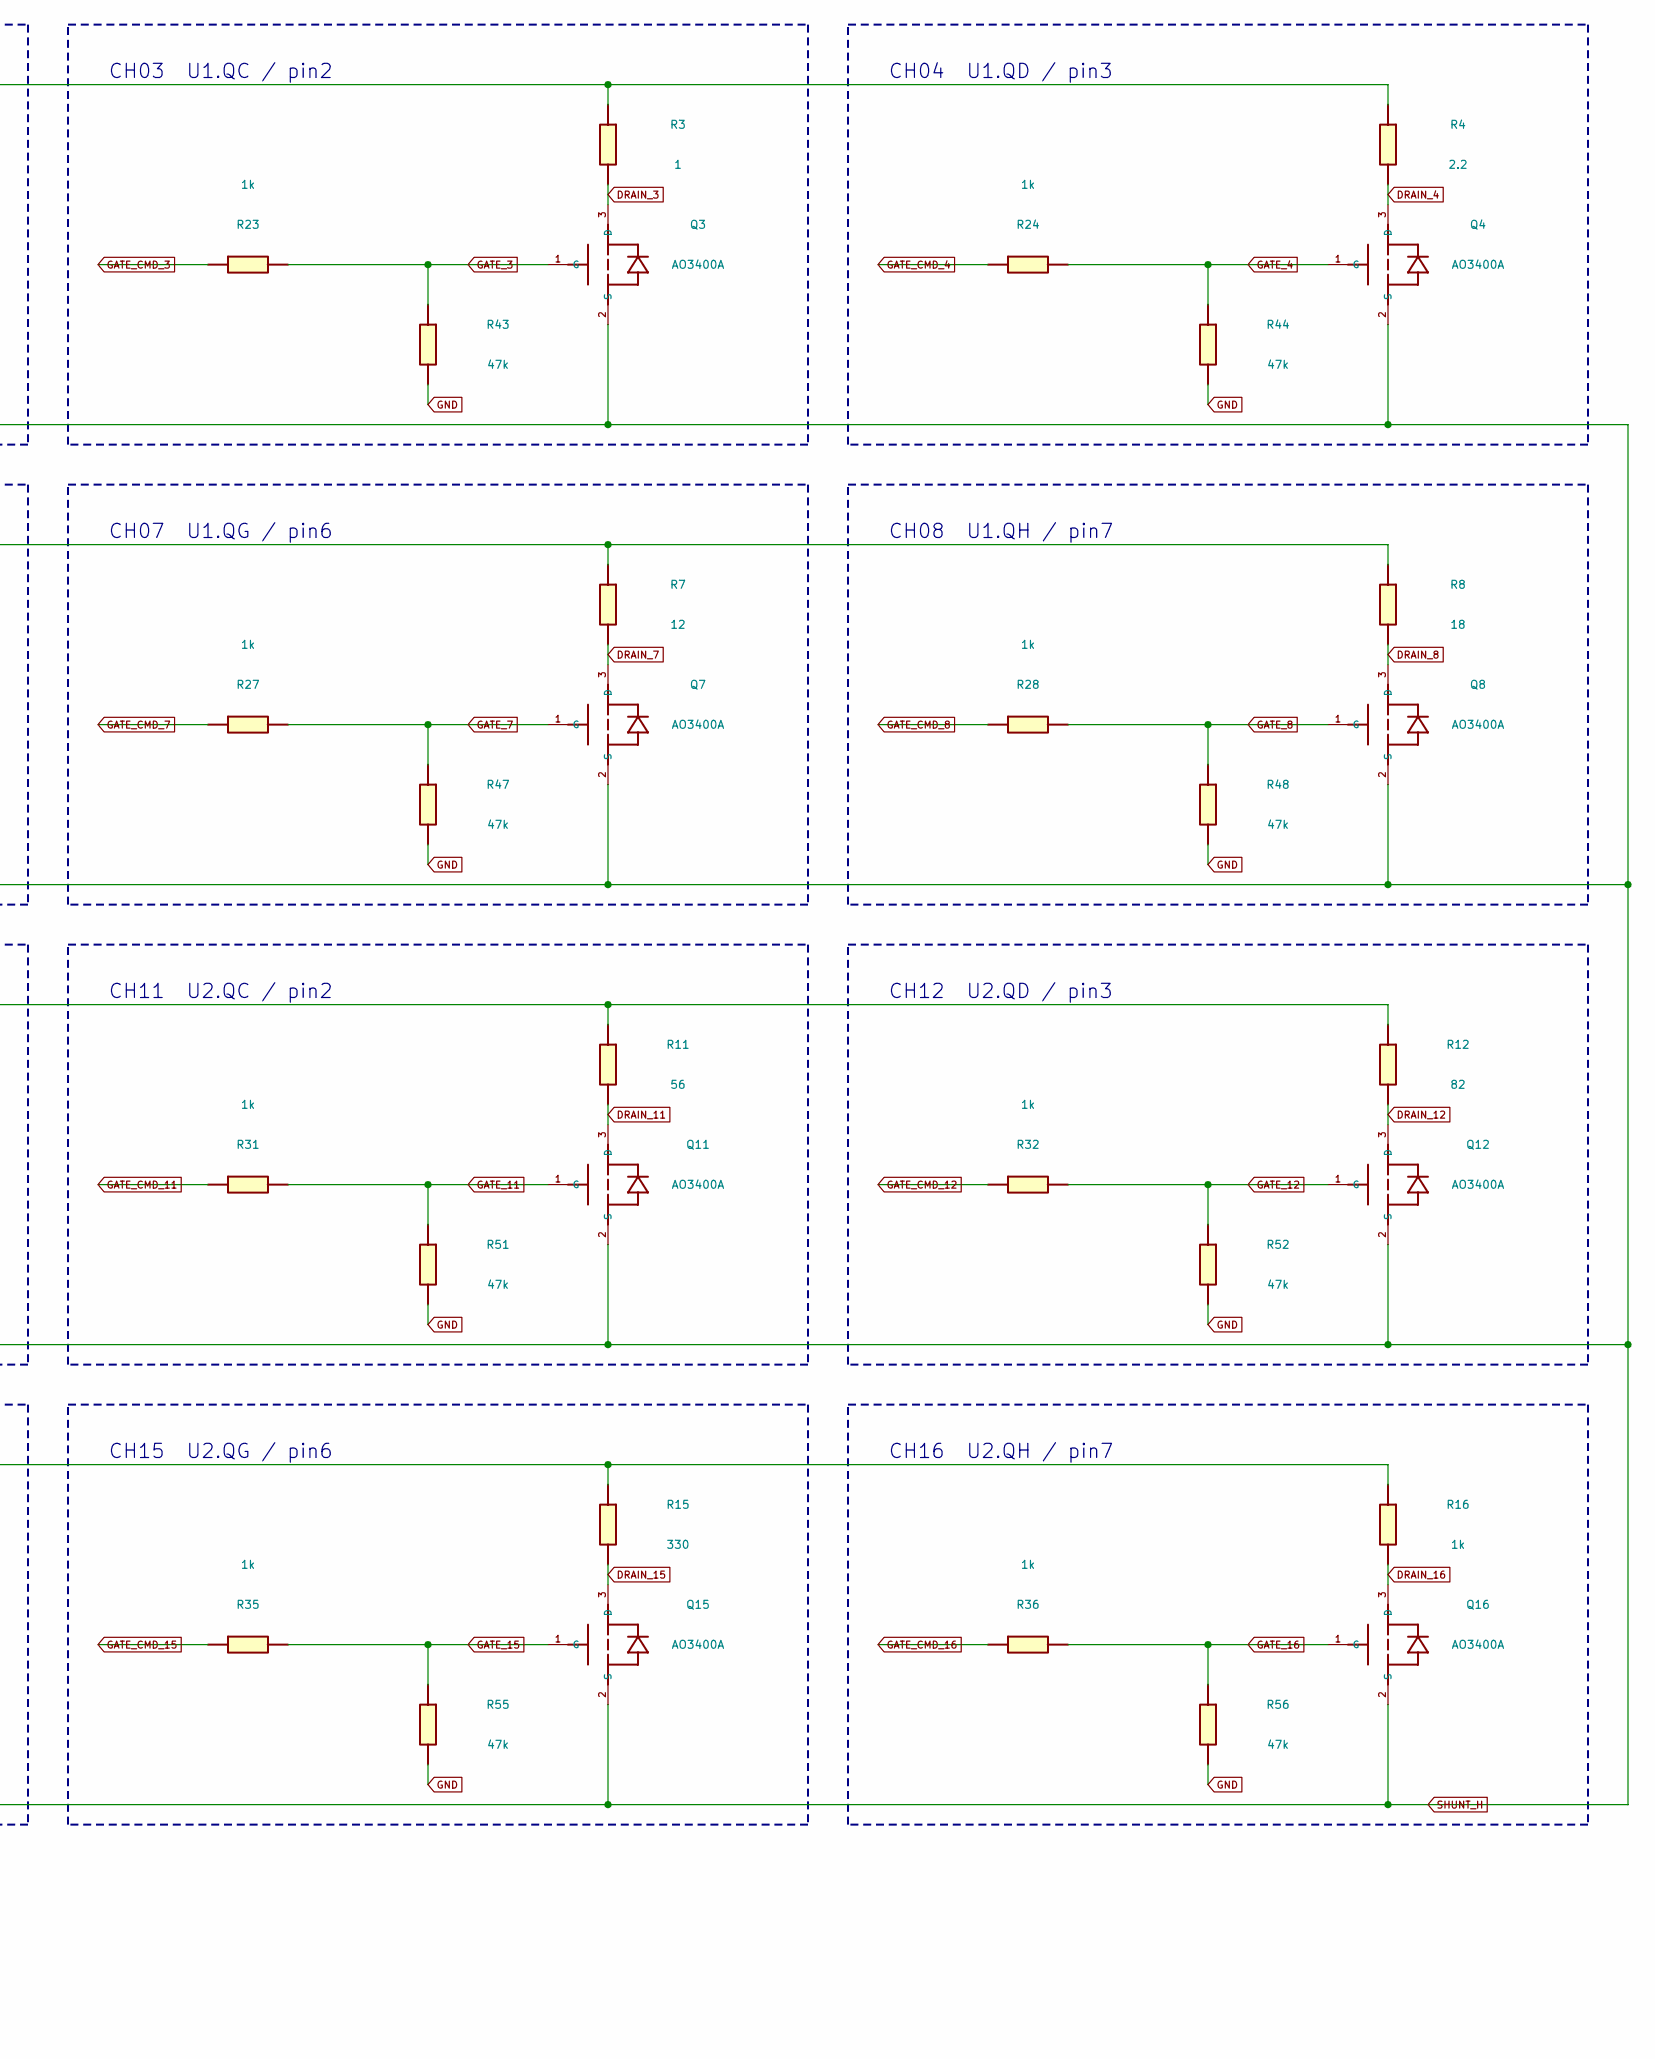
[picture p43: schematic loads.kicad_sch, LOADS: 16 fixed resistor channels / explicit wiring, part in row 1, column 2]

Parts:
Q1, Q2, Q3, Q4, Q5, Q6, Q7, Q8, Q9, Q10, Q11, Q12, Q13, Q14, Q15, Q16: AO3400A; SOT-23; MPN AO3400A
R1: 0.22; R_1206_3216Metric; MPN RL1206FR-070R22L
R2: 0.47; R_1206_3216Metric; MPN RL1206FR-070R47L
R3: 1; R_1206_3216Metric; MPN RT1206BRD071RL
R4: 2.2; R_1206_3216Metric; MPN RT1206BRD072R2L
R5: 4.7; R_1206_3216Metric; MPN RT1206BRD074R7L
R6: 8.2; R_1206_3216Metric; MPN RT1206BRD078R2L
R7: 12; R_1206_3216Metric; MPN RT1206BRD0712RL
R8: 18; R_1206_3216Metric; MPN RT1206BRD0718RL
R9: 27; R_1206_3216Metric; MPN RT1206BRD0727RL
R10: 39; R_1206_3216Metric; MPN RT1206BRD0739RL
R11: 56; R_1206_3216Metric; MPN RT1206BRD0756RL
R12: 82; R_1206_3216Metric; MPN RT1206BRD0782RL
R13: 120; R_1206_3216Metric; MPN RT1206BRD07120RL
R14: 180; R_1206_3216Metric; MPN RT1206BRD07180RL
R15: 330; R_1206_3216Metric; MPN RT1206BRD07330RL
R16: 1k; R_1206_3216Metric; MPN RT1206BRD071KL
R21, R22, R23, R24, R25, R26, R27, R28, R29, R30, R31, R32, R33, R34, R35, R36: 1k; R_0603_1608Metric; MPN RC0603FR-071KL
R41, R42, R43, R44, R45, R46, R47, R48, R49, R50, R51, R52, R53, R54, R55, R56: 47k; R_0603_1608Metric; MPN RC0603FR-0747KL

Connections:
DRAIN_1: Q1.3 (D), R1.2
DRAIN_2: Q2.3 (D), R2.2
DRAIN_3: Q3.3 (D), R3.2
DRAIN_4: Q4.3 (D), R4.2
DRAIN_5: Q5.3 (D), R5.2
DRAIN_6: Q6.3 (D), R6.2
DRAIN_7: Q7.3 (D), R7.2
DRAIN_8: Q8.3 (D), R8.2
DRAIN_9: Q9.3 (D), R9.2
DRAIN_10: Q10.3 (D), R10.2
DRAIN_11: Q11.3 (D), R11.2
DRAIN_12: Q12.3 (D), R12.2
DRAIN_13: Q13.3 (D), R13.2
DRAIN_14: Q14.3 (D), R14.2
DRAIN_15: Q15.3 (D), R15.2
DRAIN_16: Q16.3 (D), R16.2
GATE_1: Q1.1 (G), R21.2, R41.1
GATE_2: Q2.1 (G), R22.2, R42.1
GATE_3: Q3.1 (G), R23.2, R43.1
GATE_4: Q4.1 (G), R24.2, R44.1
GATE_5: Q5.1 (G), R25.2, R45.1
GATE_6: Q6.1 (G), R26.2, R46.1
GATE_7: Q7.1 (G), R27.2, R47.1
GATE_8: Q8.1 (G), R28.2, R48.1
GATE_9: Q9.1 (G), R29.2, R49.1
GATE_10: Q10.1 (G), R30.2, R50.1
GATE_11: Q11.1 (G), R31.2, R51.1
GATE_12: Q12.1 (G), R32.2, R52.1
GATE_13: Q13.1 (G), R33.2, R53.1
GATE_14: Q14.1 (G), R34.2, R54.1
GATE_15: Q15.1 (G), R35.2, R55.1
GATE_16: Q16.1 (G), R36.2, R56.1
GATE_CMD_1: R21.1; also elsewhere on the board
GATE_CMD_2: R22.1; also elsewhere on the board
GATE_CMD_3: R23.1; also elsewhere on the board
GATE_CMD_4: R24.1; also elsewhere on the board
GATE_CMD_5: R25.1; also elsewhere on the board
GATE_CMD_6: R26.1; also elsewhere on the board
GATE_CMD_7: R27.1; also elsewhere on the board
GATE_CMD_8: R28.1; also elsewhere on the board
GATE_CMD_9: R29.1; also elsewhere on the board
GATE_CMD_10: R30.1; also elsewhere on the board
GATE_CMD_11: R31.1; also elsewhere on the board
GATE_CMD_12: R32.1; also elsewhere on the board
GATE_CMD_13: R33.1; also elsewhere on the board
GATE_CMD_14: R34.1; also elsewhere on the board
GATE_CMD_15: R35.1; also elsewhere on the board
GATE_CMD_16: R36.1; also elsewhere on the board
GND: R41.2, R42.2, R43.2, R44.2, R45.2, R46.2, R47.2, R48.2, R49.2, R50.2, R51.2, R52.2, R53.2, R54.2, R55.2, R56.2; also elsewhere on the board
LOAD_P: R1.1, R2.1, R3.1, R4.1, R5.1, R6.1, R7.1, R8.1, R9.1, R10.1, R11.1, R12.1, R13.1, R14.1, R15.1, R16.1; also elsewhere on the board
SHUNT_H: Q1.2 (S), Q2.2 (S), Q3.2 (S), Q4.2 (S), Q5.2 (S), Q6.2 (S), Q7.2 (S), Q8.2 (S), Q9.2 (S), Q10.2 (S), Q11.2 (S), Q12.2 (S), Q13.2 (S), Q14.2 (S), Q15.2 (S), Q16.2 (S); also elsewhere on the board

Notes on the sheet:
CH07 U1.QG / pin6
CH14 U2.QF / pin5
CH11 U2.QC / pin2
CH10 U2.QB / pin1
CH12 U2.QD / pin3
CH05 U1.QE / pin4
CH03 U1.QC / pin2
MOS sources -> SHUNT_H -> R17 on MEASUREMENT. Gate pull-downs -> GND below R17; do not merge the two return nets.
One channel = load resistor + AO3400A + 1k gate resistor + 47k pull-down. Select a dashed tile to collect its four symbols.
Latch all-zero before enabling OE. Zero-hot or one-hot only; no PWM. Lowest-resistance points are near-short, not exact Isc.
CH15 U2.QG / pin6
CH01 U1.QA / pin15
CH09 U2.QA / pin15
CH02 U1.QB / pin1
CH04 U1.QD / pin3
CH16 U2.QH / pin7
CH13 U2.QE / pin4
CH06 U1.QF / pin5
CH08 U1.QH / pin7

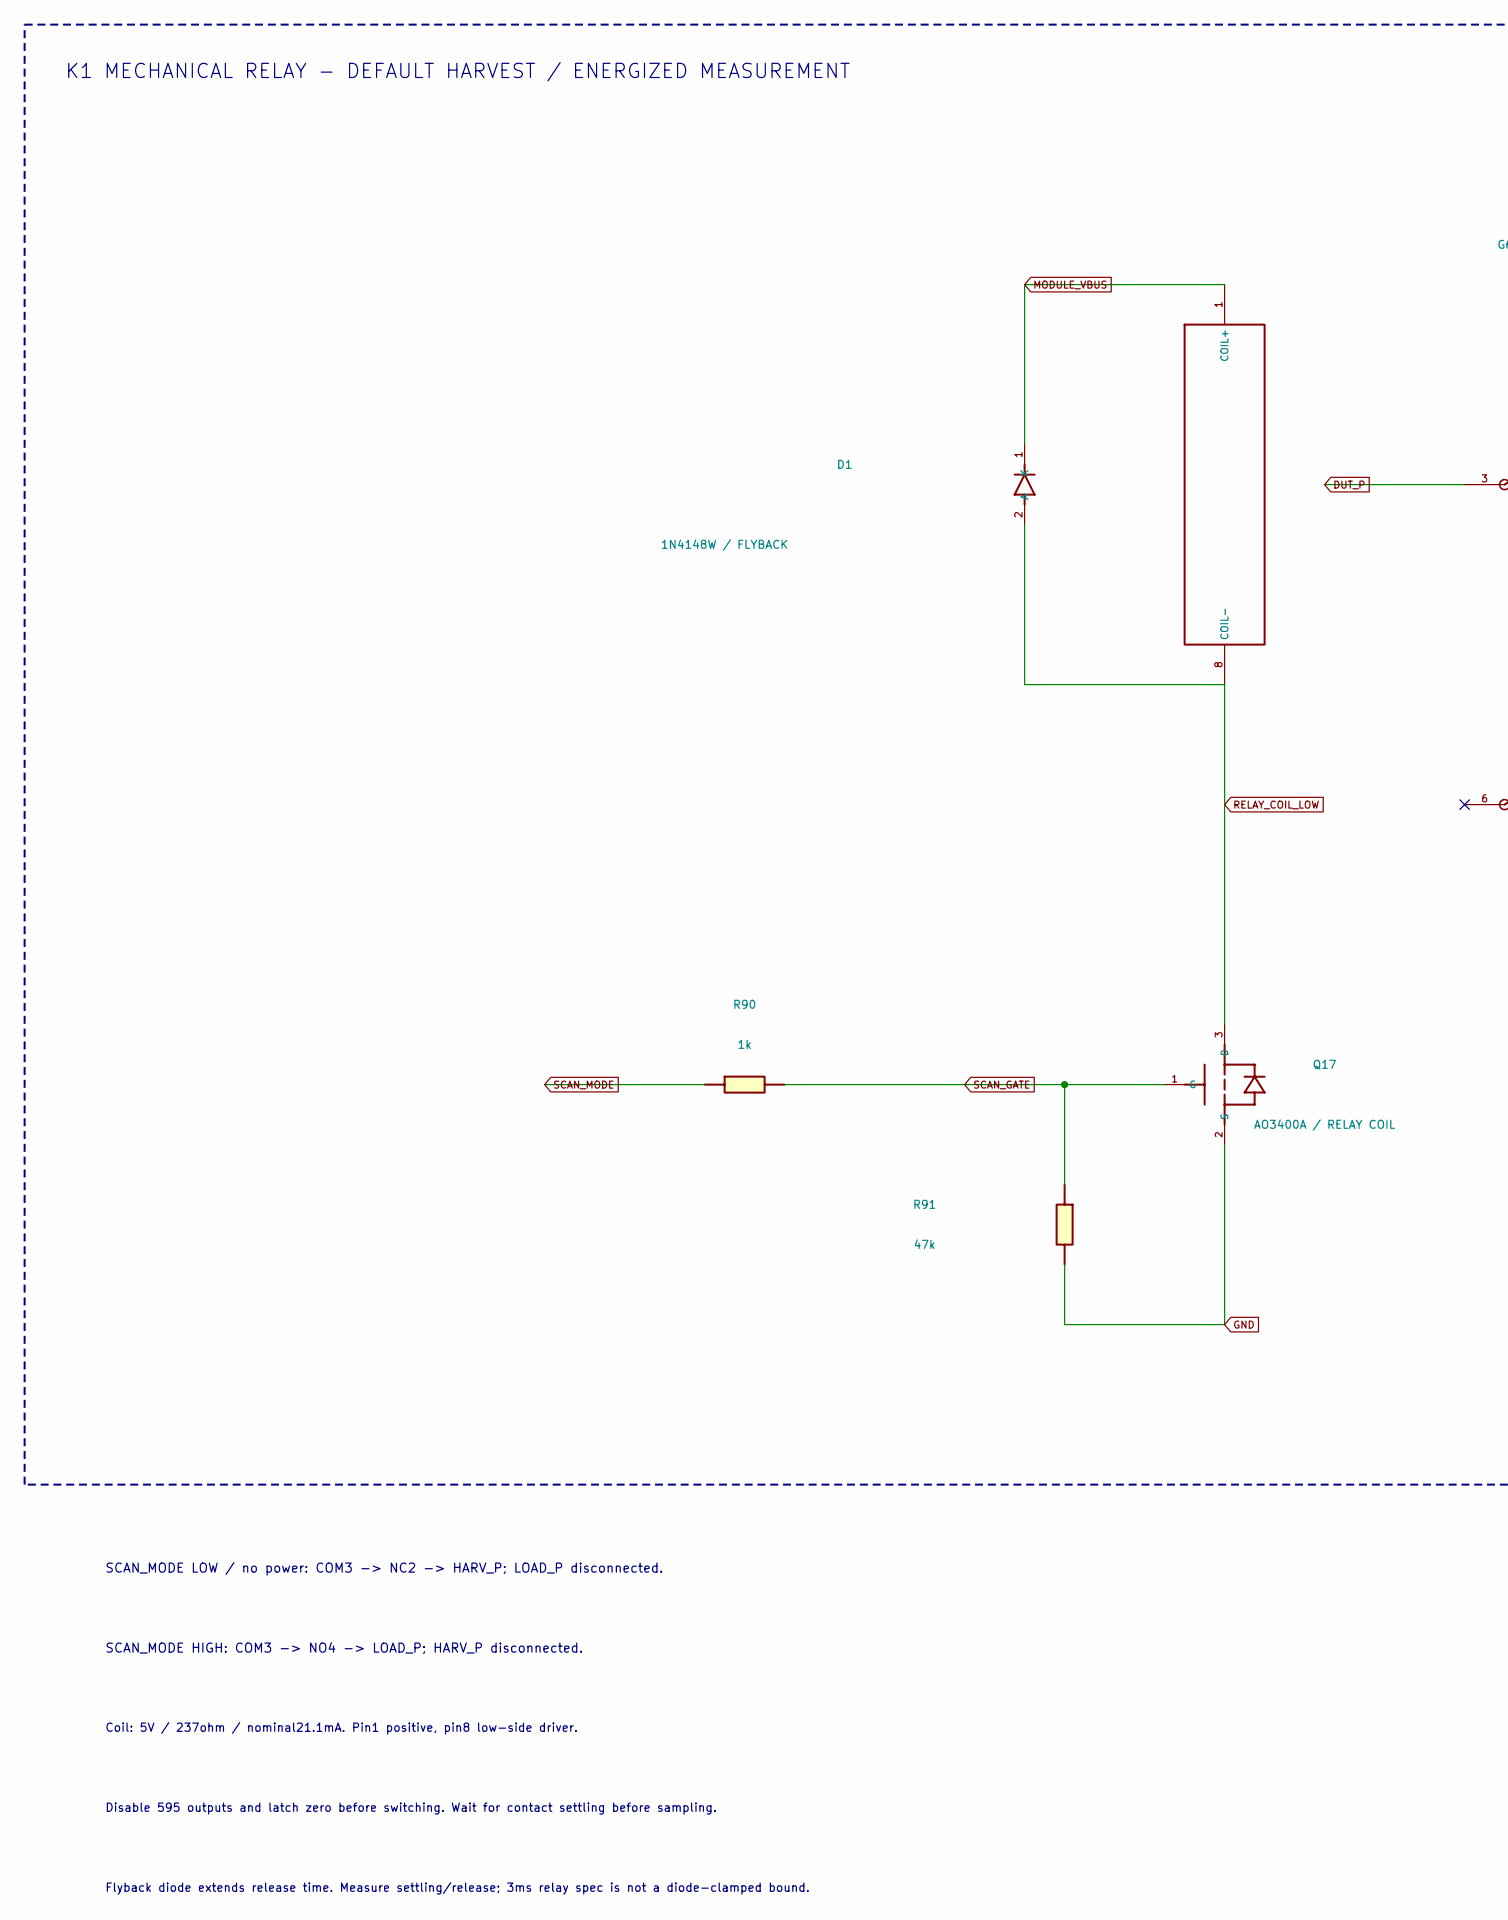
[picture p44: schematic switching.kicad_sch, SWITCHING: K1 relay / coil driver / flyback, part in row 1, column 1]

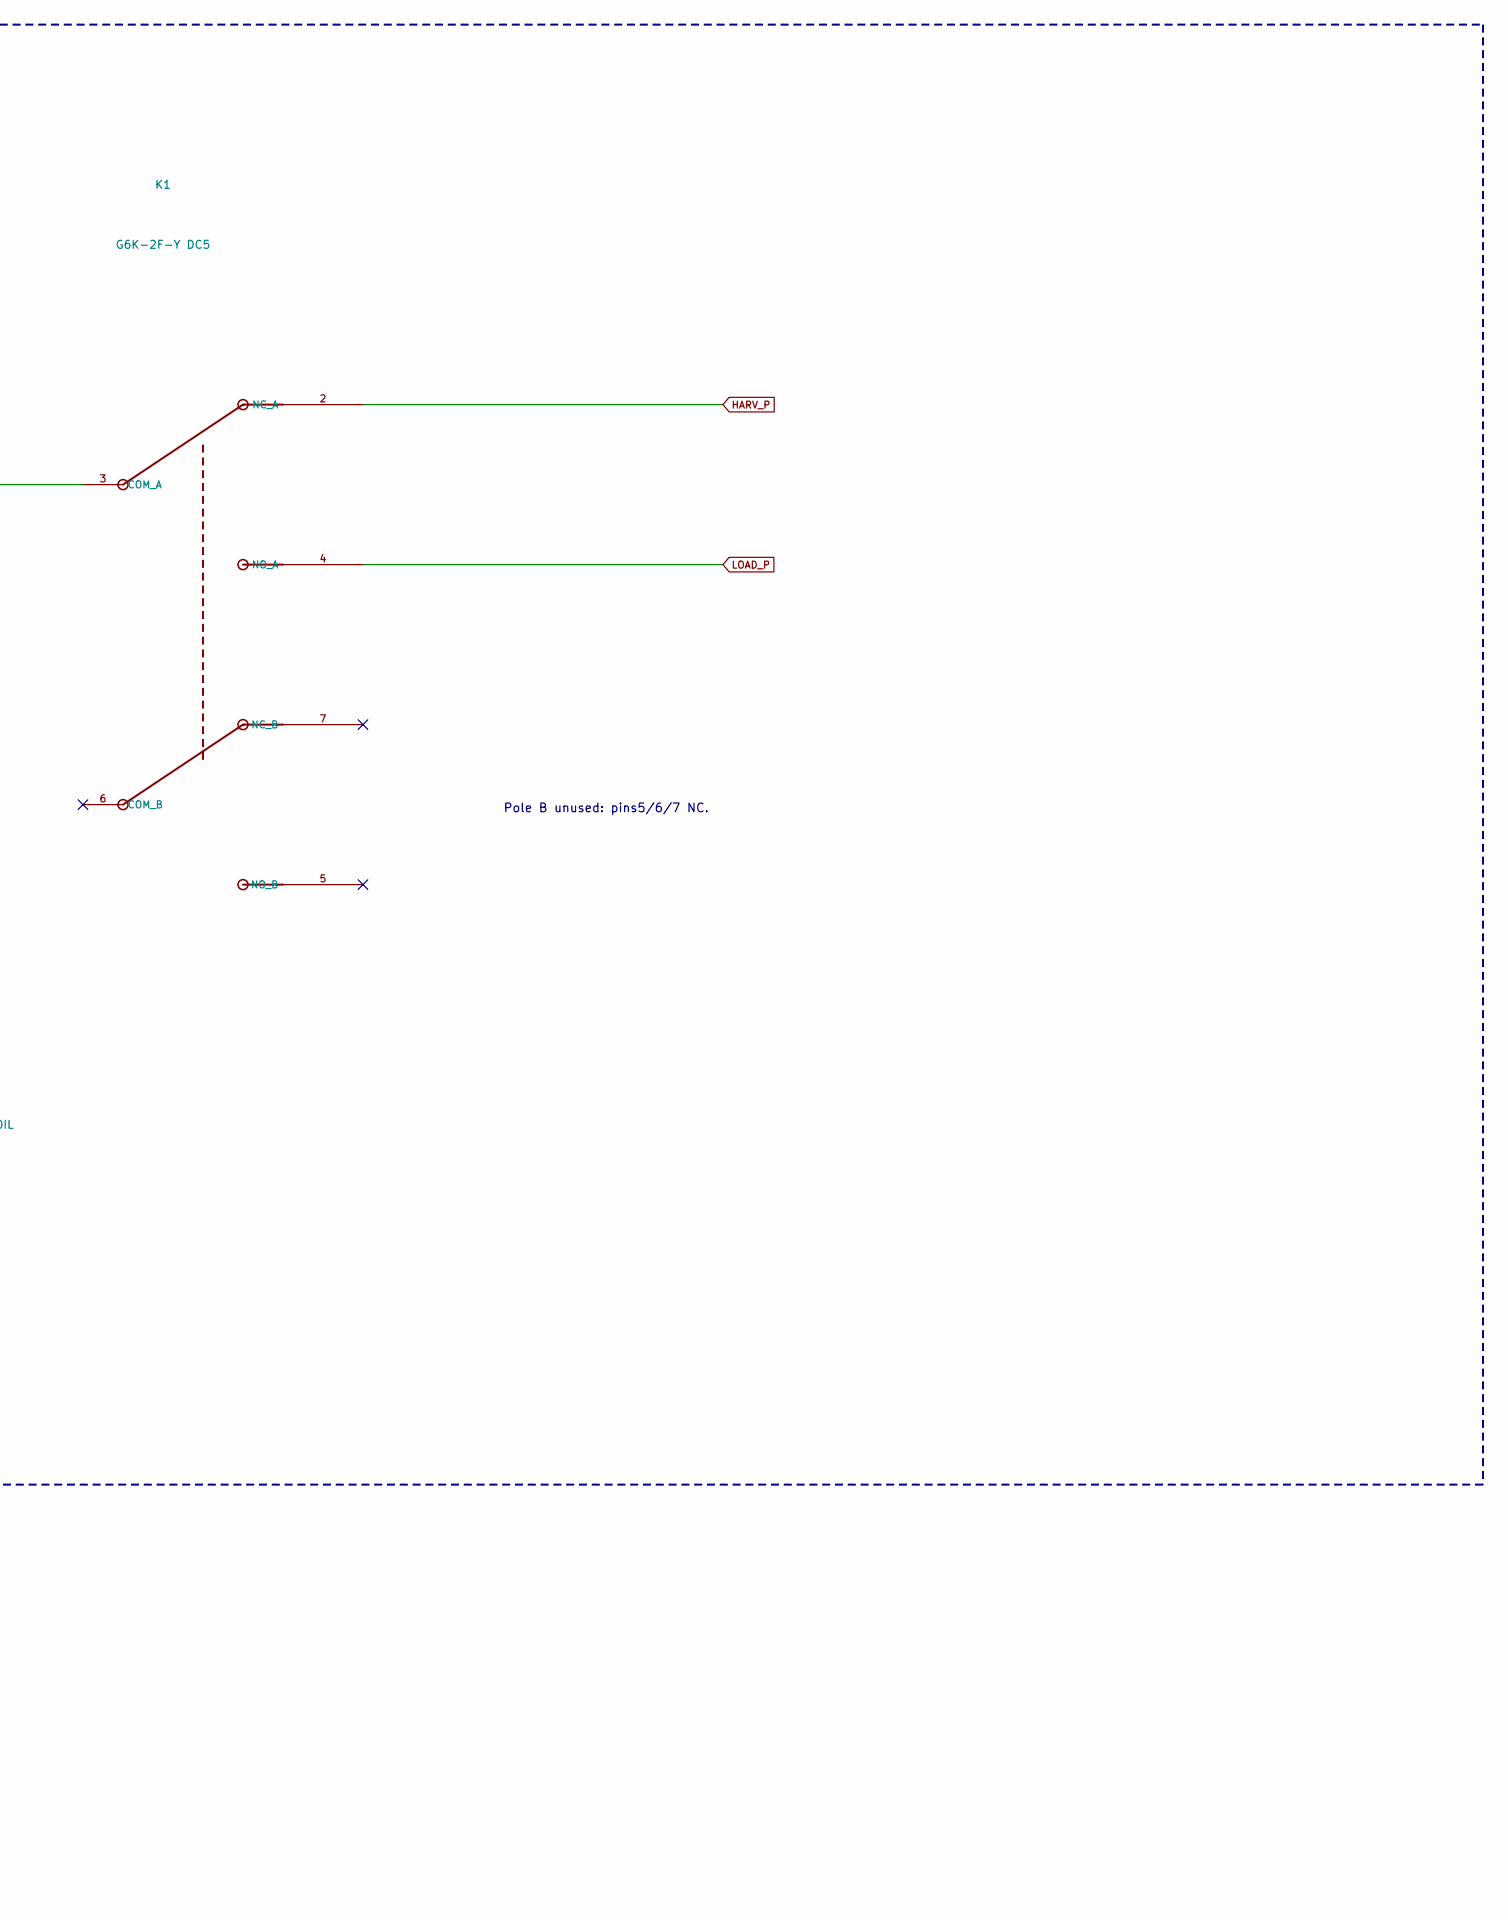
[picture p45: schematic switching.kicad_sch, SWITCHING: K1 relay / coil driver / flyback, part in row 1, column 2]

Parts:
D1: 1N4148W / FLYBACK; D_SOD-123; MPN 1N4148W-7-F
K1: G6K-2F-Y DC5; G6K_2F_Y; MPN G6K-2F-Y-TR DC5
Q17: AO3400A / RELAY COIL; SOT-23; MPN AO3400A
R90: 1k; R_0603_1608Metric; MPN RC0603FR-071KL
R91: 47k; R_0603_1608Metric; MPN RC0603FR-0747KL

Connections:
DUT_P: K1.3 (COM_A); also elsewhere on the board
GND: Q17.2 (S), R91.2; also elsewhere on the board
HARV_P: K1.2 (NC_A); also elsewhere on the board
LOAD_P: K1.4 (NO_A); also elsewhere on the board
MODULE_VBUS: D1.1 (K), K1.1 (COIL+); also elsewhere on the board
RELAY_COIL_LOW: D1.2 (A), K1.8 (COIL-), Q17.3 (D)
SCAN_GATE: Q17.1 (G), R90.2, R91.1
SCAN_MODE: R90.1; also elsewhere on the board

Notes on the sheet:
SCAN_MODE HIGH: COM3 -> NO4 -> LOAD_P; HARV_P disconnected.
Flyback diode extends release time. Measure settling/release; 3ms relay spec is not a diode-clamped bound.
Coil: 5V / 237ohm / nominal21.1mA. Pin1 positive, pin8 low-side driver.
SCAN_MODE LOW / no power: COM3 -> NC2 -> HARV_P; LOAD_P disconnected.
K1 MECHANICAL RELAY - DEFAULT HARVEST / ENERGIZED MEASUREMENT
Disable 595 outputs and latch zero before switching. Wait for contact settling before sampling.
Pole B unused: pins5/6/7 NC.
