weiweiweiopen/Solar-Oracle-Walkman-1.0/hardware/solar-oracle-walkman-relay.kicad_pcb

## KiCad design hardware/solar-oracle-walkman-relay.kicad_pcb (continued)

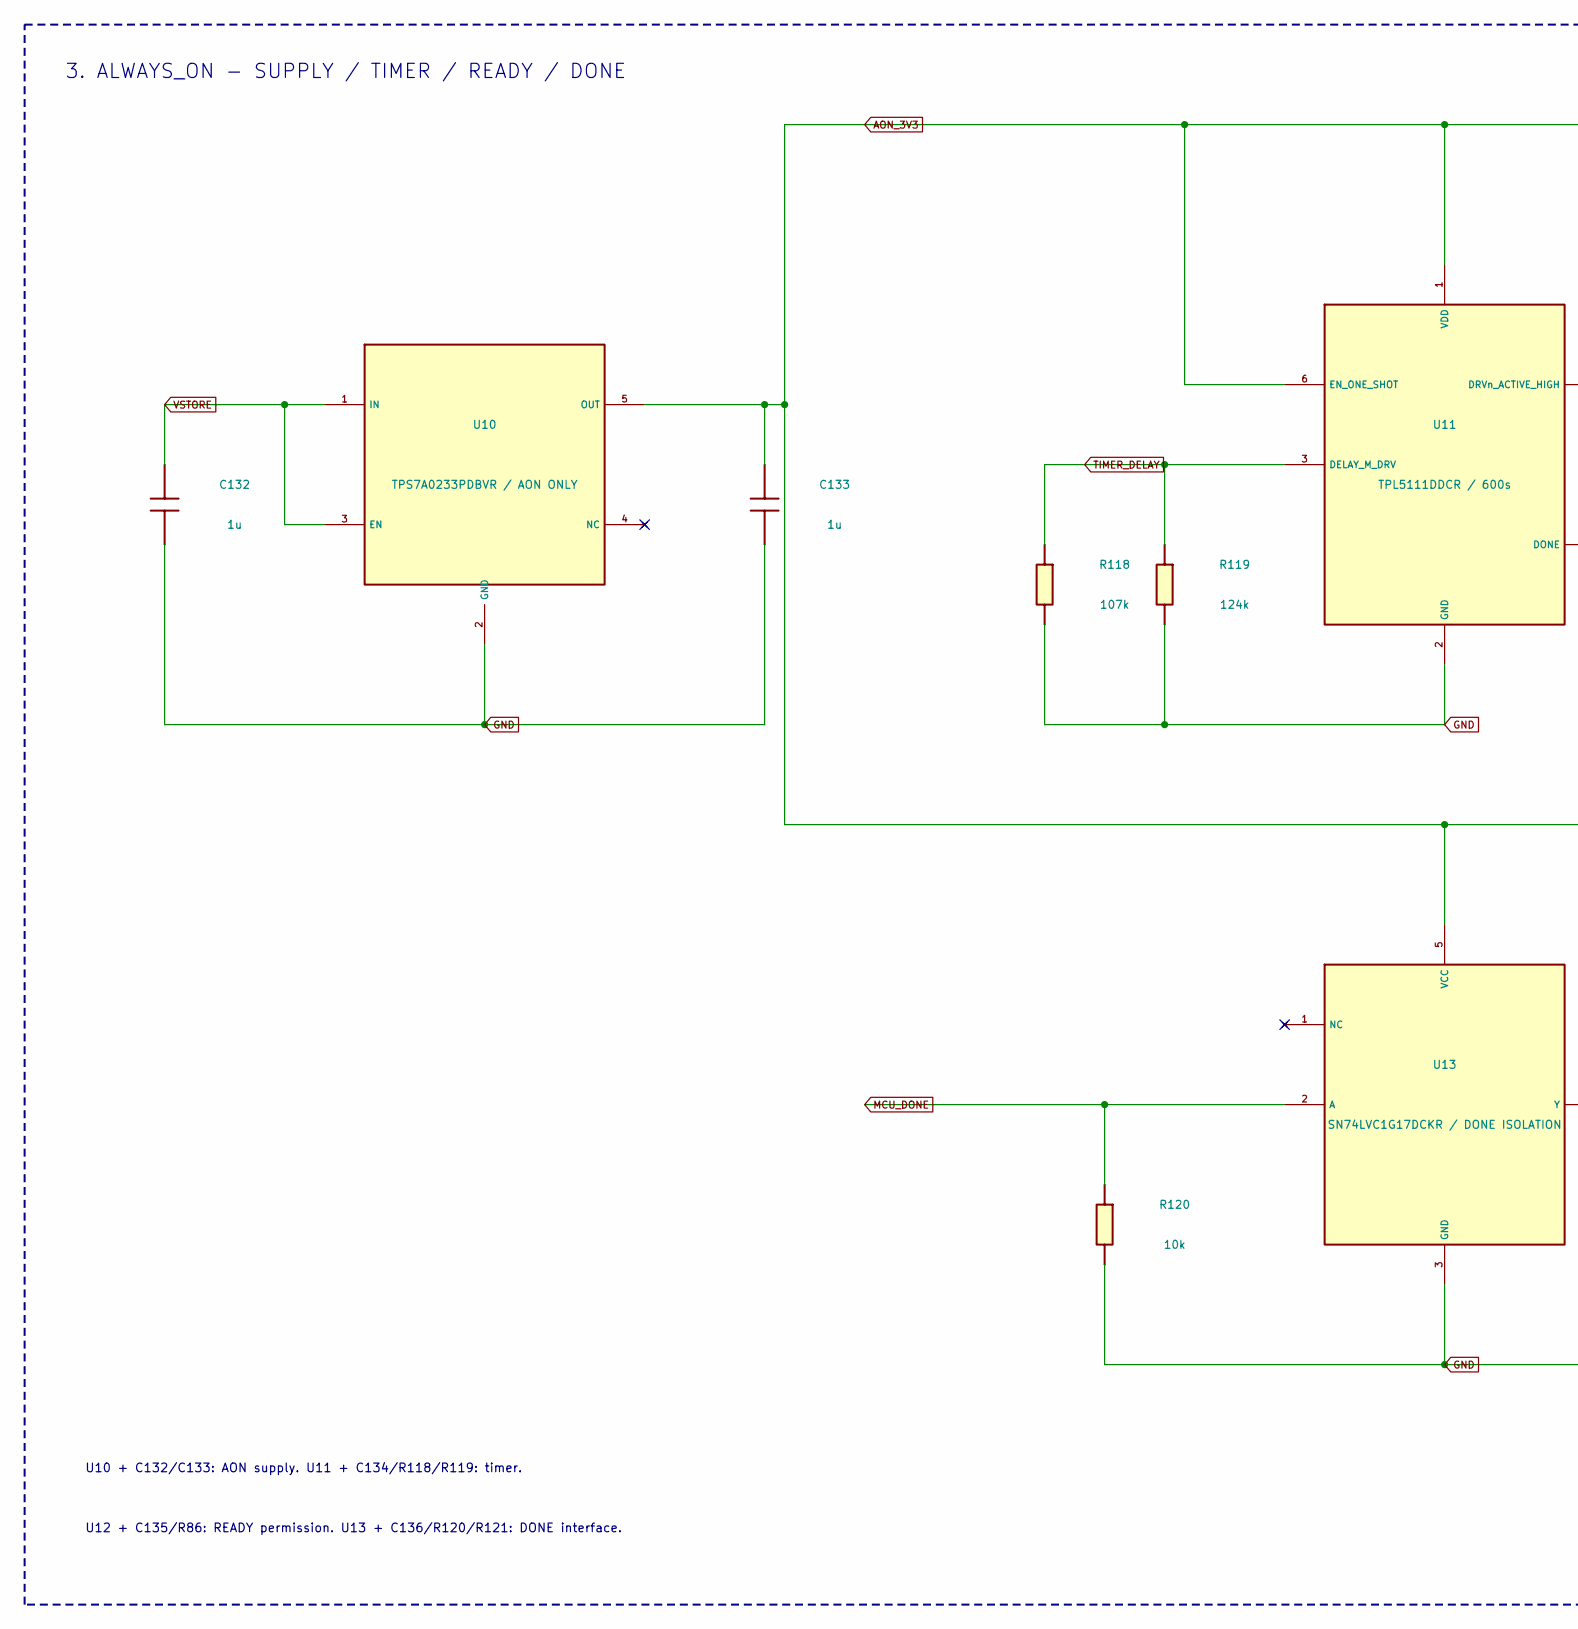
[picture p46: schematic always_on.kicad_sch, ALWAYS_ON: READY / timer / DONE, part in row 1, column 1]

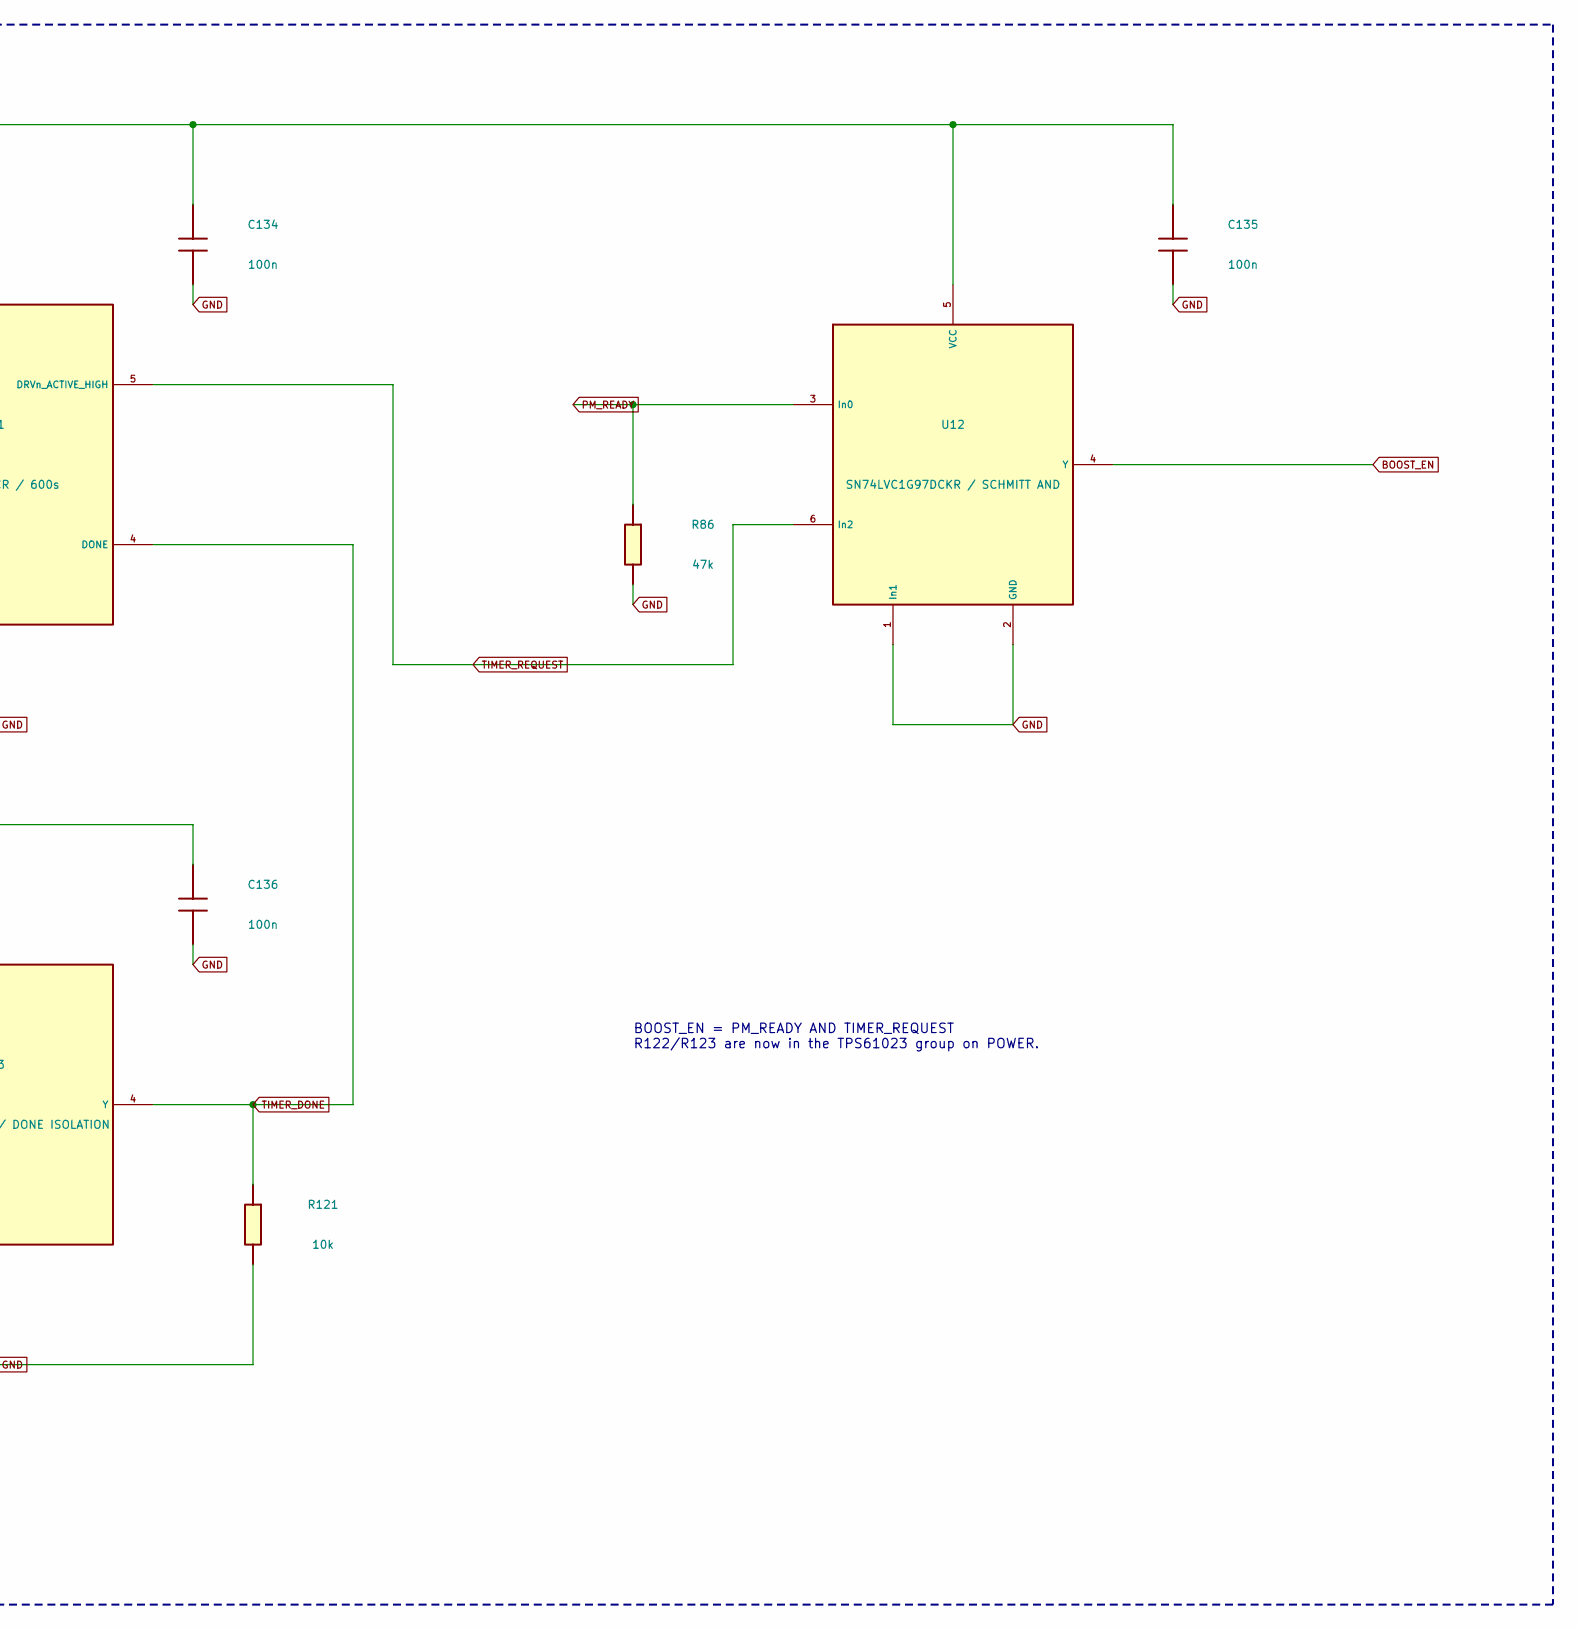
[picture p47: schematic always_on.kicad_sch, ALWAYS_ON: READY / timer / DONE, part in row 1, column 2]

Parts:
C132, C133: 1u; C_0805_2012Metric; MPN GRM21BR71C105KA01L
C134, C135, C136: 100n; C_0805_2012Metric; MPN GRM21BR71H104KA01L
R86: 47k; R_0603_1608Metric; MPN RC0603FR-0747KL
R118: 107k; R_0603_1608Metric; MPN RC0603FR-07107KL
R119: 124k; R_0603_1608Metric; MPN RC0603FR-07124KL
R120, R121: 10k; R_0603_1608Metric; MPN RC0603FR-0710KL
U10: TPS7A0233PDBVR / AON ONLY; SOT-23-5; MPN TPS7A0233PDBVR
U11: TPL5111DDCR / 600s; SOT-23-6; MPN TPL5111DDCR
U12: SN74LVC1G97DCKR / SCHMITT AND; SOT-363_SC-70-6; MPN SN74LVC1G97DCKR
U13: SN74LVC1G17DCKR / DONE ISOLATION; SOT-353_SC-70-5; MPN SN74LVC1G17DCKR

Connections:
AON_3V3: C133.1, C134.1, C135.1, C136.1, U10.5 (OUT), U11.1 (VDD), U11.6 (EN_ONE_SHOT), U12.5 (VCC), U13.5 (VCC)
BOOST_EN: U12.4 (Y); also elsewhere on the board
GND: C132.2, C133.2, C134.2, C135.2, C136.2, R86.2, R118.2, R119.2, R120.2, R121.2, U10.2 (GND), U11.2 (GND), U12.1 (In1), U12.2 (GND), U13.3 (GND); also elsewhere on the board
MCU_DONE: R120.1, U13.2 (A); also elsewhere on the board
PM_READY: R86.1, U12.3 (In0); also elsewhere on the board
TIMER_DELAY: R118.1, R119.1, U11.3 (DELAY_M_DRV)
TIMER_DONE: R121.1, U11.4 (DONE), U13.4 (Y)
TIMER_REQUEST: U11.5 (DRVn_ACTIVE_HIGH), U12.6 (In2)
VSTORE: C132.1, U10.1 (IN), U10.3 (EN); also elsewhere on the board

Notes on the sheet:
U12 + C135/R86: READY permission. U13 + C136/R120/R121: DONE interface.
U10 + C132/C133: AON supply. U11 + C134/R118/R119: timer.
3. ALWAYS_ON - SUPPLY / TIMER / READY / DONE
BOOST_EN = PM_READY AND TIMER_REQUEST R122/R123 are now in the TPS61023 group on POWER.

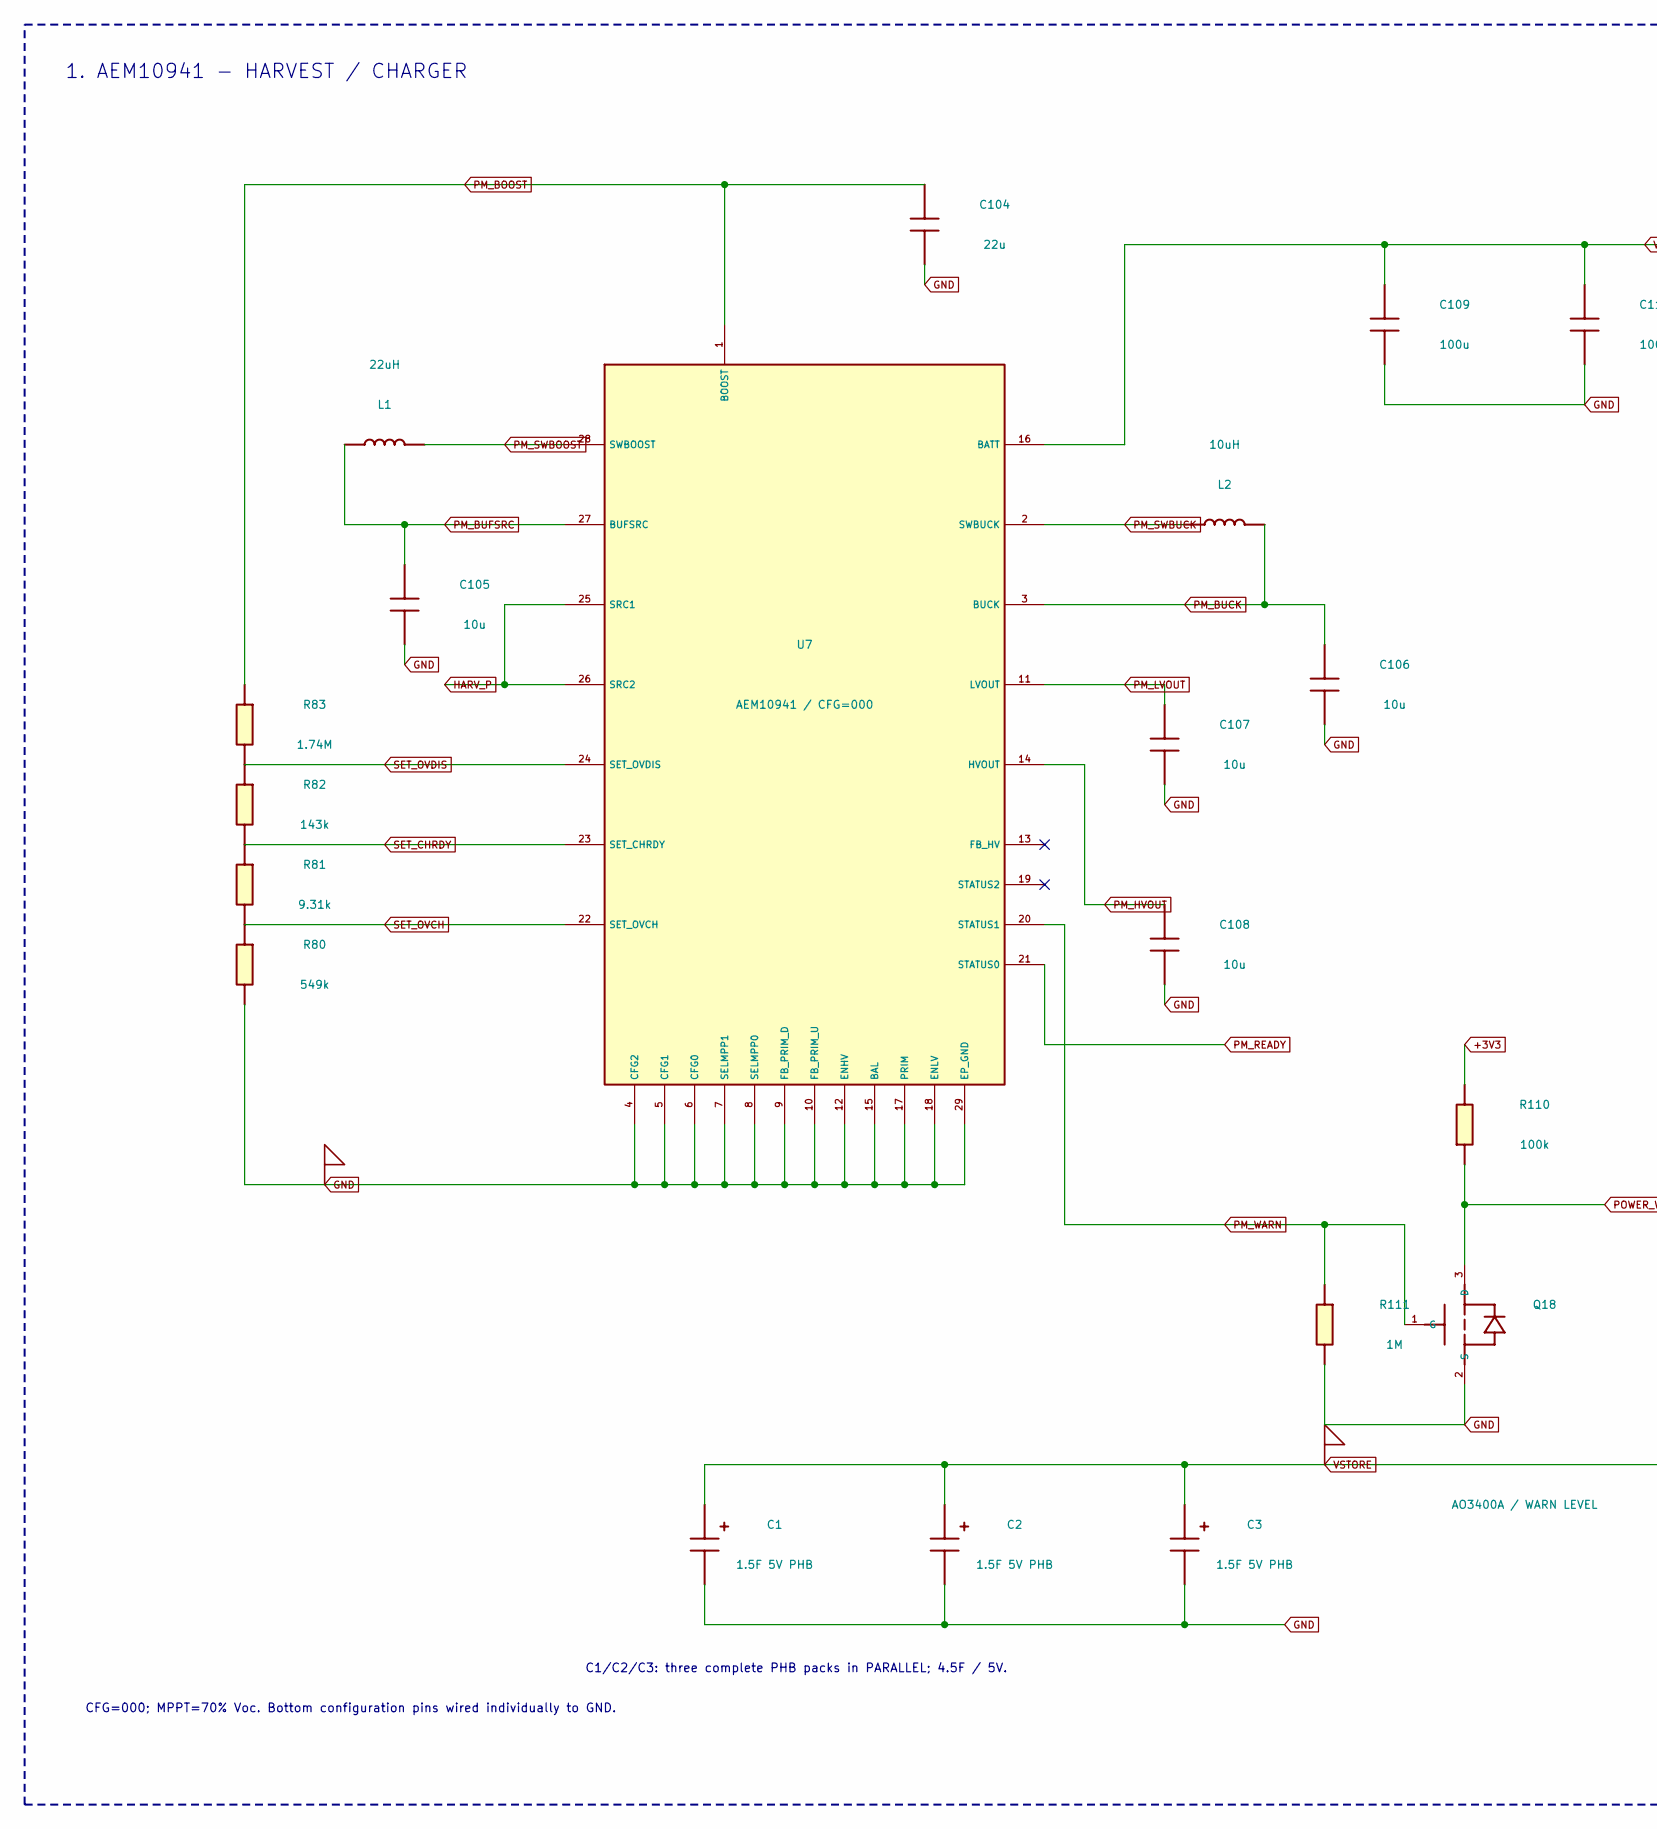
[picture p48: schematic power.kicad_sch, POWER: AEM harvest + TPS61023 5V, part in row 1, column 1]

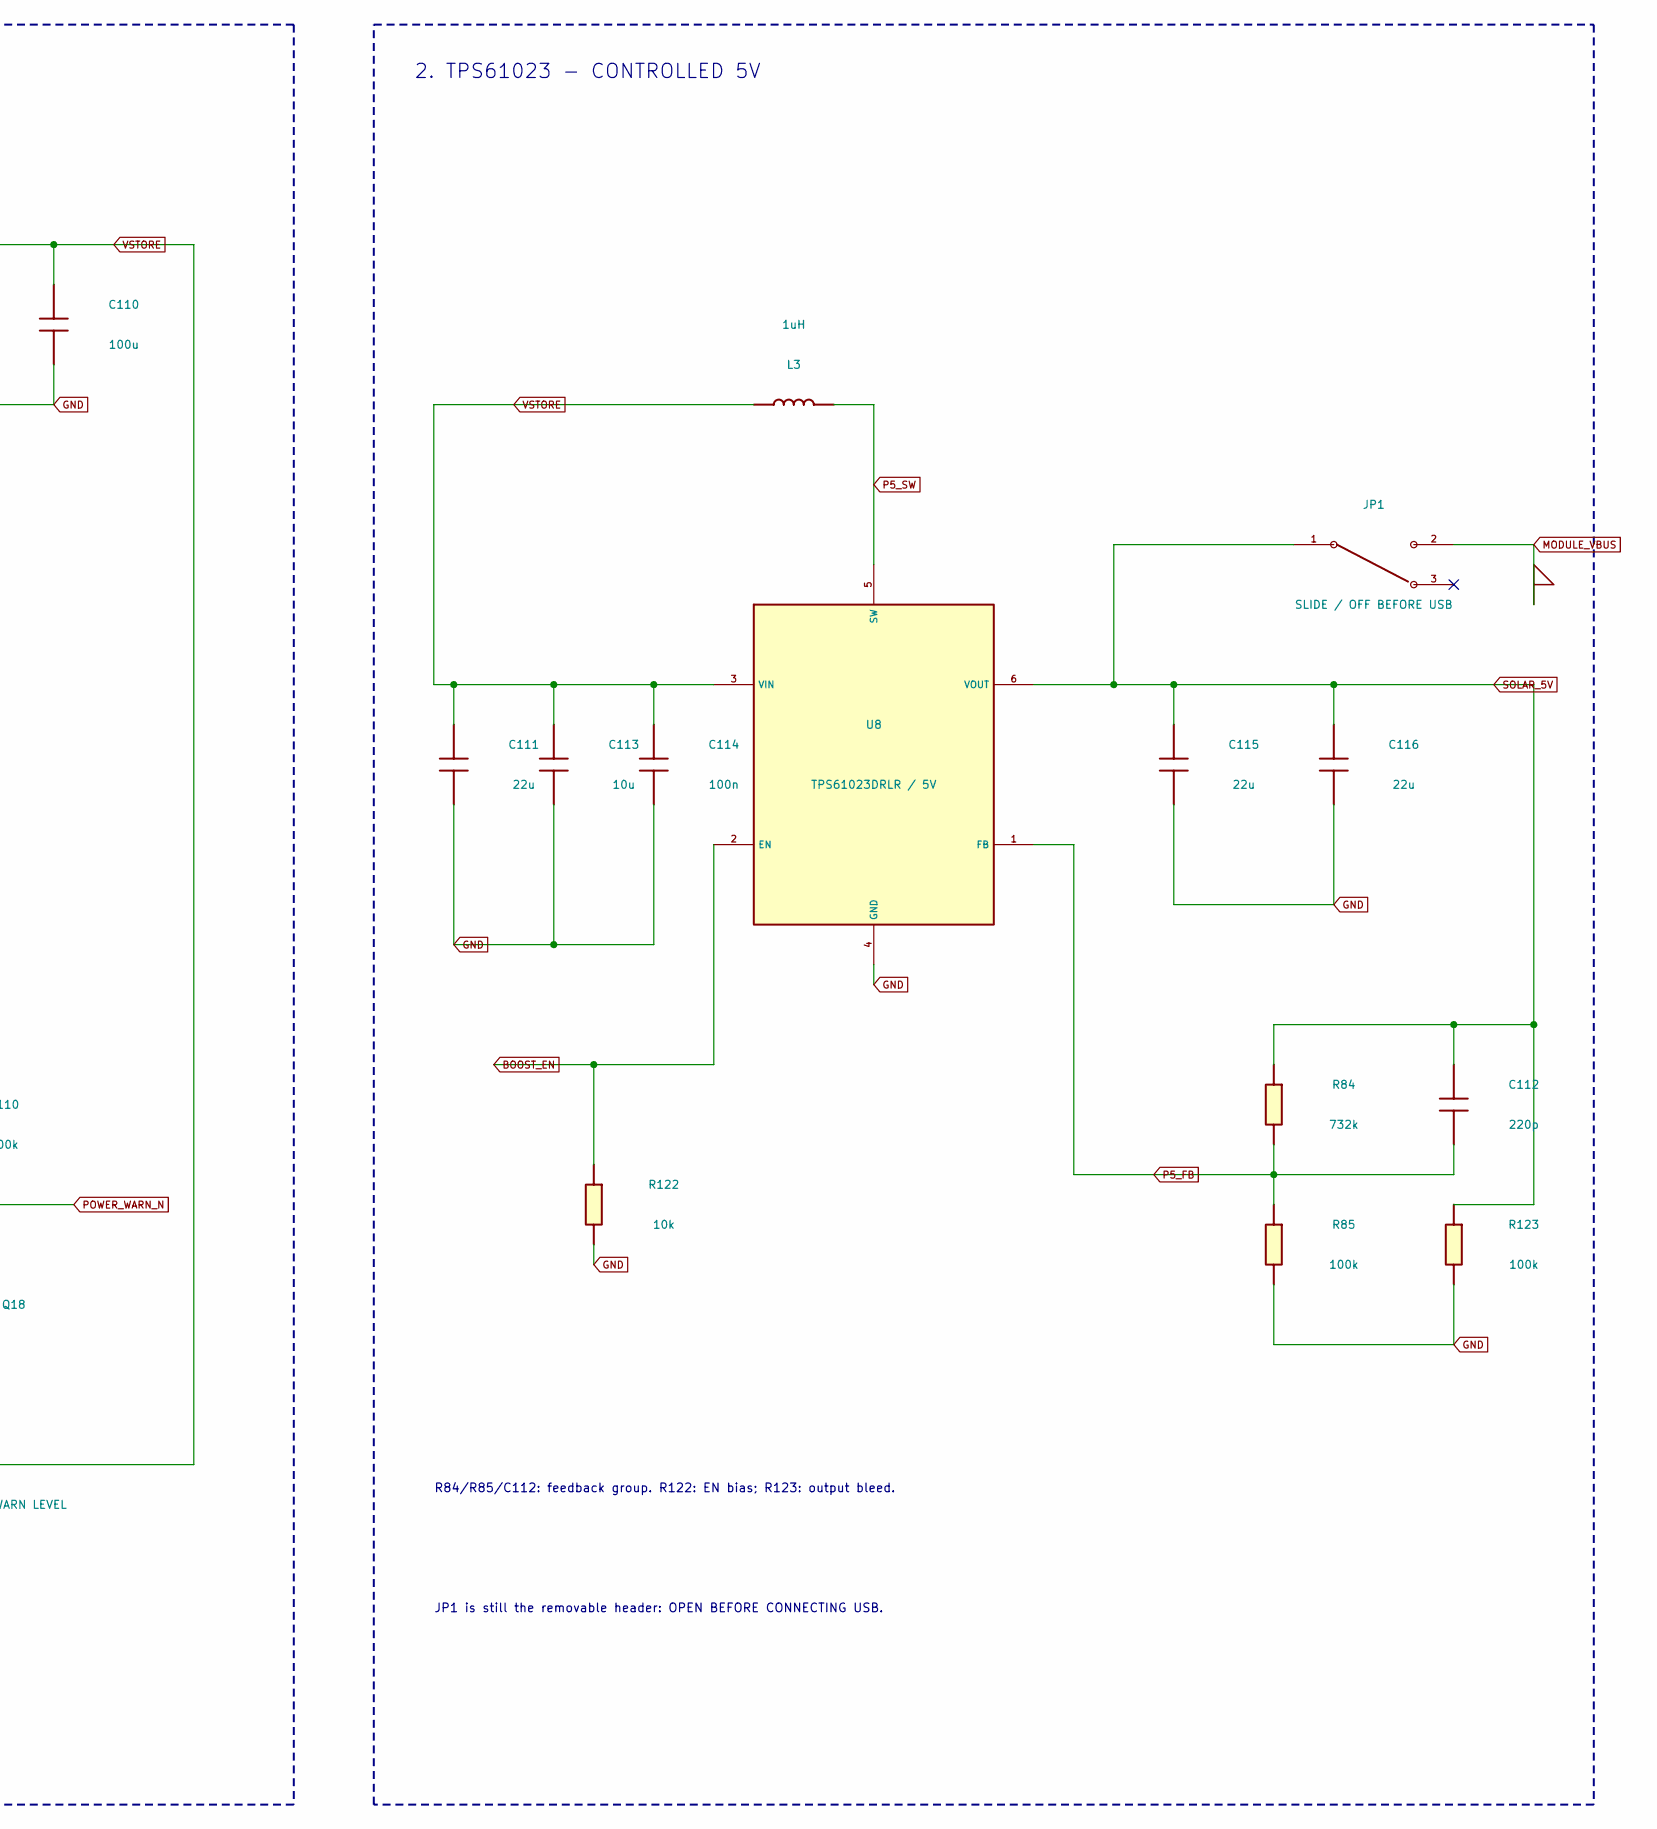
[picture p49: schematic power.kicad_sch, POWER: AEM harvest + TPS61023 5V, part in row 1, column 2]

Parts:
C1, C2, C3: 1.5F 5V PHB; PHB_5R0V155_R_LaidDown_Provisional; MPN PHB-5R0V155-R
C104, C111, C115, C116: 22u; C_1210_3225Metric; MPN GRM32ER61A226KE20L
C105, C106, C107, C108, C113: 10u; C_0805_2012Metric; MPN GRM21BR61C106KE15L
C109, C110: 100u; C_1210_3225Metric; MPN GRM32ER60J107ME20L
C112: 220p; C_0603_1608Metric; MPN GRM1885C1H221JA01D
C114: 100n; C_0805_2012Metric; MPN GRM21BR71H104KA01L
JP1: SLIDE / OFF BEFORE USB; EGJ1210AAG2R_Side; MPN EGJ1210AAG2R
L1: 22uH; L_Coilcraft_LPS4018; MPN LPS4018-223MRC
L2: 10uH; L_TDK_MLZ1608; MPN MLZ1608N100LT000
L3: 1uH; Coilcraft_XEL4030; MPN XEL4030-102MEC
Q18: AO3400A / WARN LEVEL; SOT-23; MPN AO3400A
R80: 549k; R_1206_3216Metric; MPN TNPW1206549KBEEA
R81: 9.31k; R_1206_3216Metric; MPN TNPW12069K31BEEA
R82: 143k; R_1206_3216Metric; MPN TNPW1206143KBEEA
R83: 1.74M; R_1206_3216Metric; MPN TNPW12061M74BEEA
R84: 732k; R_0603_1608Metric; MPN RC0603FR-07732KL
R85, R110, R123: 100k; R_0603_1608Metric; MPN RC0603FR-07100KL
R111: 1M; R_0603_1608Metric; MPN RC0603FR-071ML
R122: 10k; R_0603_1608Metric; MPN RC0603FR-0710KL
U7: AEM10941 / CFG=000; AEM10941_QFN28_EP3.5; MPN 10AEM10941C0001
U8: TPS61023DRLR / 5V; SOT-563; MPN TPS61023DRLR

Connections:
+3V3: R110.2; also elsewhere on the board
BOOST_EN: R122.1, U8.2 (EN); also elsewhere on the board
GND: C1.2 (-), C2.2 (-), C3.2 (-), C104.2, C105.2, C106.2, C107.2, C108.2, C109.2, C110.2, C111.2, C113.2, C114.2, C115.2, C116.2, Q18.2 (S), R80.2, R85.2, R111.2, R122.2, R123.2, U7.4 (CFG2), U7.5 (CFG1), U7.6 (CFG0), U7.7 (SELMPP1), U7.8 (SELMPP0), U7.9 (FB_PRIM_D), U7.10 (FB_PRIM_U), U7.12 (ENHV), U7.15 (BAL), U7.17 (PRIM), U7.18 (ENLV), U7.29 (EP_GND), U8.4 (GND); also elsewhere on the board
HARV_P: U7.25 (SRC1), U7.26 (SRC2); also elsewhere on the board
MODULE_VBUS: JP1.2 (ON_MODULE_VBUS); also elsewhere on the board
P5_FB: C112.2, R84.2, R85.1, U8.1 (FB)
P5_SW: L3.2, U8.5 (SW)
PM_BOOST: C104.1, R83.1, U7.1 (BOOST)
PM_BUCK: C106.1, L2.2, U7.3 (BUCK)
PM_BUFSRC: C105.1, L1.1, U7.27 (BUFSRC)
PM_HVOUT: C108.1, U7.14 (HVOUT)
PM_LVOUT: C107.1, U7.11 (LVOUT)
PM_READY: U7.21 (STATUS0); also elsewhere on the board
PM_SWBOOST: L1.2, U7.28 (SWBOOST)
PM_SWBUCK: L2.1, U7.2 (SWBUCK)
PM_WARN: Q18.1 (G), R111.1, U7.20 (STATUS1)
POWER_WARN_N: Q18.3 (D), R110.1; also elsewhere on the board
SET_CHRDY: R81.1, R82.2, U7.23 (SET_CHRDY)
SET_OVCH: R80.1, R81.2, U7.22 (SET_OVCH)
SET_OVDIS: R82.1, R83.2, U7.24 (SET_OVDIS)
SOLAR_5V: C112.1, C115.1, C116.1, JP1.1 (COM_SOLAR_5V), R84.1, R123.1, U8.6 (VOUT)
VSTORE: C1.1 (+), C2.1 (+), C3.1 (+), C109.1, C110.1, C111.1, C113.1, C114.1, L3.1, U7.16 (BATT), U8.3 (VIN); also elsewhere on the board

Notes on the sheet:
JP1 is still the removable header: OPEN BEFORE CONNECTING USB.
2. TPS61023 - CONTROLLED 5V
1. AEM10941 - HARVEST / CHARGER
CFG=000; MPPT=70% Voc. Bottom configuration pins wired individually to GND.
R84/R85/C112: feedback group. R122: EN bias; R123: output bleed.
C1/C2/C3: three complete PHB packs in PARALLEL; 4.5F / 5V.

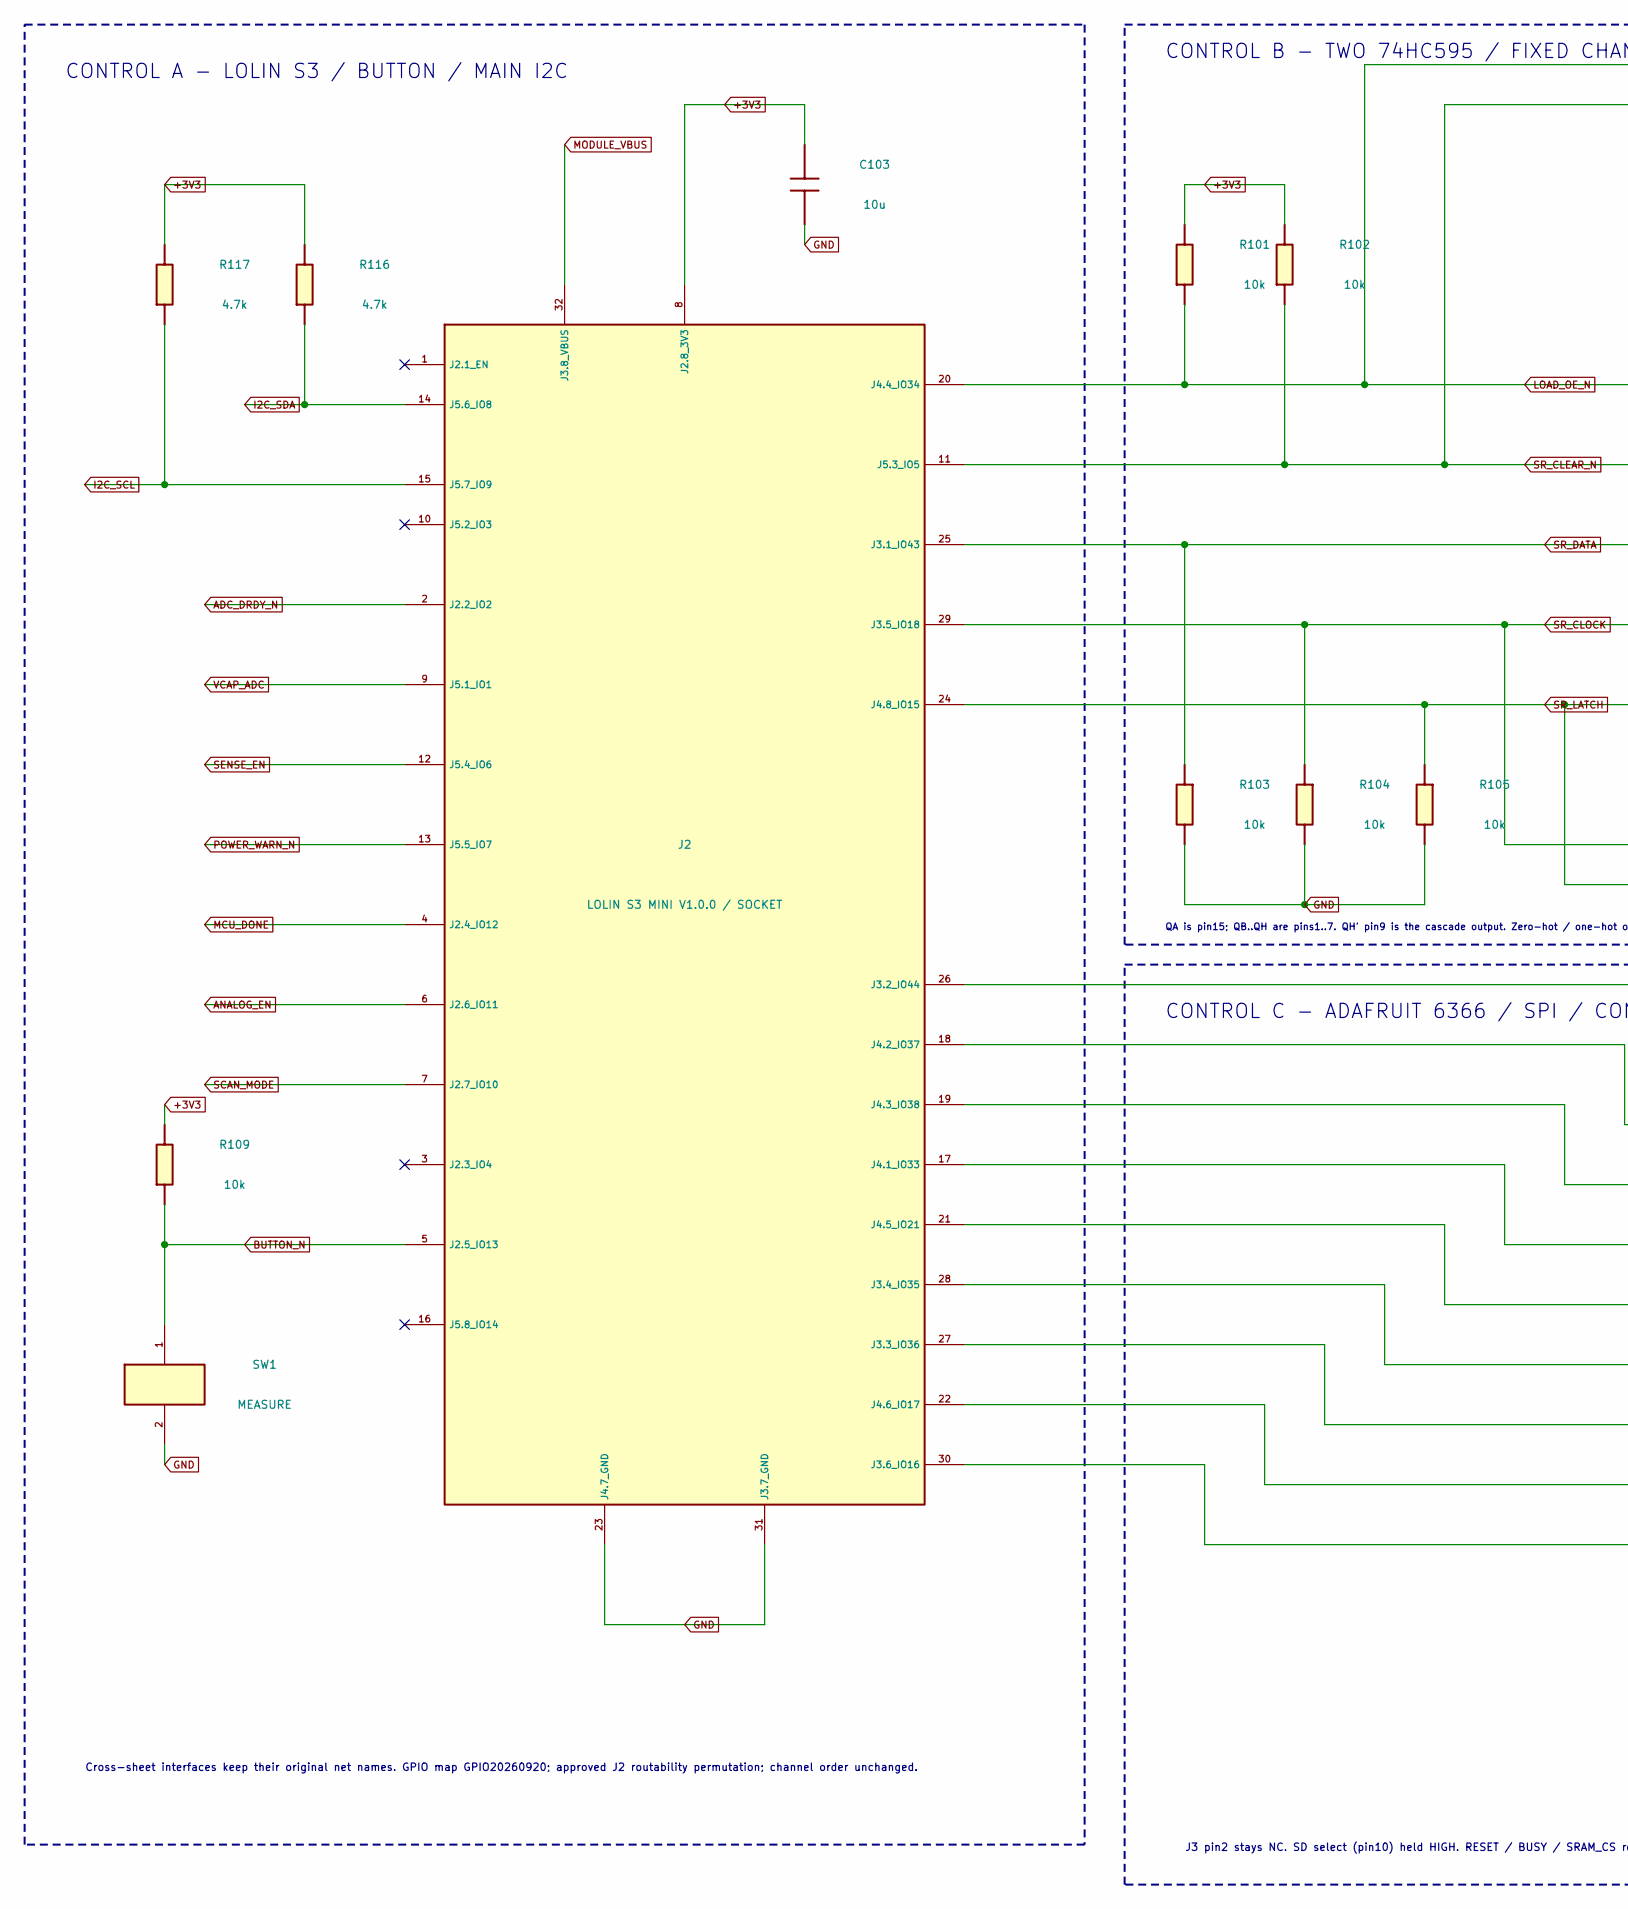
[picture p50: schematic control.kicad_sch, CONTROL: LOLIN / 595 cascade / ePaper, part in row 1, column 1]

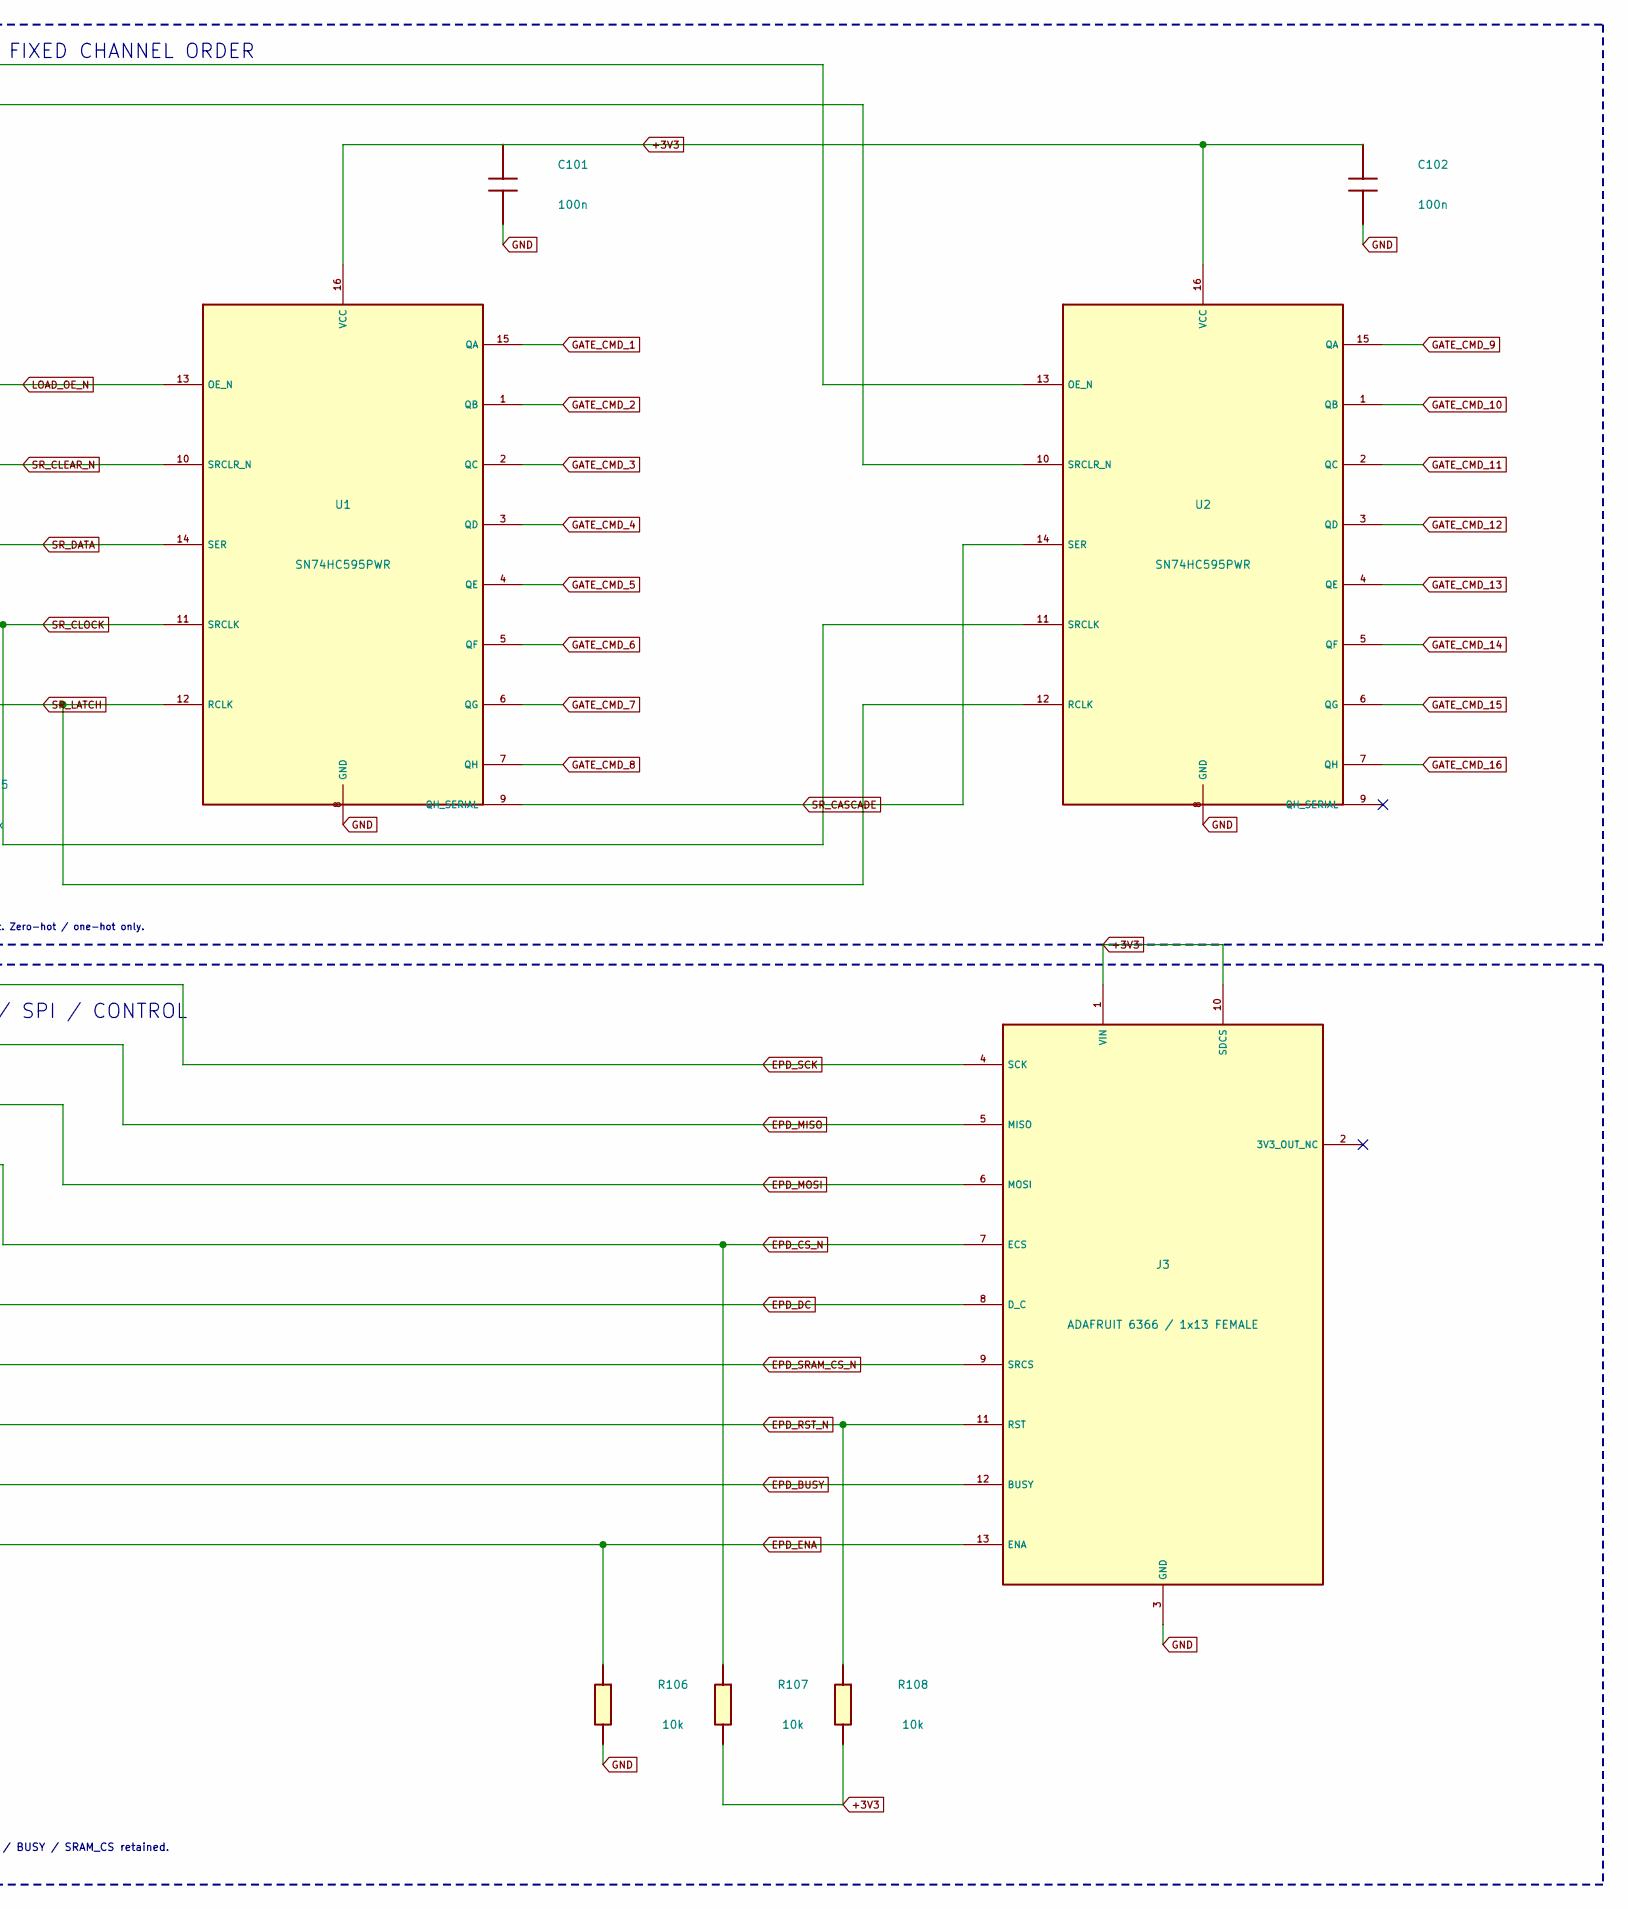
[picture p51: schematic control.kicad_sch, CONTROL: LOLIN / 595 cascade / ePaper, part in row 1, column 2]

Parts:
C101, C102: 100n; C_0805_2012Metric; MPN GRM21BR71H104KA01L
C103: 10u; C_0805_2012Metric; MPN GRM21BR61C106KE15L
J2: LOLIN S3 MINI V1.0.0 / SOCKET; LOLIN_S3_Mini_V1; MPN LOLIN S3 MINI V1.0.0
J3: ADAFRUIT 6366 / 1x13 FEMALE; EPD_6366_Socket13; MPN SSW-113-01-T-S
R101, R102, R103, R104, R105, R106, R107, R108, R109: 10k; R_0603_1608Metric; MPN RC0603FR-0710KL
R116, R117: 4.7k; R_0603_1608Metric; MPN RC0603FR-074K7L
SW1: MEASURE; SW_SPST_TL3342; MPN TL3342F160QG
U1, U2: SN74HC595PWR; TSSOP-16_4.4x5mm_P0.65mm; MPN SN74HC595PWR

Connections:
+3V3: C101.1, C102.1, C103.1, J2.8 (J2.8_3V3), J3.1 (VIN), J3.10 (SDCS), R101.2, R102.2, R107.2, R108.2, R109.2, R116.2, R117.2, U1.16 (VCC), U2.16 (VCC); also elsewhere on the board
ADC_DRDY_N: J2.2 (J2.2_IO2); also elsewhere on the board
ANALOG_EN: J2.6 (J2.6_IO11); also elsewhere on the board
BUTTON_N: J2.5 (J2.5_IO13), R109.1, SW1.1 (BUTTON)
EPD_BUSY: J2.22 (J4.6_IO17), J3.12 (BUSY)
EPD_CS_N: J2.17 (J4.1_IO33), J3.7 (ECS), R107.1
EPD_DC: J2.21 (J4.5_IO21), J3.8 (D_C)
EPD_ENA: J2.30 (J3.6_IO16), J3.13 (ENA), R106.1
EPD_MISO: J2.18 (J4.2_IO37), J3.5 (MISO)
EPD_MOSI: J2.19 (J4.3_IO38), J3.6 (MOSI)
EPD_RST_N: J2.27 (J3.3_IO36), J3.11 (RST), R108.1
EPD_SCK: J2.26 (J3.2_IO44), J3.4 (SCK)
EPD_SRAM_CS_N: J2.28 (J3.4_IO35), J3.9 (SRCS)
GATE_CMD_1: U1.15 (QA); also elsewhere on the board
GATE_CMD_2: U1.1 (QB); also elsewhere on the board
GATE_CMD_3: U1.2 (QC); also elsewhere on the board
GATE_CMD_4: U1.3 (QD); also elsewhere on the board
GATE_CMD_5: U1.4 (QE); also elsewhere on the board
GATE_CMD_6: U1.5 (QF); also elsewhere on the board
GATE_CMD_7: U1.6 (QG); also elsewhere on the board
GATE_CMD_8: U1.7 (QH); also elsewhere on the board
GATE_CMD_9: U2.15 (QA); also elsewhere on the board
GATE_CMD_10: U2.1 (QB); also elsewhere on the board
GATE_CMD_11: U2.2 (QC); also elsewhere on the board
GATE_CMD_12: U2.3 (QD); also elsewhere on the board
GATE_CMD_13: U2.4 (QE); also elsewhere on the board
GATE_CMD_14: U2.5 (QF); also elsewhere on the board
GATE_CMD_15: U2.6 (QG); also elsewhere on the board
GATE_CMD_16: U2.7 (QH); also elsewhere on the board
GND: C101.2, C102.2, C103.2, J2.23 (J4.7_GND), J2.31 (J3.7_GND), J3.3 (GND), R103.2, R104.2, R105.2, R106.2, SW1.2 (GND), U1.8 (GND), U2.8 (GND); also elsewhere on the board
I2C_SCL: J2.15 (J5.7_IO9), R117.1; also elsewhere on the board
I2C_SDA: J2.14 (J5.6_IO8), R116.1; also elsewhere on the board
LOAD_OE_N: J2.20 (J4.4_IO34), R101.1, U1.13 (OE_N), U2.13 (OE_N)
MCU_DONE: J2.4 (J2.4_IO12); also elsewhere on the board
MODULE_VBUS: J2.32 (J3.8_VBUS); also elsewhere on the board
POWER_WARN_N: J2.13 (J5.5_IO7); also elsewhere on the board
SCAN_MODE: J2.7 (J2.7_IO10); also elsewhere on the board
SENSE_EN: J2.12 (J5.4_IO6); also elsewhere on the board
SR_CASCADE: U1.9 (QH_SERIAL), U2.14 (SER)
SR_CLEAR_N: J2.11 (J5.3_IO5), R102.1, U1.10 (SRCLR_N), U2.10 (SRCLR_N)
SR_CLOCK: J2.29 (J3.5_IO18), R104.1, U1.11 (SRCLK), U2.11 (SRCLK)
SR_DATA: J2.25 (J3.1_IO43), R103.1, U1.14 (SER)
SR_LATCH: J2.24 (J4.8_IO15), R105.1, U1.12 (RCLK), U2.12 (RCLK)
VCAP_ADC: J2.9 (J5.1_IO1); also elsewhere on the board

Notes on the sheet:
J3 pin2 stays NC. SD select (pin10) held HIGH. RESET / BUSY / SRAM_CS retained.
Cross-sheet interfaces keep their original net names. GPIO map GPIO20260920; approved J2 routability permutation; channel order unchanged.
QA is pin15; QB..QH are pins1..7. QH' pin9 is the cascade output. Zero-hot / one-hot only.
CONTROL B - TWO 74HC595 / FIXED CHANNEL ORDER
CONTROL C - ADAFRUIT 6366 / SPI / CONTROL
CONTROL A - LOLIN S3 / BUTTON / MAIN I2C
