weiweiweiopen/Solar-Oracle-Walkman-1.0/hardware/solar-oracle-walkman-relay.kicad_pcb

## KiCad design hardware/solar-oracle-walkman-relay.kicad_pcb (continued)

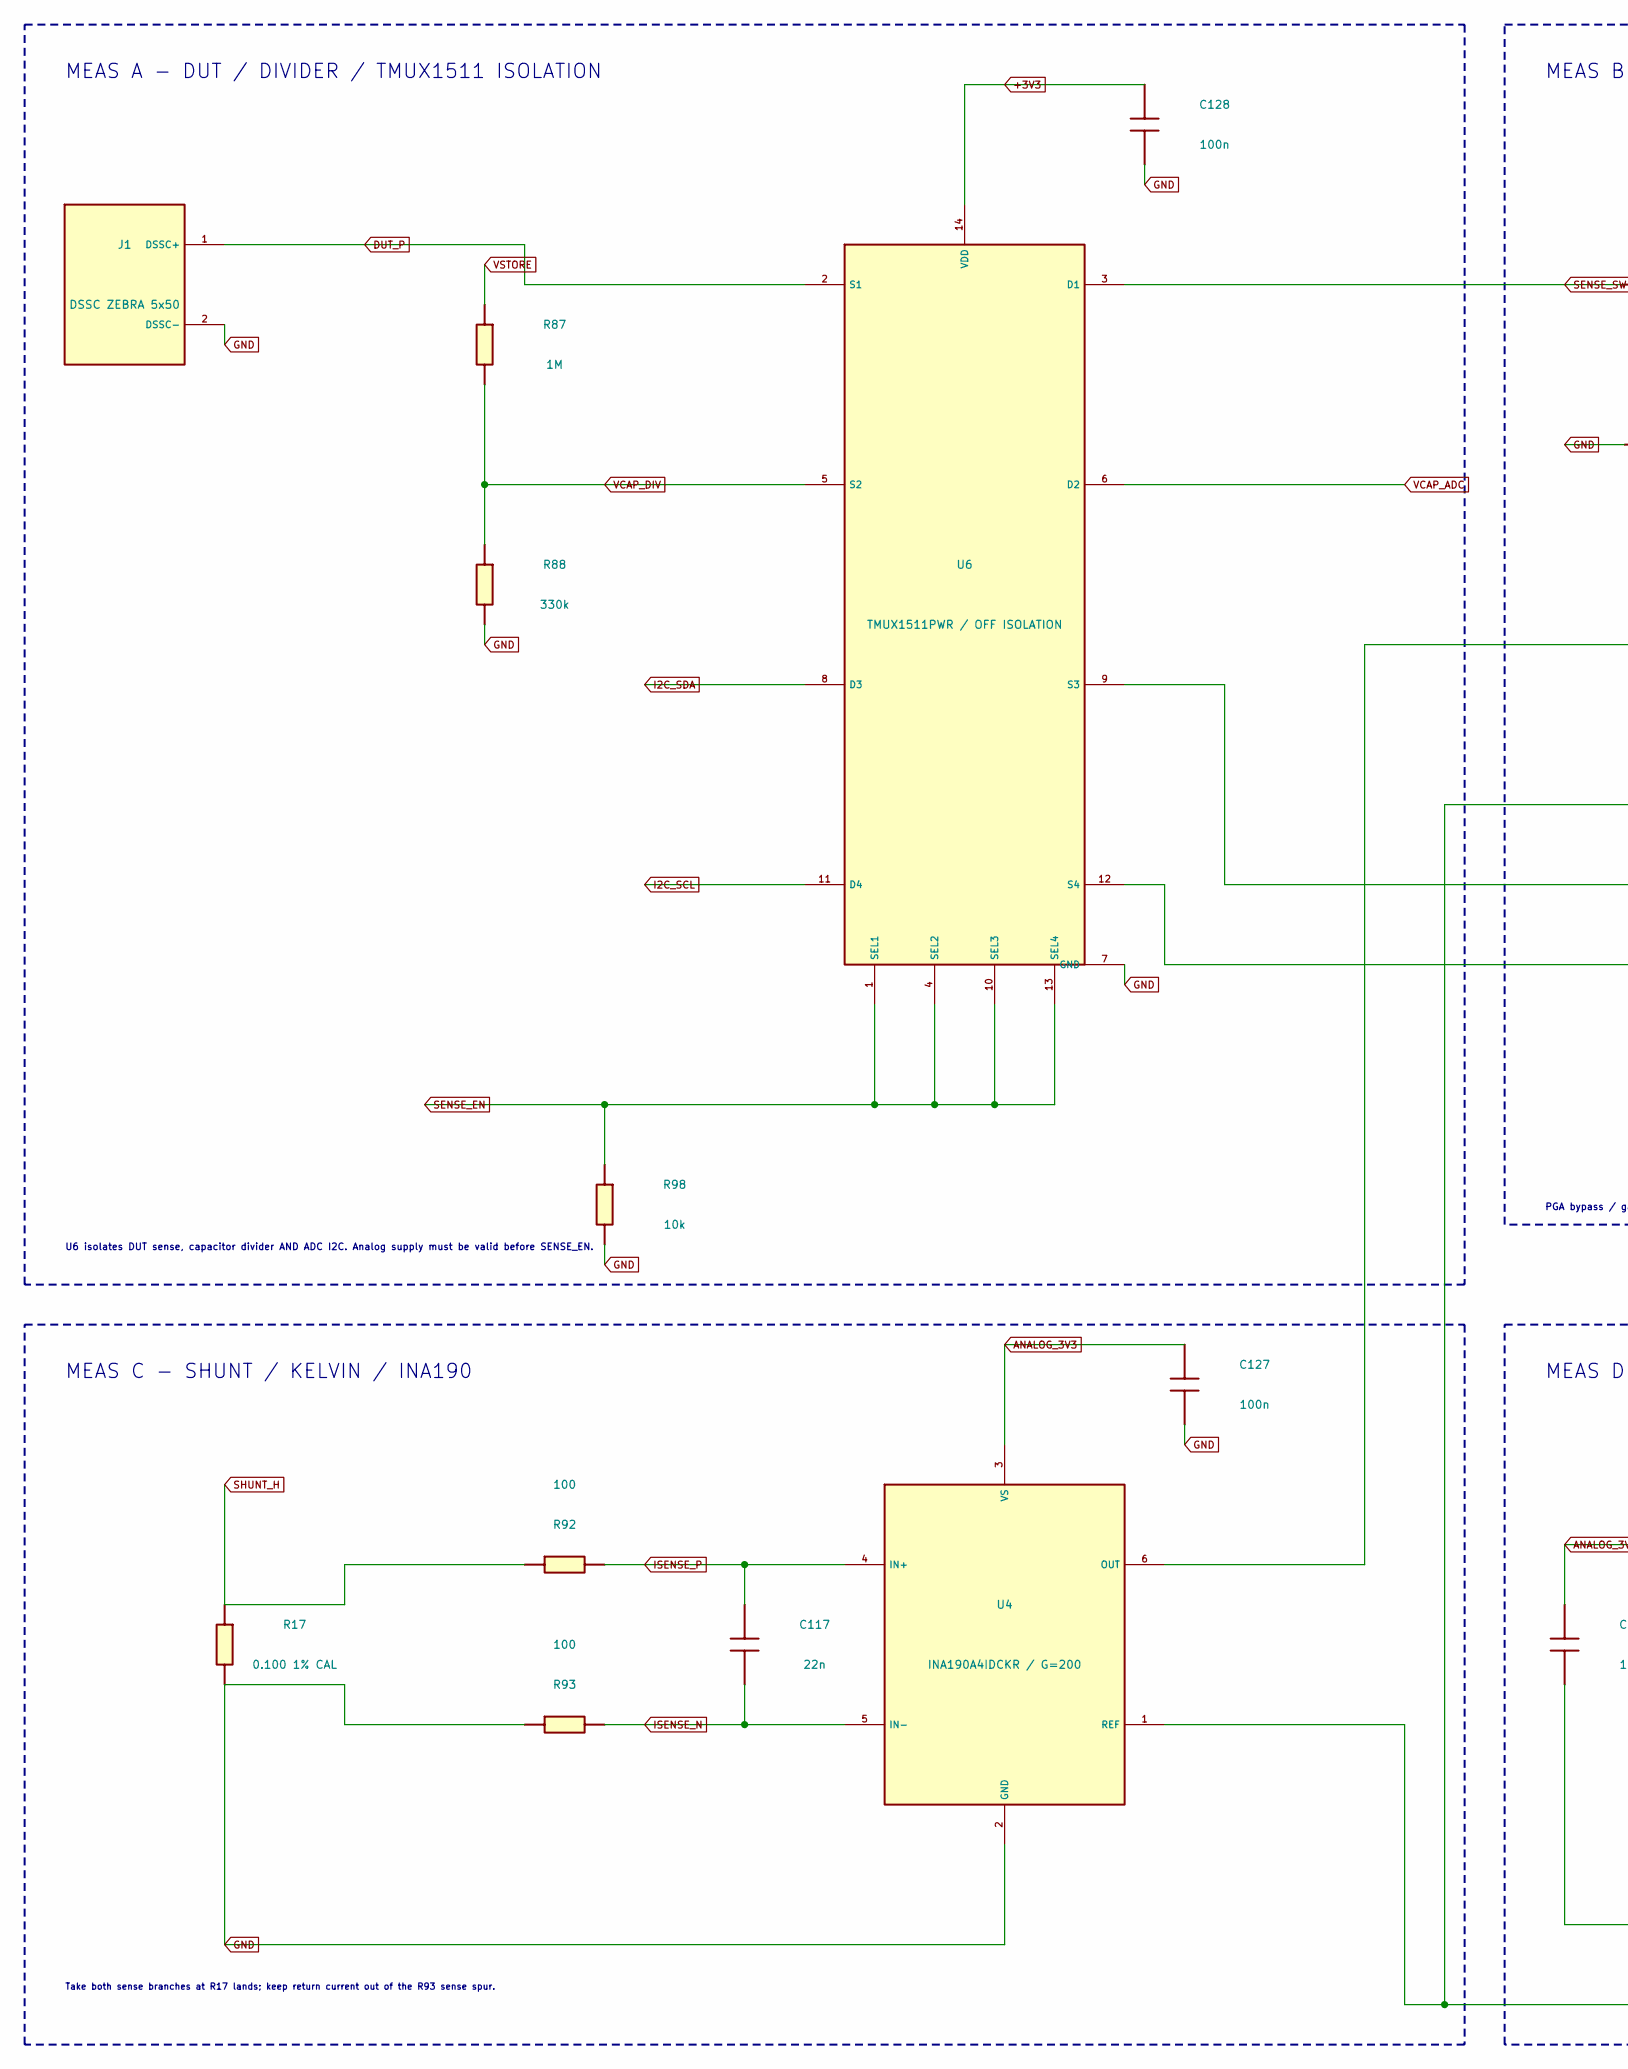
[picture p52: schematic measurement.kicad_sch, MEASUREMENT: isolation / ADC / INA / reference / supply, part in row 1, column 1]

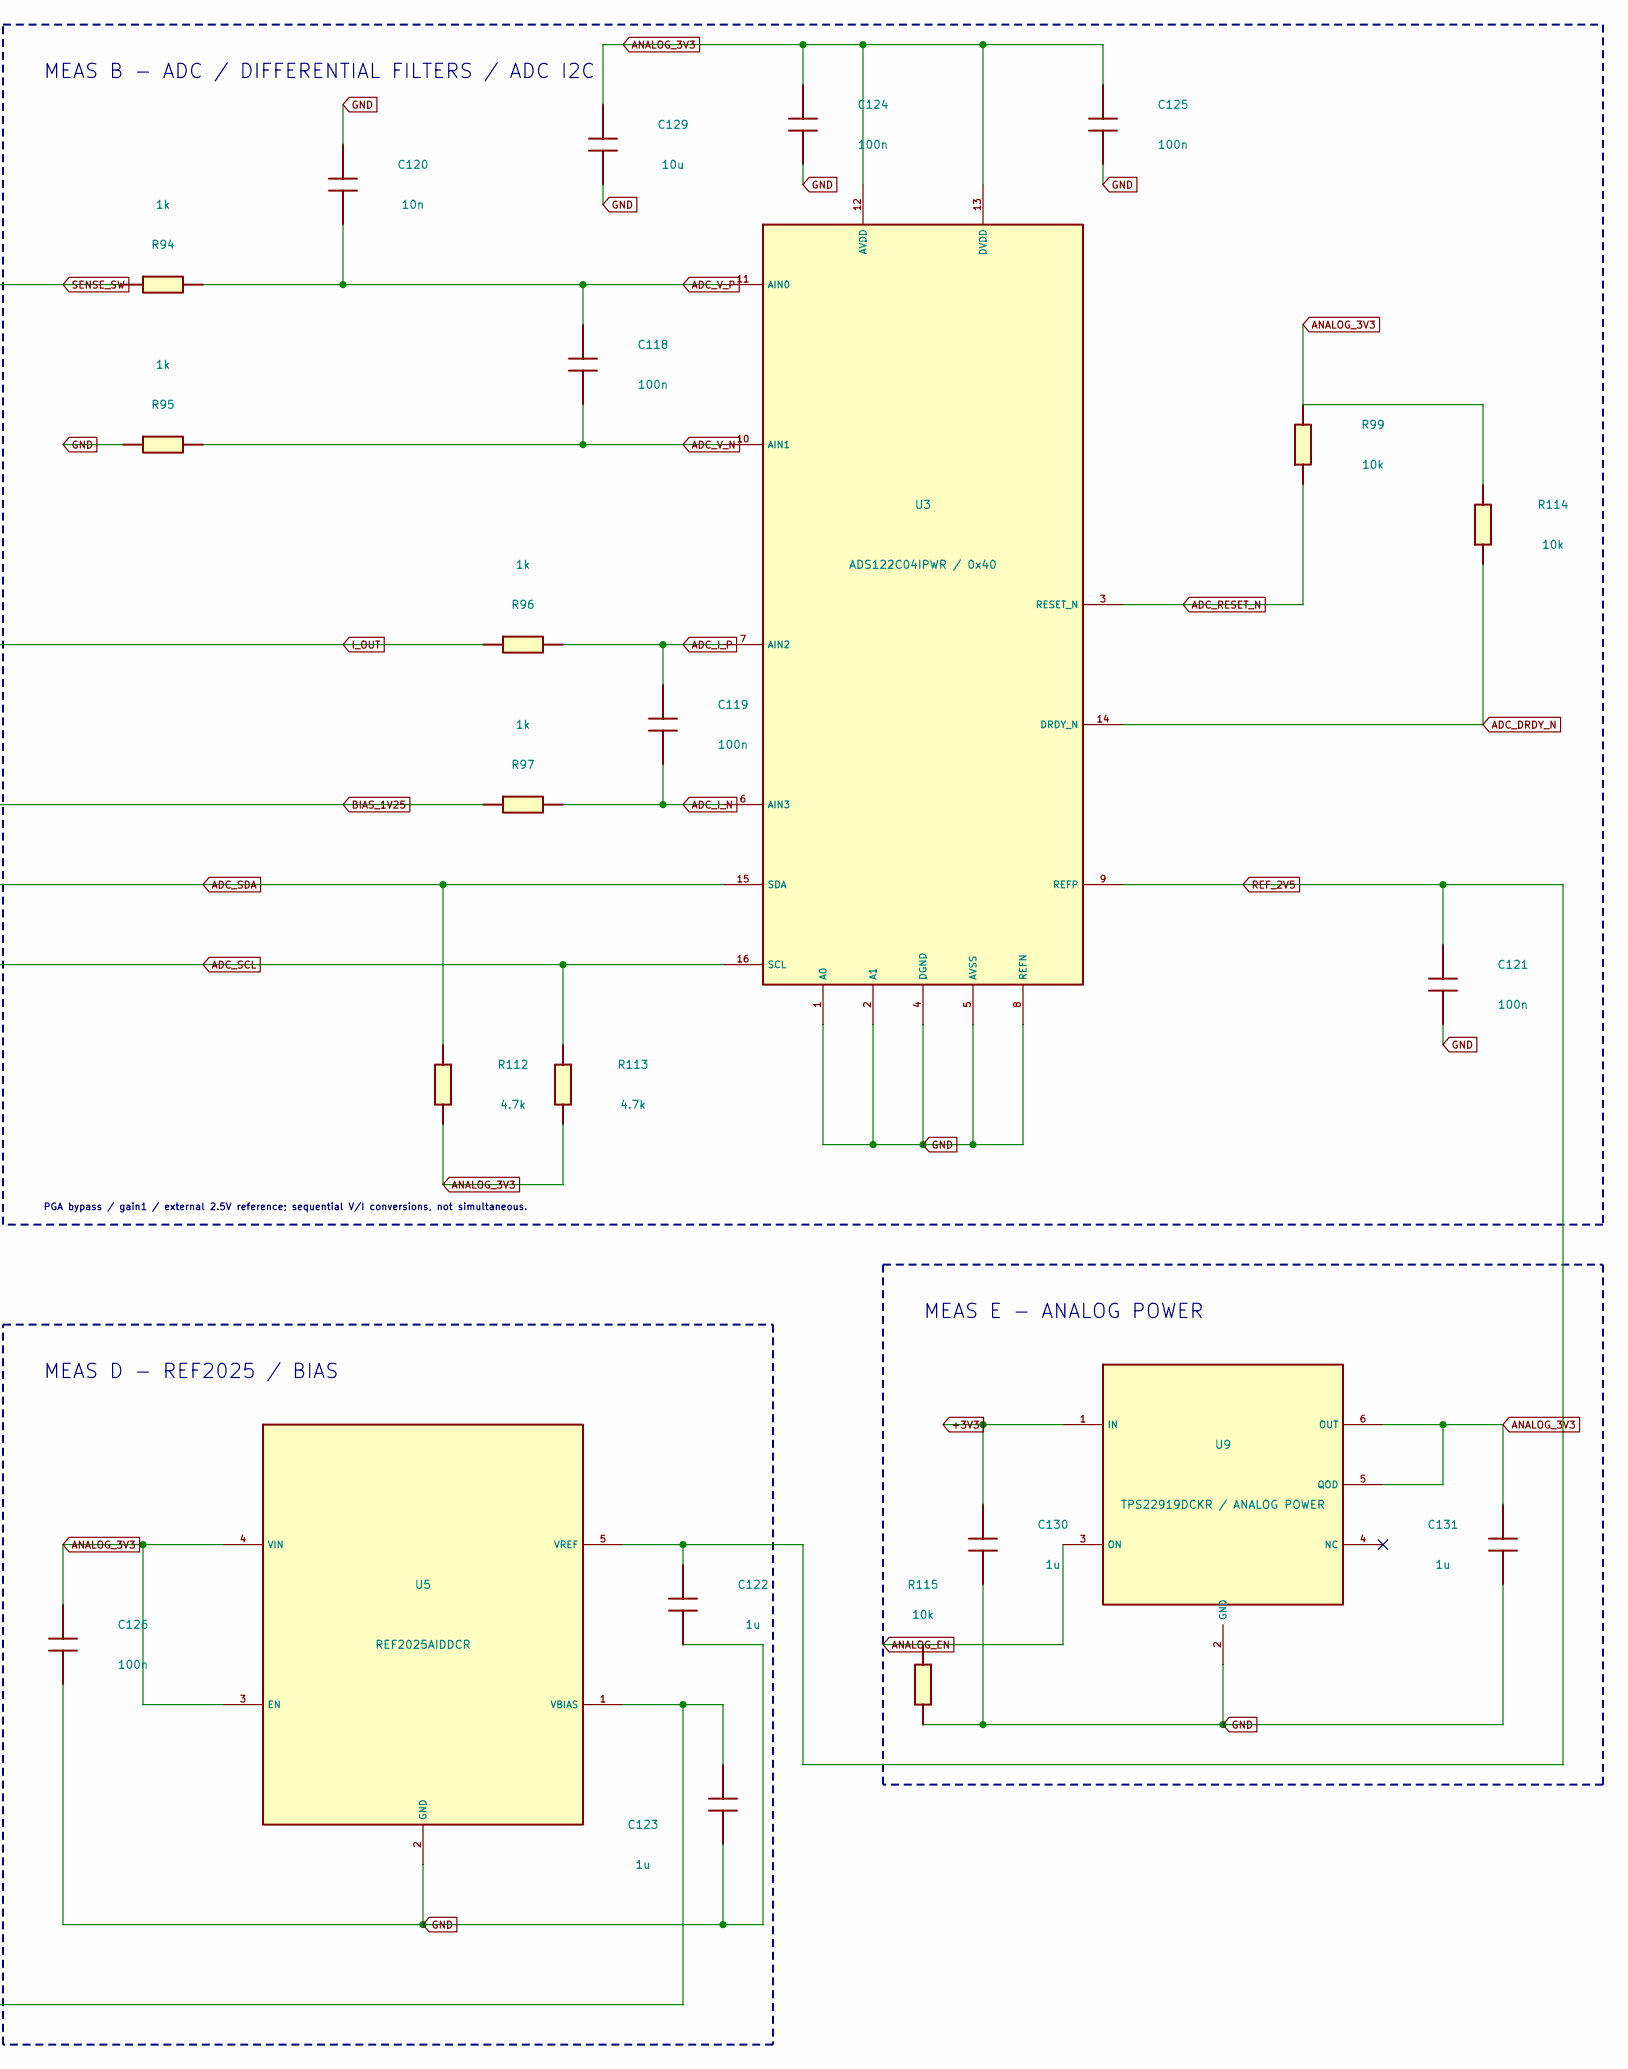
[picture p53: schematic measurement.kicad_sch, MEASUREMENT: isolation / ADC / INA / reference / supply, part in row 1, column 2]

Parts:
C117: 22n; C_0805_2012Metric; MPN GRM21BR71H223KA01L
C118, C119, C121, C124, C125, C126, C127, C128: 100n; C_0805_2012Metric; MPN GRM21BR71H104KA01L
C120: 10n; C_0805_2012Metric; MPN GRM21BR71H103KA01L
C122, C123, C130, C131: 1u; C_0805_2012Metric; MPN GRM21BR71C105KA01L
C129: 10u; C_0805_2012Metric; MPN GRM21BR61C106KE15L
J1: DSSC ZEBRA 5x50; DSSC_Zebra_5x50; MPN PCB_ENIG_CONTACT
R17: 0.100 1% CAL; WSL1206; MPN WSL1206R1000FEA
R87: 1M; R_0603_1608Metric; MPN RC0603FR-071ML
R88: 330k; R_0603_1608Metric; MPN RC0603FR-07330KL
R92, R93: 100; R_0603_1608Metric; MPN RC0603FR-07100RL
R94, R95, R96, R97: 1k; R_0603_1608Metric; MPN RC0603FR-071KL
R98, R99, R114, R115: 10k; R_0603_1608Metric; MPN RC0603FR-0710KL
R112, R113: 4.7k; R_0603_1608Metric; MPN RC0603FR-074K7L
U3: ADS122C04IPWR / 0x40; TSSOP-16_4.4x5mm_P0.65mm; MPN ADS122C04IPWR
U4: INA190A4IDCKR / G=200; SOT-363_SC-70-6; MPN INA190A4IDCKR
U5: REF2025AIDDCR; SOT-23-5; MPN REF2025AIDDCR
U6: TMUX1511PWR / OFF ISOLATION; TSSOP-14_4.4x5mm_P0.65mm; MPN TMUX1511PWR
U9: TPS22919DCKR / ANALOG POWER; SOT-363_SC-70-6; MPN TPS22919DCKR

Connections:
+3V3: C128.1, C130.1, U6.14 (VDD), U9.1 (IN); also elsewhere on the board
ADC_DRDY_N: R114.1, U3.14 (DRDY_N); also elsewhere on the board
ADC_I_N: C119.2, R97.2, U3.6 (AIN3)
ADC_I_P: C119.1, R96.2, U3.7 (AIN2)
ADC_RESET_N: R99.1, U3.3 (RESET_N)
ADC_SCL: R113.1, U3.16 (SCL), U6.12 (S4)
ADC_SDA: R112.1, U3.15 (SDA), U6.9 (S3)
ADC_V_N: C118.2, R95.2, U3.10 (AIN1)
ADC_V_P: C118.1, C120.1, R94.2, U3.11 (AIN0)
ANALOG_3V3: C124.1, C125.1, C126.1, C127.1, C129.1, C131.1, R99.2, R112.2, R113.2, R114.2, U3.12 (AVDD), U3.13 (DVDD), U4.3 (VS), U5.3 (EN), U5.4 (VIN), U9.5 (QOD), U9.6 (OUT)
ANALOG_EN: R115.1, U9.3 (ON); also elsewhere on the board
BIAS_1V25: C123.1, R97.1, U4.1 (REF), U5.1 (VBIAS)
DUT_P: J1.1 (DSSC+), U6.2 (S1); also elsewhere on the board
GND: C120.2, C121.2, C122.2, C123.2, C124.2, C125.2, C126.2, C127.2, C128.2, C129.2, C130.2, C131.2, J1.2 (DSSC-), R17.2, R88.2, R93.1, R95.1, R98.2, R115.2, U3.1 (A0), U3.2 (A1), U3.4 (DGND), U3.5 (AVSS), U3.8 (REFN), U4.2 (GND), U5.2 (GND), U6.7 (GND), U9.2 (GND); also elsewhere on the board
I2C_SCL: U6.11 (D4); also elsewhere on the board
I2C_SDA: U6.8 (D3); also elsewhere on the board
ISENSE_N: C117.2, R93.2, U4.5 (IN-)
ISENSE_P: C117.1, R92.2, U4.4 (IN+)
I_OUT: R96.1, U4.6 (OUT)
REF_2V5: C121.1, C122.1, U3.9 (REFP), U5.5 (VREF)
SENSE_EN: R98.1, U6.1 (SEL1), U6.4 (SEL2), U6.10 (SEL3), U6.13 (SEL4); also elsewhere on the board
SENSE_SW: R94.1, U6.3 (D1)
SHUNT_H: R17.1, R92.1; also elsewhere on the board
VCAP_ADC: U6.6 (D2); also elsewhere on the board
VCAP_DIV: R87.2, R88.1, U6.5 (S2)
VSTORE: R87.1; also elsewhere on the board

Notes on the sheet:
MEAS D - REF2025 / BIAS
MEAS B - ADC / DIFFERENTIAL FILTERS / ADC I2C
PGA bypass / gain1 / external 2.5V reference; sequential V/I conversions, not simultaneous.
MEAS A - DUT / DIVIDER / TMUX1511 ISOLATION
MEAS C - SHUNT / KELVIN / INA190
MEAS E - ANALOG POWER
U6 isolates DUT sense, capacitor divider AND ADC I2C. Analog supply must be valid before SENSE_EN.
Take both sense branches at R17 lands; keep return current out of the R93 sense spur.

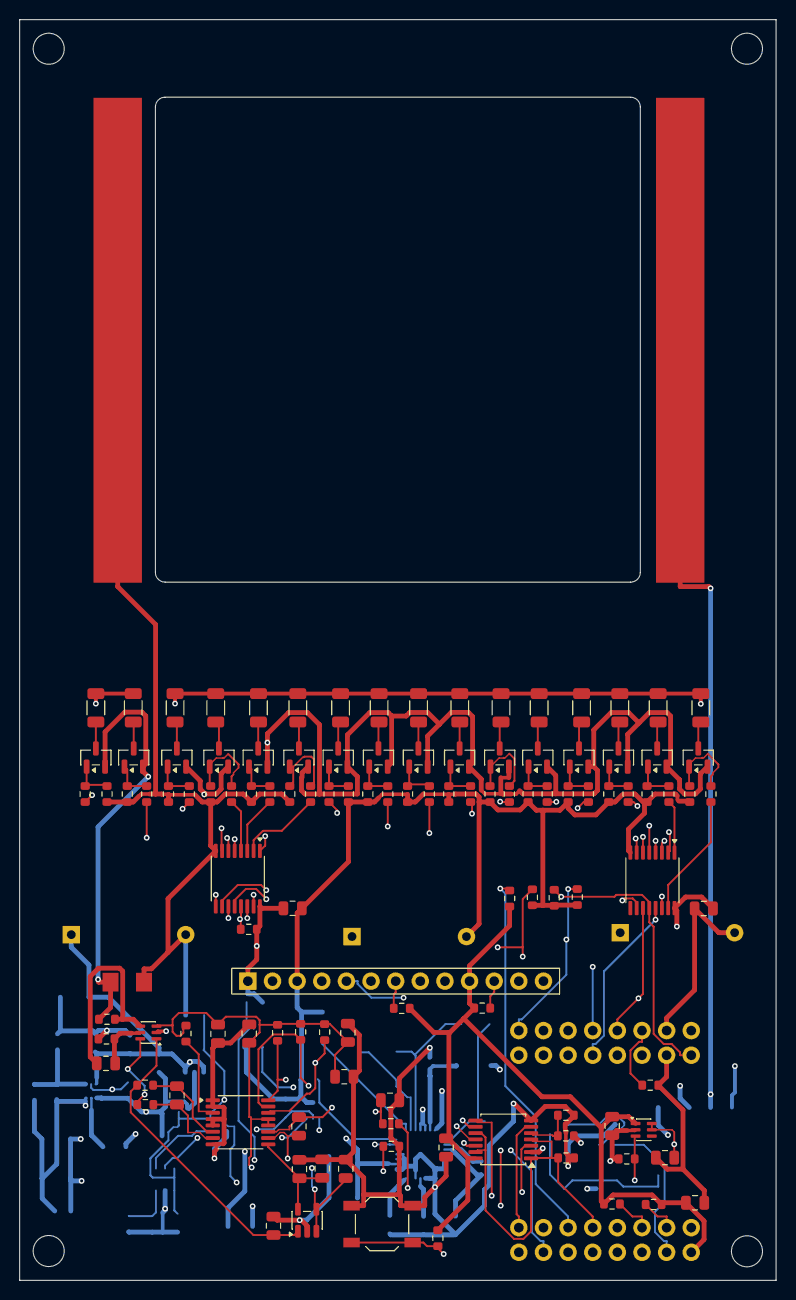
[picture p54: board solar-oracle-walkman-relay.kicad_pcb from above]

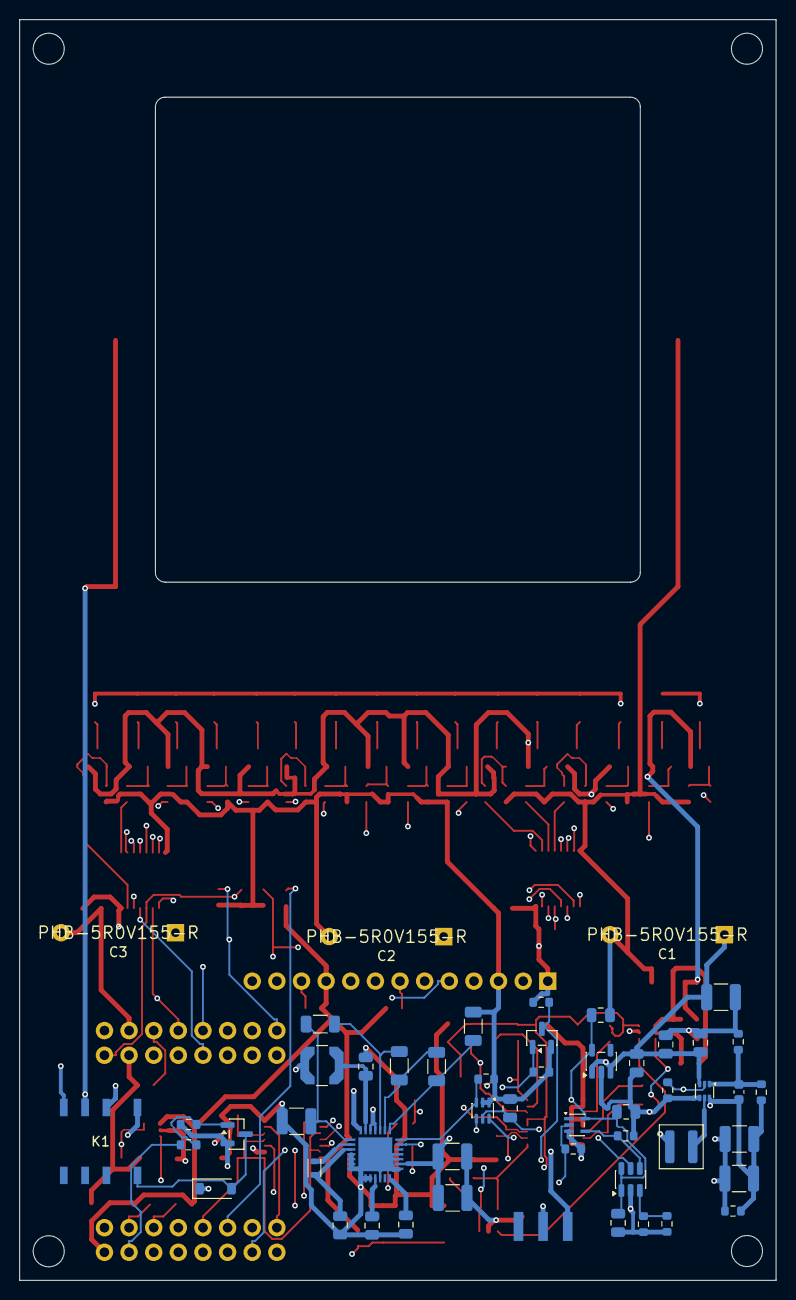
[picture p55: board solar-oracle-walkman-relay.kicad_pcb from below]

Board: 4 copper layers, 78.0 x 130.0 mm, 175 parts (52 on the bottom side), 118 nets.

Other parts of the board:
MH1, MH2, MH3, MH4: M3 D3.2 / HEAD5.5 / NO WASHER; Case_M3_D3.2_Head5.5
