weiweiweiopen/Solar-Oracle-Walkman-1.0/(commit log)

2026-09-20 Publish self-powered single-DSSC tester design
    [BOM.csv, Relay_DPDT_Omron_G6K-2F-Y.step, always_on.kicad_sch, control.kicad_sch, loads.kicad_sch, measurement.kicad_sch, pin_map.csv, power.kicad_sch]
2026-11-10 Publish Solar Oracle Walkman 1.0 hardware, R19 enclosure and RAW firmware sources
    [1206_負載電阻採購表.csv, AlwaysOn.kicad_sch, DisplayUI.kicad_sch, GPIO_韌體對照_20261018.csv, HarvestPower.kicad_sch, HarvestSwitch.kicad_sch, Lower_shell.step, Marc_USB.kicad_pcb]
